connornishijima/Pixie_Chroma/extras/reports/README.md

### Library status report: 
#### Any undocumented objects currently seen after every CI test will be marked here.
---------------------------------------------------------
- :heavy_check_mark: Doxygen
- :heavy_check_mark: Keywords
