connornishijima/Pixie_Chroma/extras/reports/doxygen/README.md

### Doxygen coverage report: 
#### Any undocumented objects currently seen by Doxygen will appear here after every CI test!
---------------------------------------------------------
:heavy_check_mark: **All checks passed, nothing left undocumented!**
