connornishijima/Pixie_Chroma/extras/reports/keywords/README.md

### Keyword coverage report: 
#### Any undocumented keywords currently seen will appear here after every CI test!
---------------------------------------------------------
:heavy_check_mark: **All checks passed, nothing left undocumented!**
