connornishijima/Pixie_Chroma/extras/OSHW/EVAL_BOARD/README.md

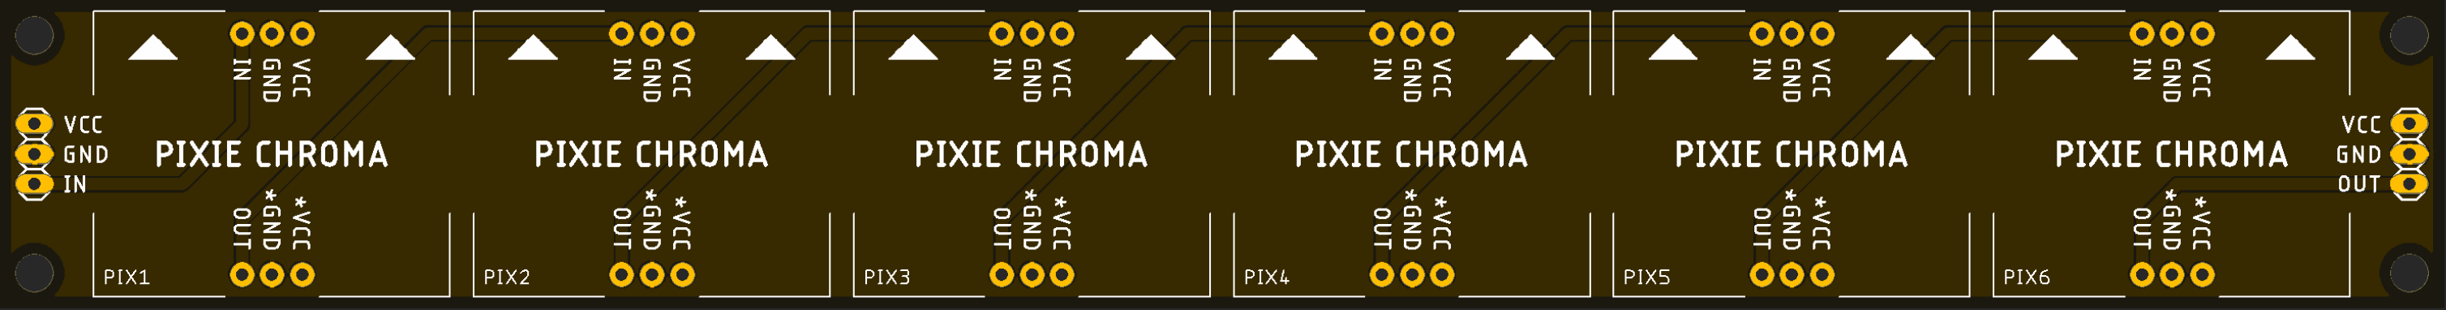
[picture p8: extras/OSHW/EVAL_BOARD/PCB.PNG]
PIXIE CHROMA EVAL PCB
