connornishijima/Pixie_Chroma/extras/OSHW/PCB/README.md

# Pixie Chroma PCB Files

Here you can find our OSHW files for building your own Pixie Chroma!

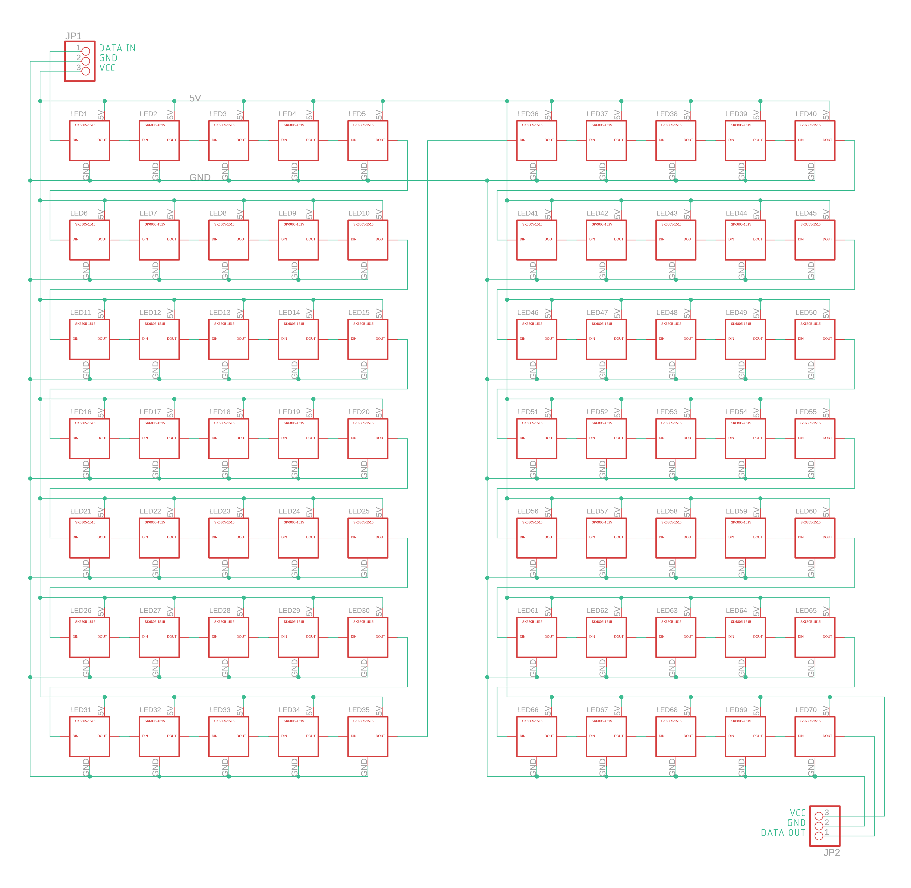
[picture p9: extras/img/schematic.png]
Schematic
