connornishijima/Pixie_Chroma/extras/img/close.png

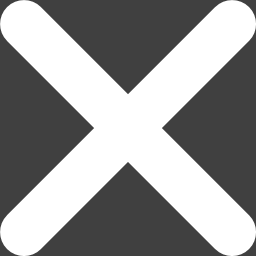
extras/img/close.png
