connornishijima/Pixie_Chroma/extras/img/modules.png

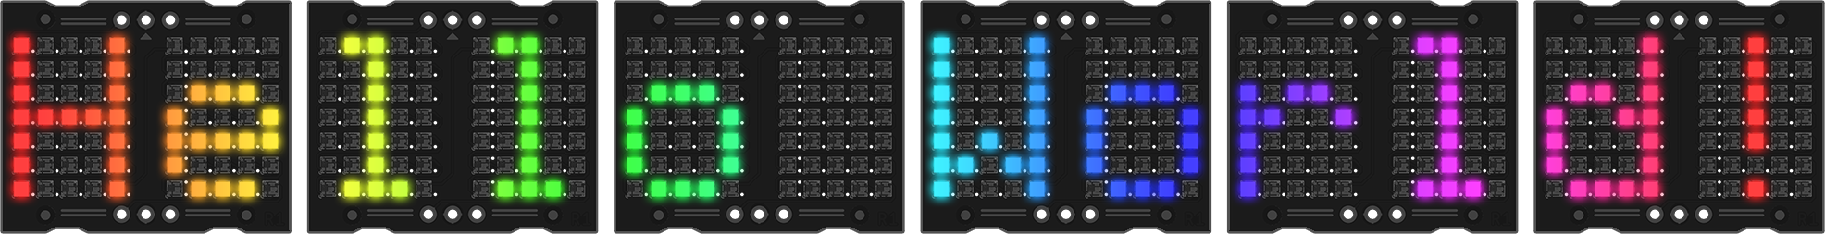
extras/img/modules.png
