connornishijima/Pixie_Chroma/extras/img/PCB_tranparent.png

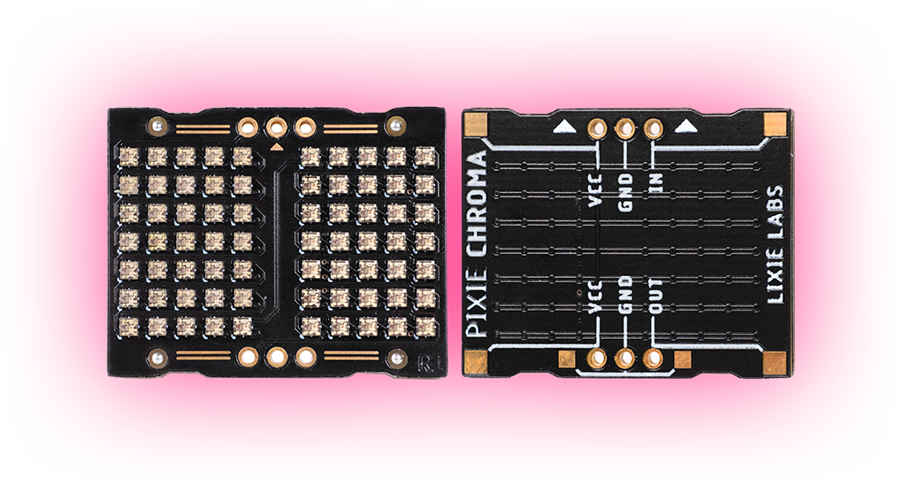
extras/img/PCB_tranparent.png
