connornishijima/Pixie_Chroma/extras/img/pinout.png

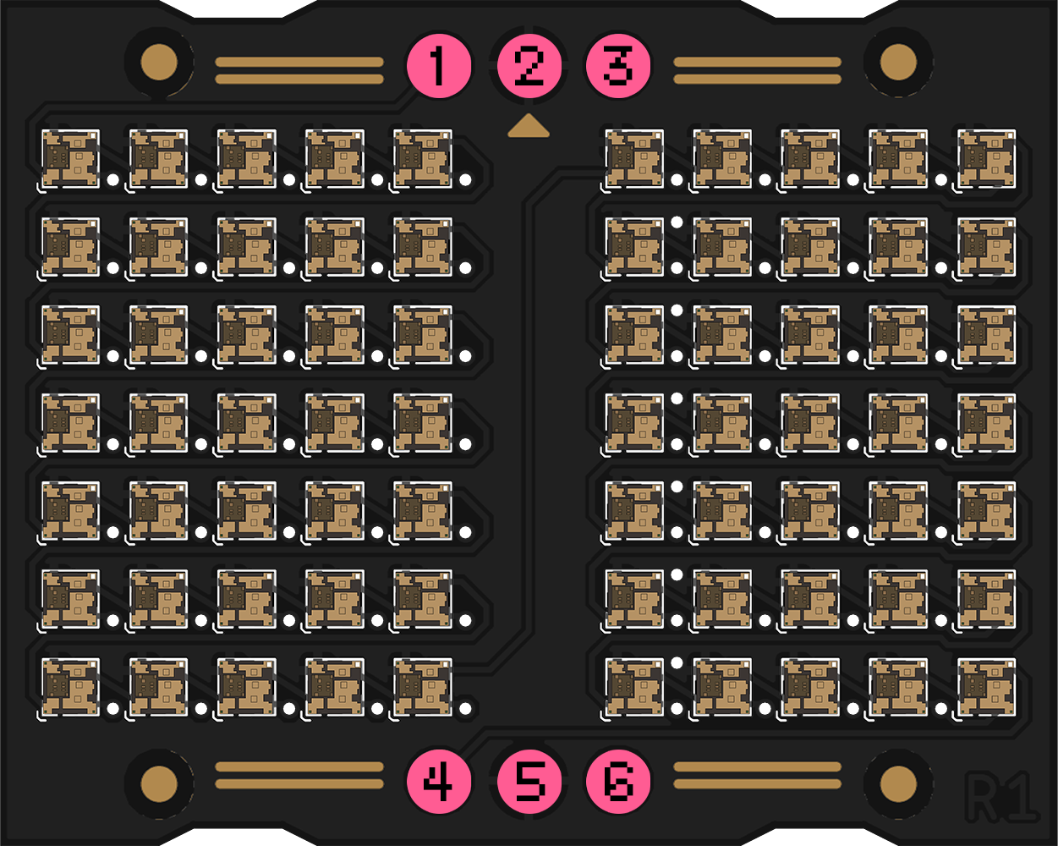
extras/img/pinout.png
