connornishijima/Pixie_Chroma/extras/img/rm1.jpg

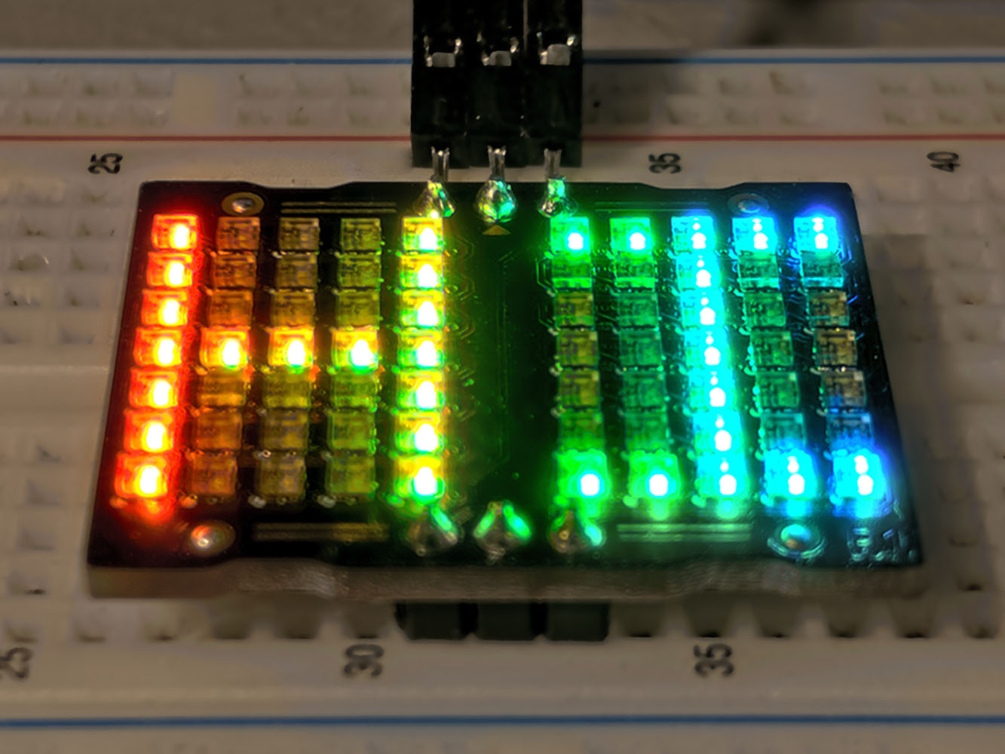
extras/img/rm1.jpg
