connornishijima/Pixie_Chroma/extras/img/rm2.jpg

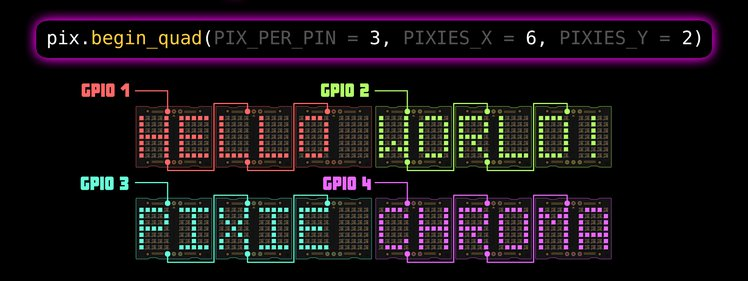
extras/img/rm2.jpg
