connornishijima/Pixie_Chroma/extras/img/rm3.jpg

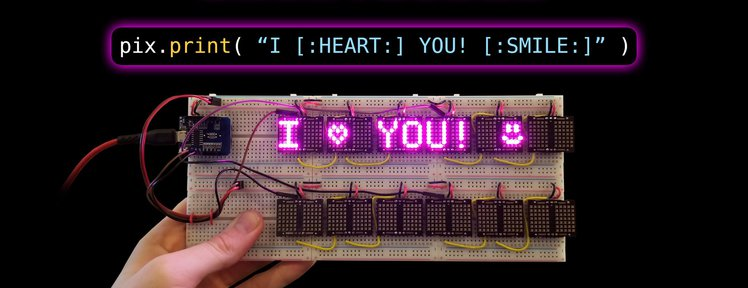
extras/img/rm3.jpg
