connornishijima/Pixie_Chroma/extras/img/vendor.png

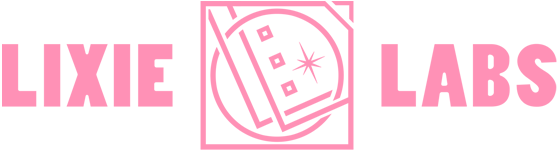
extras/img/vendor.png
