connornishijima/Pixie_Chroma/extras/OSHW/PCB/Pixie_Chroma.stl

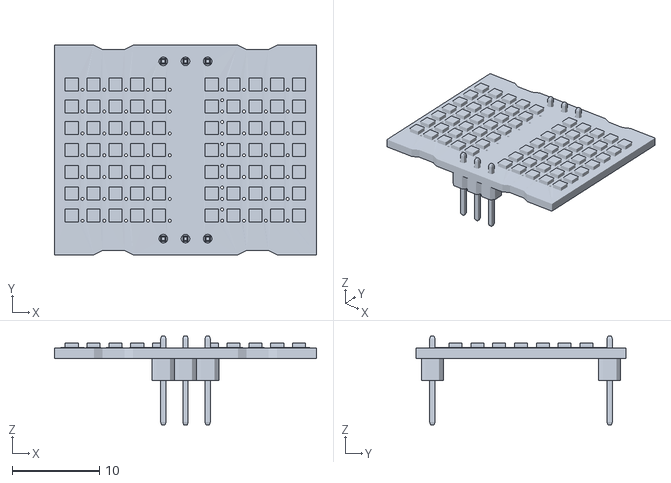
[picture p18: CAD file, 2021-12-28]
extras/OSHW/PCB/Pixie_Chroma.stl
30.0 x 24.0 x 10.2
