connornishijima/Pixie_Chroma/getting_started.html

# Loading...

This page was automatically rendered from the current version of getting_started.md (https://github.com/connornishijima/Pixie_Chroma/blob/main/getting_started.md).
