connornishijima/Pixie_Chroma/(threads)

Thread 44 (2021-11-12):

Example for live UART parsing to displays

connornishijima, 2021-11-12:
From Twitter:

> Worst case scenario I'll include a library example that parses live UART input to the displays with some special commands for setting color. That should allows tons of options that otherwise would need special porting.

https://twitter.com/lixielabs/status/1459255058164453376

connornishijima, 2021-11-15:
Hey @connornishijima I'm working on this

connornishijima, 2021-11-15:
Okay, thank you @connornishijima.

connornishijima, 2021-12-04:
Added as Serial_Monitor.ino!

Closed 2021-12-04.

Thread 56 (2022-04-06):

Be clear about chip support limitations

ladyada, 2022-04-06:
hiya it does not seem to be stated anywhere in the documentation that only ESP32, ESP8266 or Teensy 3 boards are the **only** chips supported by pixie chroma - however, this line in the code will not let it compile otherwise
https://github.com/connornishijima/Pixie_Chroma/blob/main/src/Pixie_Chroma.h#L56

can you clarify if that is correct, **only ESP32, ESP8266 or Teensy 3 boards can be used** and if so, where is that documented?

connornishijima, 2022-04-07:
Whoops, thank you! It had slipped my mind after all of the development process to add that in explicitly! (Also, wow, hi! You and others made this career possible for me.)

*Yes, Chroma only officially supports ESP8266, ESP32, and Teensy at the time of writing, due to RAM and FastLED compatibility limitations.*

There is now a snippet in the README about supported controllers, planned future support, and steps to help users add experimental support themselves.

https://github.com/connornishijima/Pixie_Chroma#supported-platforms

connornishijima, 2022-04-15:
*Quick note before closing this issue* - I've written a much better "Getting Started" guide for Pixie Chroma that Adafruit is more than welcome to link to when the time comes that they go up for sale:

https://connornishijima.github.io/Pixie_Chroma/?section=getting-started

Thank you again for your help!

ladyada, 2022-04-16:
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

clicking this link does not work

connornishijima, 2022-04-16:
Oops! That's a properly written URL, but it's trying to open an external HTTPS site (github.com) in the content iFrame, which violates CORS policy.

The page you saw is rendered with JavaScript directly from getting_started.md on this repo, I'll need to add some quick code in the morning that forces the parser to generate links with a `target="_parent"` attribute to force them to open in the parent window. Good catch!

connornishijima, 2022-04-16:
Fixed in [280b825](https://github.com/connornishijima/Pixie_Chroma/commit/280b825d3577c0d8093d7a7418cafe0be9bfe489).

ladyada, 2022-04-17:
ok great!

Closed 2022-04-15.

Thread 64 (2022-06-22):

cannot compile sample code

JimKruk, 2022-06-22:
I bought these from adafruit and am using the huzzah esp32 feather board and was following the tutorial here:
https://connornishijima.github.io/Pixie_Chroma/?section=getting-started

I installed the library (1.2.0) and then opened the sampled code:
Examples > Pixie_Chroma > 01_Basic > 01_Getting_Started

but when I try and compile it I get an error:
C:\Users\Jim\OneDrive\Documents\Arduino\libraries\Pixie_Chroma\src/Pixie_Chroma.h:74:138: fatal error: FastLED.h: No such file or directory

thanks

connornishijima, 2022-06-22:
Did you install the library manually by downloading the repo, or through the Arduino Library Manager?

"FastLED" is a second library this one depends on that should have been automatically installed - if not, just search "FastLED" in the same Library Manager window and install the latest version to see if that fixes it! :)

JimKruk, 2022-06-22:
I installed pixie chroma using the arduino manager library (was following the tutorial).  I just installed FastLED in the library manager and that worked, thanks !  The getting started tutorial was very well written, perhaps someone could include that step after installing the pixie chroma library.

JimKruk, 2022-06-22:
my arduino IDE is 1.8.5, good to know, thanks.  One of the reasons I decided to purchase these is your doc is very well written, easy to follow and has lots of examples.  For a beginner that is extremely helpful and encouraging to see someone take the time to publish good documentation, thanks !

connornishijima, 2022-06-22:
Thanks Jim! I'll add the Arduino IDE version note to the Getting Started Guide for others later today.

connornishijima, 2022-06-23:
Notes about minimum IDE version support and workaround notes for older versions added to getting_started.md in commit [f237a12](https://github.com/connornishijima/Pixie_Chroma/commit/f237a12af17912b89888e0cc71dc8f26aa637ef7)!

Shy, 2024-03-07:
Hey folks, I'm also having this issue. The libraries are being auto installed to FastLED 3.60. I'm getting a lot of errors related to FastLED.

This is using the current version of the Arduino IDE. Do you know if I need an older version of FastLed to make this work? I can't get the sample code or even the minimal example to run.

```
In file included from /Users/shy/Library/Arduino15/packages/esp32/tools/esp32-arduino-libs/idf-release_v5.1-3662303f31/esp32/include/esp_common/include/esp_macros.h:13,
                 from /Users/shy/Library/Arduino15/packages/esp32/tools/esp32-arduino-libs/idf-release_v5.1-3662303f31/esp32/include/freertos/FreeRTOS-Kernel/portable/xtensa/include/freertos/portmacro.h:76,
                 from /Users/shy/Library/Arduino15/packages/esp32/tools/esp32-arduino-libs/idf-release_v5.1-3662303f31/esp32/include/freertos/FreeRTOS-Kernel/include/freertos/portable.h:59,
                 from /Users/shy/Library/Arduino15/packages/esp32/tools/esp32-arduino-libs/idf-release_v5.1-3662303f31/esp32/include/freertos/FreeRTOS-Kernel/include/freertos/FreeRTOS.h:71,
                 from /Users/shy/Library/Arduino15/packages/esp32/hardware/esp32/3.0.0-alpha3/cores/esp32/Arduino.h:33,
                 from /private/var/folders/1p/hymkpcx11hj3hbnspzt0n84m0000gn/T/arduino/sketches/56EF4E59F7462CE253620D3C60494F15/sketch/01_Standard.ino.cpp:1:
/Users/shy/Documents/Arduino/libraries/FastLED/src/platforms/esp/32/clockless_i2s_esp32.h: In member function 'void ClocklessController<DATA_PIN, T1, T2, T3, RGB_ORDER, XTRA0, FLIP, WAIT_TIME>::init()':
/Users/shy/Documents/Arduino/libraries/FastLED/src/platforms/esp/32/clockless_i2s_esp32.h:234:25: error: 'GPIO_PIN_MUX_REG' was not declared in this scope; did you mean 'GPIO_PIN19_REG'?
  234 |         PIN_FUNC_SELECT(GPIO_PIN_MUX_REG[DATA_PIN], PIN_FUNC_GPIO);
      |                         ^~~~~~~~~~~~~~~~
/Users/shy/Library/Arduino15/packages/esp32/tools/esp32-arduino-libs/idf-release_v5.1-3662303f31/esp32/include/esp_common/include/esp_assert.h:24:38: note: in definition of macro 'TRY_STATIC_ASSERT'
   24 |             if (__builtin_constant_p(CONDITION) && !(CONDITION)) {          \
      |                                      ^~~~~~~~~
/Users/shy/Library/Arduino15/packages/esp32/tools/esp32-arduino-libs/idf-release_v5.1-3662303f31/esp32/include/soc/esp32/include/soc/soc.h:34:57: note: in expansion of macro 'IS_DPORT_REG'
   34 | #define ASSERT_IF_DPORT_REG(_r, OP)  TRY_STATIC_ASSERT(!IS_DPORT_REG(_r), (Cannot use OP for DPORT registers use DPORT_##OP));
      |                                                         ^~~~~~~~~~~~
/Users/shy/Library/Arduino15/packages/esp32/tools/esp32-arduino-libs/idf-release_v5.1-3662303f31/esp32/include/soc/esp32/include/soc/soc.h:83:13: note: in expansion of macro 'ASSERT_IF_DPORT_REG'
   83 |             ASSERT_IF_DPORT_REG((_r), REG_SET_FIELD);                                                                  \
      |             ^~~~~~~~~~~~~~~~~~~
/Users/shy/Library/Arduino15/packages/esp32/tools/esp32-arduino-libs/idf-release_v5.1-3662303f31/esp32/include/soc/esp32/include/soc/io_mux_reg.h:83:46: note: in expansion of macro 'REG_SET_FIELD'
   83 | #define PIN_FUNC_SELECT(PIN_NAME, FUNC)      REG_SET_FIELD(PIN_NAME, MCU_SEL, FUNC)
      |                                              ^~~~~~~~~~~~~
/Users/shy/Documents/Arduino/libraries/FastLED/src/platforms/esp/32/clockless_i2s_esp32.h:234:9: note: in expansion of macro 'PIN_FUNC_SELECT'
  234 |         PIN_FUNC_SELECT(GPIO_PIN_MUX_REG[DATA_PIN], PIN_FUNC_GPIO);
      |         ^~~~~~~~~~~~~~~
In file included from /Users/shy/Library/Arduino15/packages/esp32/tools/xtensa-esp32-elf-gcc/esp-12.2.0_20230208/xtensa-esp32-elf/sys-include/sys/reent.h:503,
                 from /Users/shy/Library/Arduino15/packages/esp32/tools/esp32-arduino-libs/idf-release_v5.1-3662303f31/esp32/include/newlib/platform_include/sys/reent.h:9,
                 from /Users/shy/Library/Arduino15/packages/esp32/tools/xtensa-esp32-elf-gcc/esp-12.2.0_20230208/xtensa-esp32-elf/sys-include/stdio.h:60,
                 from /Users/shy/Library/Arduino15/packages/esp32/hardware/esp32/3.0.0-alpha3/cores/esp32/Arduino.h:27:
/Users/shy/Documents/Arduino/libraries/FastLED/src/platforms/esp/32/clockless_i2s_esp32.h:234:25: error: 'GPIO_PIN_MUX_REG' was not declared in this scope; did you mean 'GPIO_PIN19_REG'?
  234 |         PIN_FUNC_SELECT(GPIO_PIN_MUX_REG[DATA_PIN], PIN_FUNC_GPIO);
      |                         ^~~~~~~~~~~~~~~~
/Users/shy/Library/Arduino15/packages/esp32/tools/esp32-arduino-libs/idf-release_v5.1-3662303f31/esp32/include/soc/esp32/include/soc/soc.h:34:38: note: in expansion of macro 'TRY_STATIC_ASSERT'
   34 | #define ASSERT_IF_DPORT_REG(_r, OP)  TRY_STATIC_ASSERT(!IS_DPORT_REG(_r), (Cannot use OP for DPORT registers use DPORT_##OP));
      |                                      ^~~~~~~~~~~~~~~~~
/Users/shy/Library/Arduino15/packages/esp32/tools/esp32-arduino-libs/idf-release_v5.1-3662303f31/esp32/include/soc/esp32/include/soc/soc.h:34:57: note: in expansion of macro 'IS_DPORT_REG'
   34 | #define ASSERT_IF_DPORT_REG(_r, OP)  TRY_STATIC_ASSERT(!IS_DPORT_REG(_r), (Cannot use OP for DPORT registers use DPORT_##OP));
      |                                                         ^~~~~~~~~~~~
/Users/shy/Library/Arduino15/packages/esp32/tools/esp32-arduino-libs/idf-release_v5.1-3662303f31/esp32/include/soc/esp32/include/soc/soc.h:83:13: note: in expansion of macro 'ASSERT_IF_DPORT_REG'
   83 |             ASSERT_IF_DPORT_REG((_r), REG_SET_FIELD);                                                                  \
      |             ^~~~~~~~~~~~~~~~~~~
/Users/shy/Library/Arduino15/packages/esp32/tools/esp32-arduino-libs/idf-release_v5.1-3662303f31/esp32/include/soc/esp32/include/soc/io_mux_reg.h:83:46: note: in expansion of macro 'REG_SET_FIELD'
   83 | #define PIN_FUNC_SELECT(PIN_NAME, FUNC)      REG_SET_FIELD(PIN_NAME, MCU_SEL, FUNC)
      |                                              ^~~~~~~~~~~~~
/Users/shy/Documents/Arduino/libraries/FastLED/src/platforms/esp/32/clockless_i2s_esp32.h:234:9: note: in expansion of macro 'PIN_FUNC_SELECT'
  234 |         PIN_FUNC_SELECT(GPIO_PIN_MUX_REG[DATA_PIN], PIN_FUNC_GPIO);
      |         ^~~~~~~~~~~~~~~
/Users/shy/Documents/Arduino/libraries/FastLED/src/platforms/esp/32/clockless_i2s_esp32.h:234:25: error: 'GPIO_PIN_MUX_REG' was not declared in this scope; did you mean 'GPIO_PIN19_REG'?
  234 |         PIN_FUNC_SELECT(GPIO_PIN_MUX_REG[DATA_PIN], PIN_FUNC_GPIO);
      |                         ^~~~~~~~~~~~~~~~
/Users/shy/Library/Arduino15/packages/esp32/tools/esp32-arduino-libs/idf-release_v5.1-3662303f31/esp32/include/esp_common/include/esp_assert.h:24:38: note: in definition of macro 'TRY_STATIC_ASSERT'
   24 |             if (__builtin_constant_p(CONDITION) && !(CONDITION)) {          \
      |                                      ^~~~~~~~~
/Users/shy/Library/Arduino15/packages/esp32/tools/esp32-arduino-libs/idf-release_v5.1-3662303f31/esp32/include/soc/esp32/include/soc/soc.h:34:57: note: in expansion of macro 'IS_DPORT_REG'
   34 | #define ASSERT_IF_DPORT_REG(_r, OP)  TRY_STATIC_ASSERT(!IS_DPORT_REG(_r), (Cannot use OP for DPORT registers use DPORT_##OP));
      |                                                         ^~~~~~~~~~~~
/Users/shy/Library/Arduino15/packages/esp32/tools/esp32-arduino-libs/idf-release_v5.1-3662303f31/esp32/include/soc/esp32/include/soc/soc.h:41:13: note: in expansion of macro 'ASSERT_IF_DPORT_REG'
   41 |             ASSERT_IF_DPORT_REG((_r), REG_WRITE);                                                                      \
      |             ^~~~~~~~~~~~~~~~~~~
/Users/shy/Library/Arduino15/packages/esp32/tools/esp32-arduino-libs/idf-release_v5.1-3662303f31/esp32/include/soc/esp32/include/soc/soc.h:84:13: note: in expansion of macro 'REG_WRITE'
   84 |             REG_WRITE((_r),((REG_READ(_r) & ~((_f##_V) << (_f##_S)))|(((_v) & (_f##_V))<<(_f##_S))));                  \
      |             ^~~~~~~~~
/Users/shy/Library/Arduino15/packages/esp32/tools/esp32-arduino-libs/idf-release_v5.1-3662303f31/esp32/include/soc/esp32/include/soc/io_mux_reg.h:83:46: note: in expansion of macro 'REG_SET_FIELD'
   83 | #define PIN_FUNC_SELECT(PIN_NAME, FUNC)      REG_SET_FIELD(PIN_NAME, MCU_SEL, FUNC)
      |                                              ^~~~~~~~~~~~~
/Users/shy/Documents/Arduino/libraries/FastLED/src/platforms/esp/32/clockless_i2s_esp32.h:234:9: note: in expansion of macro 'PIN_FUNC_SELECT'
  234 |         PIN_FUNC_SELECT(GPIO_PIN_MUX_REG[DATA_PIN], PIN_FUNC_GPIO);
      |         ^~~~~~~~~~~~~~~
/Users/shy/Documents/Arduino/libraries/FastLED/src/platforms/esp/32/clockless_i2s_esp32.h:234:25: error: 'GPIO_PIN_MUX_REG' was not declared in this scope; did you mean 'GPIO_PIN19_REG'?
  234 |         PIN_FUNC_SELECT(GPIO_PIN_MUX_REG[DATA_PIN], PIN_FUNC_GPIO);
      |                         ^~~~~~~~~~~~~~~~
/Users/shy/Library/Arduino15/packages/esp32/tools/esp32-arduino-libs/idf-release_v5.1-3662303f31/esp32/include/soc/esp32/include/soc/soc.h:34:38: note: in expansion of macro 'TRY_STATIC_ASSERT'
   34 | #define ASSERT_IF_DPORT_REG(_r, OP)  TRY_STATIC_ASSERT(!IS_DPORT_REG(_r), (Cannot use OP for DPORT registers use DPORT_##OP));
      |                                      ^~~~~~~~~~~~~~~~~
/Users/shy/Library/Arduino15/packages/esp32/tools/esp32-arduino-libs/idf-release_v5.1-3662303f31/esp32/include/soc/esp32/include/soc/soc.h:34:57: note: in expansion of macro 'IS_DPORT_REG'
   34 | #define ASSERT_IF_DPORT_REG(_r, OP)  TRY_STATIC_ASSERT(!IS_DPORT_REG(_r), (Cannot use OP for DPORT registers use DPORT_##OP));
      |                                                         ^~~~~~~~~~~~
/Users/shy/Library/Arduino15/packages/esp32/tools/esp32-arduino-libs/idf-release_v5.1-3662303f31/esp32/include/soc/esp32/include/soc/soc.h:41:13: note: in expansion of macro 'ASSERT_IF_DPORT_REG'
   41 |             ASSERT_IF_DPORT_REG((_r), REG_WRITE);                                                                      \
      |             ^~~~~~~~~~~~~~~~~~~
/Users/shy/Library/Arduino15/packages/esp32/tools/esp32-arduino-libs/idf-release_v5.1-3662303f31/esp32/include/soc/esp32/include/soc/soc.h:84:13: note: in expansion of macro 'REG_WRITE'
   84 |             REG_WRITE((_r),((REG_READ(_r) & ~((_f##_V) << (_f##_S)))|(((_v) & (_f##_V))<<(_f##_S))));                  \
      |             ^~~~~~~~~
/Users/shy/Library/Arduino15/packages/esp32/tools/esp32-arduino-libs/idf-release_v5.1-3662303f31/esp32/include/soc/esp32/include/soc/io_mux_reg.h:83:46: note: in expansion of macro 'REG_SET_FIELD'
   83 | #define PIN_FUNC_SELECT(PIN_NAME, FUNC)      REG_SET_FIELD(PIN_NAME, MCU_SEL, FUNC)
      |                                              ^~~~~~~~~~~~~
/Users/shy/Documents/Arduino/libraries/FastLED/src/platforms/esp/32/clockless_i2s_esp32.h:234:9: note: in expansion of macro 'PIN_FUNC_SELECT'
  234 |         PIN_FUNC_SELECT(GPIO_PIN_MUX_REG[DATA_PIN], PIN_FUNC_GPIO);
      |         ^~~~~~~~~~~~~~~
In file included from /Users/shy/Library/Arduino15/packages/esp32/tools/esp32-arduino-libs/idf-release_v5.1-3662303f31/esp32/include/esp_hw_support/include/esp_memory_utils.h:12,
                 from /Users/shy/Library/Arduino15/packages/esp32/tools/esp32-arduino-libs/idf-release_v5.1-3662303f31/esp32/include/freertos/FreeRTOS-Kernel/portable/xtensa/include/freertos/portmacro.h:79:
/Users/shy/Documents/Arduino/libraries/FastLED/src/platforms/esp/32/clockless_i2s_esp32.h:234:25: error: 'GPIO_PIN_MUX_REG' was not declared in this scope; did you mean 'GPIO_PIN19_REG'?
  234 |         PIN_FUNC_SELECT(GPIO_PIN_MUX_REG[DATA_PIN], PIN_FUNC_GPIO);
      |                         ^~~~~~~~~~~~~~~~
/Users/shy/Library/Arduino15/packages/esp32/tools/esp32-arduino-libs/idf-release_v5.1-3662303f31/esp32/include/soc/esp32/include/soc/soc.h:42:37: note: in definition of macro 'REG_WRITE'
   42 |             (*(volatile uint32_t *)(_r)) = (_v);                                                                       \
      |                                     ^~
/Users/shy/Library/Arduino15/packages/esp32/tools/esp32-arduino-libs/idf-release_v5.1-3662303f31/esp32/include/soc/esp32/include/soc/io_mux_reg.h:83:46: note: in expansion of macro 'REG_SET_FIELD'
   83 | #define PIN_FUNC_SELECT(PIN_NAME, FUNC)      REG_SET_FIELD(PIN_NAME, MCU_SEL, FUNC)
      |                                              ^~~~~~~~~~~~~
/Users/shy/Documents/Arduino/libraries/FastLED/src/platforms/esp/32/clockless_i2s_esp32.h:234:9: note: in expansion of macro 'PIN_FUNC_SELECT'
  234 |         PIN_FUNC_SELECT(GPIO_PIN_MUX_REG[DATA_PIN], PIN_FUNC_GPIO);
      |         ^~~~~~~~~~~~~~~
/Users/shy/Library/Arduino15/packages/esp32/tools/esp32-arduino-libs/idf-release_v5.1-3662303f31/esp32/include/soc/esp32/include/soc/soc.h:84:43: error: invalid operands of types 'void' and 'int' to binary 'operator&'
   84 |             REG_WRITE((_r),((REG_READ(_r) & ~((_f##_V) << (_f##_S)))|(((_v) & (_f##_V))<<(_f##_S))));                  \
      |                                           ^ ~~~~~~~~~~~~~~~~~~~~~~~
      |                                             |
      |                                             int
/Users/shy/Library/Arduino15/packages/esp32/tools/esp32-arduino-libs/idf-release_v5.1-3662303f31/esp32/include/soc/esp32/include/soc/soc.h:42:45: note: in definition of macro 'REG_WRITE'
   42 |             (*(volatile uint32_t *)(_r)) = (_v);                                                                       \
      |                                             ^~
/Users/shy/Library/Arduino15/packages/esp32/tools/esp32-arduino-libs/idf-release_v5.1-3662303f31/esp32/include/soc/esp32/include/soc/io_mux_reg.h:83:46: note: in expansion of macro 'REG_SET_FIELD'
   83 | #define PIN_FUNC_SELECT(PIN_NAME, FUNC)      REG_SET_FIELD(PIN_NAME, MCU_SEL, FUNC)
      |                                              ^~~~~~~~~~~~~
/Users/shy/Documents/Arduino/libraries/FastLED/src/platforms/esp/32/clockless_i2s_esp32.h:234:9: note: in expansion of macro 'PIN_FUNC_SELECT'
  234 |         PIN_FUNC_SELECT(GPIO_PIN_MUX_REG[DATA_PIN], PIN_FUNC_GPIO);
      |         ^~~~~~~~~~~~~~~
In file included from /Users/shy/Documents/Arduino/libraries/FastLED/src/platforms/esp/32/fastled_esp32.h:10,
                 from /Users/shy/Documents/Arduino/libraries/FastLED/src/platforms.h:42,
                 from /Users/shy/Documents/Arduino/libraries/FastLED/src/FastLED.h:68,
                 from /Users/shy/Documents/Arduino/libraries/Pixie_Chroma/src/Pixie_Chroma.h:74,
                 from /private/var/folders/1p/hymkpcx11hj3hbnspzt0n84m0000gn/T/.arduinoIDE-unsaved202427-5641-wmtqxt.ri22e/01_Standard/01_Standard.ino:1:
/Users/shy/Documents/Arduino/libraries/FastLED/src/platforms/esp/32/clockless_i2s_esp32.h:237:9: error: there are no arguments to 'gpio_matrix_out' that depend on a template parameter, so a declaration of 'gpio_matrix_out' must be available [-fpermissive]
  237 |         gpio_matrix_out(mPin, i2s_base_pin_index + my_index, false, false);
      |         ^~~~~~~~~~~~~~~
/Users/shy/Documents/Arduino/libraries/FastLED/src/platforms/esp/32/clockless_i2s_esp32.h:237:9: note: (if you use '-fpermissive', G++ will accept your code, but allowing the use of an undeclared name is deprecated)
In file included from /Users/shy/Documents/Arduino/libraries/Pixie_Chroma/src/utility/../utility/../Pixie_Chroma.h:80,
                 from /Users/shy/Documents/Arduino/libraries/Pixie_Chroma/src/utility/../utility/pixie_animations.h:13,
                 from /Users/shy/Documents/Arduino/libraries/Pixie_Chroma/src/utility/../Pixie_Chroma.h:79,
                 from /Users/shy/Documents/Arduino/libraries/Pixie_Chroma/src/utility/pixie_shortcodes.h:11,
                 from /Users/shy/Documents/Arduino/libraries/Pixie_Chroma/src/Pixie_Chroma.h:78:
/Users/shy/Documents/Arduino/libraries/Pixie_Chroma/src/utility/../utility/../pixie_chroma_internal.h: At global scope:
/Users/shy/Documents/Arduino/libraries/Pixie_Chroma/src/utility/../utility/../pixie_chroma_internal.h:74:32: error: 'void PixieChroma::write(long unsigned int, uint8_t, uint8_t)' cannot be overloaded with 'void PixieChroma::write(uint32_t, uint8_t, uint8_t)'
   74 |                 /*|*/     void write( long unsigned int input, uint8_t x_pos = 0, uint8_t y_pos = 0 ); // pretty much the same as uint32_t, but Arduino is stupid
      |                                ^~~~~
/Users/shy/Documents/Arduino/libraries/Pixie_Chroma/src/utility/../utility/../pixie_chroma_internal.h:72:28: note: previous declaration 'void PixieChroma::write(uint32_t, uint8_t, uint8_t)'
   72 |                 /*|*/ void write( uint32_t input, uint8_t x_pos = 0, uint8_t y_pos = 0 );
      |                            ^~~~~
/Users/shy/Documents/Arduino/libraries/Pixie_Chroma/src/utility/../utility/../pixie_chroma_internal.h:93:32: error: 'void PixieChroma::print(long unsigned int)' cannot be overloaded with 'void PixieChroma::print(uint32_t)'
   93 |                 /*|*/     void print( long unsigned int input ); // pretty much the same as uint32_t, but Arduino is stupid
      |                                ^~~~~
/Users/shy/Documents/Arduino/libraries/Pixie_Chroma/src/utility/../utility/../pixie_chroma_internal.h:91:28: note: previous declaration 'void PixieChroma::print(uint32_t)'
   91 |                 /*|*/ void print( uint32_t input );
      |                            ^~~~~
/Users/shy/Documents/Arduino/libraries/Pixie_Chroma/src/utility/../utility/../pixie_chroma_internal.h:107:32: error: 'void PixieChroma::println(long unsigned int)' cannot be overloaded with 'void PixieChroma::println(uint32_t)'
  107 |                 /*|*/     void println( long unsigned int input ); // pretty much the same as uint32_t, but Arduino is stupid
      |                                ^~~~~~~
/Users/shy/Documents/Arduino/libraries/Pixie_Chroma/src/utility/../utility/../pixie_chroma_internal.h:105:28: note: previous declaration 'void PixieChroma::println(uint32_t)'
  105 |                 /*|*/ void println( uint32_t input );
      |                            ^~~~~~~

```

Closed 2022-06-23.

Thread 67 (2022-08-07):

Reduce XY Table to only using fixed, single template map, instead of fresh calculating one the size of the matrix every begin()

connornishijima, 2022-08-07:
Keep a template map for a single display's worth of XY lookup table in `PROGMEM`, and do extra calculations during `xy()` calls to loop over it and discover the 1D indices of 2D coordinates in displays of any size, versus the current method of keeping an entire `int16_t[matrix_width * matrix_height]` map in RAM.

Thread 68 (2022-09-23):

Throws FastLED errors for ESP32-S2 and ESP32-S3

romkey, 2022-09-23:
**Describe the bug**
When building for an ESP32-S2 or ESP32-S3, Pixie_Chroma configures FastLED to use I2S support. Unfortunately FastLED's I2S code doesn't compile properly for these targets and throws errors.

The code in Pixie_Chroma that calls FastLED.addLeds<>() for different pins uses pins that are not available on the ESP32-S2 and ESP32-S3, causing FastLED to throw compile-time errors. It also doesn't allow for a few pins that are only available on those targets.

Pixie_Chroma also tries to use pin 27 for Quad Mode support. Pin 27 isn't available on the ESP32-S2 or ESP32-S3, and FastLED disallows it, throwing another error.

**To Reproduce**
Steps to reproduce the behavior:
1. Build any example using an ESP32-S2 or ESP32-S3 board as a target.

**Expected behavior**
Pixie Chroma should configure FastLED properly to build for ESP32-S2 and ESP32-S3 targets. FastLED's I2S support doesn't build properly for these targets, and it allows and disallows the use of different pins for these targets.

When building for an ESP32-S2 or ESP32-S3 Pixie Chroma should let FastLED use its default configuration and should allow the use of all available pins on those boards and not try to use unavailable pins (like pin 27).

**Screenshots**
FastLED I2S issues:
```
Compiling .pio/build/lolin_s2_mini/lib46f/Pixie_Chroma/utility/pixie_animations.cpp.o
In file included from .pio/libdeps/lolin_s2_mini/FastLED/src/platforms/esp/32/fastled_esp32.h:10,
                 from .pio/libdeps/lolin_s2_mini/FastLED/src/platforms.h:36,
                 from .pio/libdeps/lolin_s2_mini/FastLED/src/FastLED.h:54,
                 from .pio/libdeps/lolin_s2_mini/Pixie_Chroma/src/Pixie_Chroma.h:74,
                 from .pio/libdeps/lolin_s2_mini/Pixie_Chroma/src/pixie_chroma_internal.cpp:13:
.pio/libdeps/lolin_s2_mini/FastLED/src/platforms/esp/32/clockless_i2s_esp32.h: In static member function 'static void ClocklessController<DATA_PIN, T1, T2, T3, RGB_ORDER, XTRA0, FLIP, WAIT_TIME>::i2sInit()':
.pio/libdeps/lolin_s2_mini/FastLED/src/platforms/esp/32/clockless_i2s_esp32.h:458:20: error: 'I2S1' was not declared in this scope
             i2s = &I2S1;
                    ^~~~
.pio/libdeps/lolin_s2_mini/FastLED/src/platforms/esp/32/clockless_i2s_esp32.h:458:20: note: suggested alternative: 'I2S0'
             i2s = &I2S1;
                    ^~~~
                    I2S0
.pio/libdeps/lolin_s2_mini/FastLED/src/platforms/esp/32/clockless_i2s_esp32.h:459:34: error: 'PERIPH_I2S1_MODULE' was not declared in this scope
             periph_module_enable(PERIPH_I2S1_MODULE);
                                  ^~~~~~~~~~~~~~~~~~
.pio/libdeps/lolin_s2_mini/FastLED/src/platforms/esp/32/clockless_i2s_esp32.h:459:34: note: suggested alternative: 'PERIPH_I2S0_MODULE'
             periph_module_enable(PERIPH_I2S1_MODULE);
                                  ^~~~~~~~~~~~~~~~~~
                                  PERIPH_I2S0_MODULE
.pio/libdeps/lolin_s2_mini/FastLED/src/platforms/esp/32/clockless_i2s_esp32.h:460:31: error: 'ETS_I2S1_INTR_SOURCE' was not declared in this scope
             interruptSource = ETS_I2S1_INTR_SOURCE;
                               ^~~~~~~~~~~~~~~~~~~~
In file included from .pio/libdeps/lolin_s2_mini/FastLED/src/platforms/esp/32/fastled_esp32.h:10,
                 from .pio/libdeps/lolin_s2_mini/FastLED/src/platforms.h:36,
                 from .pio/libdeps/lolin_s2_mini/FastLED/src/FastLED.h:54,
                 from .pio/libdeps/lolin_s2_mini/Pixie_Chroma/src/utility/../Pixie_Chroma.h:74,
                 from .pio/libdeps/lolin_s2_mini/Pixie_Chroma/src/utility/pixie_animations.h:13,
                 from .pio/libdeps/lolin_s2_mini/Pixie_Chroma/src/utility/pixie_animations.cpp:10:
.pio/libdeps/lolin_s2_mini/FastLED/src/platforms/esp/32/clockless_i2s_esp32.h: In static member function 'static void ClocklessController<DATA_PIN, T1, T2, T3, RGB_ORDER, XTRA0, FLIP, WAIT_TIME>::i2sInit()':
.pio/libdeps/lolin_s2_mini/FastLED/src/platforms/esp/32/clockless_i2s_esp32.h:458:20: error: 'I2S1' was not declared in this scope
```
FastLED pin issues:
```
In file included from .pio/libdeps/lolin_s2_mini/FastLED/src/platforms/esp/32/fastled_esp32.h:10,
                 from .pio/libdeps/lolin_s2_mini/FastLED/src/platforms.h:36,
                 from .pio/libdeps/lolin_s2_mini/FastLED/src/FastLED.h:54,
                 from .pio/libdeps/lolin_s2_mini/Pixie_Chroma/src/Pixie_Chroma.h:74,
                 from .pio/libdeps/lolin_s2_mini/Pixie_Chroma/src/pixie_chroma_internal.cpp:13:
.pio/libdeps/lolin_s2_mini/FastLED/src/platforms/esp/32/clockless_i2s_esp32.h: In instantiation of 'class ClocklessController<27, 60, 150, 90, (EOrder)66, 0, false, 5>':
.pio/libdeps/lolin_s2_mini/FastLED/src/chipsets.h:578:7:   required from 'class WS2812Controller800Khz<27, (EOrder)66>'
.pio/libdeps/lolin_s2_mini/FastLED/src/FastLED.h:94:34:   required from 'class NEOPIXEL<27>'
.pio/libdeps/lolin_s2_mini/FastLED/src/FastLED.h:316:28:   required from 'static CLEDController& CFastLED::addLeds(CRGB*, int, int) [with CHIPSET = NEOPIXEL; unsigned char DATA_PIN = 27]'
.pio/libdeps/lolin_s2_mini/Pixie_Chroma/src/pixie_chroma_internal.cpp:265:3:   required from here
.pio/libdeps/lolin_s2_mini/FastLED/src/platforms/esp/32/clockless_i2s_esp32.h:205:46: error: static assertion failed: Invalid pin specified
     static_assert(FastPin<DATA_PIN>::validpin(), "Invalid pin specified");
                   ~~~~~~~~~~~~~~~~~~~~~~~~~~~^~

.pio/libdeps/lolin_s2_mini/FastLED/src/platforms/esp/32/clockless_i2s_esp32.h: In instantiation of 'class ClocklessController<22, 60, 150, 90, (EOrder)66, 0, false, 5>':
.pio/libdeps/lolin_s2_mini/FastLED/src/chipsets.h:578:7:   required from 'class WS2812Controller800Khz<22, (EOrder)66>'
.pio/libdeps/lolin_s2_mini/FastLED/src/FastLED.h:107:52:   required from 'class WS2812B<22, (EOrder)66>'
.pio/libdeps/lolin_s2_mini/FastLED/src/FastLED.h:304:39:   required from 'static CLEDController& CFastLED::addLeds(CRGB*, int, int) [with CHIPSET = WS2812B; unsigned char DATA_PIN = 22; EOrder RGB_ORDER = (EOrder)66]'
.pio/libdeps/lolin_s2_mini/Pixie_Chroma/src/pixie_chroma_internal.cpp:2619:86:   required from here
.pio/libdeps/lolin_s2_mini/FastLED/src/platforms/esp/32/clockless_i2s_esp32.h:205:46: error: static assertion failed: Invalid pin specified
```

I'm building with PlatformIO but I confirmed the same problems happen building with Arduino.

**Desktop (please complete the following information):**
 - FastLED 3.5.0
 - Pixie Chroma Version 1.2.0

**Additional context**
I'll submit a PR that should fix these problems. I've confirmed it works using a couple of different ESP32-S2 boards. For quad mode I substituted pin 26 for pin 27; I just picked that randomly and have no idea if you'd want to stick with that.

I added support in the CI file to test builds for both the S2 and S3 but I'm having lots of issues with CI failing in code I didn't touch, so that's not working.

I'd be happy to send you some ESP32-S2 and ESP32-S3 boards if you'd like.

The Pixie Chromas are really cool, nice job!

andyshinn, 2025-01-08:
I am not sure why the library was forcing I2S. I removed this bit to use RMT and it seems to be working fine on my ESP32S3. https://github.com/andyshinn/Pixie_Chroma/commit/8ca9552d74c5d13bb39cf70cf1a52aff2d4964c8

Thread 70 (2023-01-21):

FastLED interrupt is panicking on esp32

iamJoeTaylor, 2023-01-21:
**Describe the bug**
I had the same issue on a TinyPico and a Feather esp32. Calling `pix.begin` causes a failure in the `FastLED.show` method because Pixie Chroma is calling `noInterrupts`. FastLED is waiting for interrupts to fire but the interrupts have been disabled causing it to hang and fail with watchdog.

I had this code working in April of last year, but trying to flash it recently caused this issue. If I comment out the `noInterrupts` and `interrupts` calls in Pixie Chroma lib it is able to print to the LED screens.

**To Reproduce**
Steps to reproduce the behavior (using the Getting Started)
1. `pix.begin( DATA_PIN, PIXIES_X, PIXIES_Y );` with an esp32.
2. Build and upload with platform io
3. See error:
```
WARNING Found stack trace! Trying to decode it
WARNING Decoded 0x40091487: vListInsert at /Users/ficeto/Desktop/ESP32/ESP32S2/esp-idf-public/components/freertos/list.c:183
WARNING Decoded 0x400901a7: vTaskPlaceOnEventList at /Users/ficeto/Desktop/ESP32/ESP32S2/esp-idf-public/components/freertos/tasks.c:3566
WARNING Decoded 0x4008f52a: xQueueSemaphoreTake at /Users/ficeto/Desktop/ESP32/ESP32S2/esp-idf-public/components/freertos/queue.c:1688
WARNING Decoded 0x400f0181: ClocklessController<5, 60, 150, 90, (EOrder)66, 0, false, 5>::showPixels(PixelController<(EOrder)66, 1, 4294967295u>&) at /Users/joetaylor/Development/esphome-pixie-chroma/.esphome/build/pixie-chroma/.piolibdeps/pixie-chroma/FastLED/platforms/esp/32/clockless_i2s_esp32.h:582
 (inlined by) ClocklessController<5, 60, 150, 90, (EOrder)66, 0, false, 5>::showPixels(PixelController<(EOrder)66, 1, 4294967295u>&) at /Users/joetaylor/Development/esphome-pixie-chroma/.esphome/build/pixie-chroma/.piolibdeps/pixie-chroma/FastLED/platforms/esp/32/clockless_i2s_esp32.h:546
WARNING Decoded 0x400e5529: CPixelLEDController<(EOrder)66, 1, 4294967295u>::show(CRGB const*, int, CRGB) at /Users/joetaylor/Development/esphome-pixie-chroma/.esphome/build/pixie-chroma/.piolibdeps/pixie-chroma/FastLED/controller.h:408
WARNING Decoded 0x400d2771: CLEDController::showLeds(unsigned char) at /Users/joetaylor/Development/esphome-pixie-chroma/.esphome/build/pixie-chroma/.piolibdeps/pixie-chroma/FastLED/controller.h:90
 (inlined by) CFastLED::show(unsigned char) at /Users/joetaylor/Development/esphome-pixie-chroma/.esphome/build/pixie-chroma/.piolibdeps/pixie-chroma/FastLED/FastLED.cpp:59
WARNING Decoded 0x400e2ef1: CFastLED::show() at /Users/joetaylor/Development/esphome-pixie-chroma/.esphome/build/pixie-chroma/.piolibdeps/pixie-chroma/FastLED/FastLED.h:500
 (inlined by) PixieChroma::show() at /Users/joetaylor/Development/esphome-pixie-chroma/.esphome/build/pixie-chroma/.piolibdeps/pixie-chroma/Pixie_Chroma/src/pixie_chroma_internal.cpp:2419
WARNING Decoded 0x400e2f25: PixieChroma::set_animation(void (*)(PixieChroma*, float)) at /Users/joetaylor/Development/esphome-pixie-chroma/.esphome/build/pixie-chroma/.piolibdeps/pixie-chroma/Pixie_Chroma/src/pixie_chroma_internal.cpp:346
WARNING Decoded 0x400e391c: PixieChroma::begin(unsigned char, unsigned char, unsigned char) at /Users/joetaylor/Development/esphome-pixie-chroma/.esphome/build/pixie-chroma/.piolibdeps/pixie-chroma/Pixie_Chroma/src/pixie_chroma_internal.cpp:105
```

(Note: this error is from my espHome module but the same error and trace happens from a fresh arduino platform io build as well)

**Expected behavior**
Begin should no panic at Watchdog causing any programs to fail.

**Desktop (please complete the following information):**
 - framework-arduinoespressif32 @ 3.20006.221224 (2.0.6)
Dependency Graph
|-- Pixie_Chroma @ 1.2.0
|   |-- Ticker @ 2.0.0
|   |-- FastLED @ 3.5.0
|   |   |-- SPI @ 2.0.0

romkey, 2023-06-14:
I can confirm; I see the same problem with both a regular ESP32 and an ESP32-S2. Removing the interrupt lockout solves the issue for me as well.

romkey, 2023-06-14:
This problem happens with both PlatformIO and Arduino IDE.

Arduino framework 2.0.4 is the last version that doesn't crash this way. More recent versions do. Not sure what the change was that brings out the problem.

 @connornishijima do you remember why you were disabling interrupts for this section of code?

Thread 71 (2023-01-29):

PixieChroma::set_update_mode(t_update_mode, uint16_t)

strain1, 2023-01-29:
In member function 'void PixieChroma::set_update_mode(t_update_mode, uint16_t)':
C:\Users\Cicero\Documents\Arduino\libraries\Pixie_Chroma\src\pixie_chroma_internal.cpp:521:4:
error: no matching function for call to 'Ticker::attach_ms<PixieChroma*>
(float, PixieChroma::set_update_mode(t_update_mode, uint16_t)::<lambda(PixieChroma*)>, PixieChroma*)'
  521 |    );
      |    ^

In file included from C:\Users\Cicero\Documents\Arduino\libraries\Pixie_Chroma\src\Pixie_Chroma.h:58,
                 from C:\Users\Cicero\Documents\Arduino\libraries\Pixie_Chroma\src\pixie_chroma_internal.cpp:10:
C:\Users\Cicero\AppData\Local\Arduino15\packages\esp8266\hardware\esp8266\3.1.1\libraries\Ticker\src/Ticker.h:116:10:
note: candidate: 'template<class Func, class Arg> void Ticker::attach_ms(uint32_t, Func, Arg)'
  116 |     void attach_ms(uint32_t milliseconds, Func func, Arg arg)
      |          ^~~~~~~~~

Thread 72 (2023-01-29):

ISO C++ forbids converting a string constant to 'char*'

strain1, 2023-01-29:
C:\Users\Cicero\Documents\Arduino\libraries\Pixie_Chroma\src\pixie_chroma_internal.cpp: In member function 'bool PixieChroma::unit_tests()':
C:\Users\Cicero\Documents\Arduino\libraries\Pixie_Chroma\src\pixie_chroma_internal.cpp:
3036:18: warning: ISO C++ forbids converting a string constant to 'char*' [-Wwrite-strings]
 3036 |  char* border  = "+---------------------------------------------+";
      |                  ^~~~~~~~~~~~~~~~~~~~~~~~~~~~~~~~~~~~~~~~~~~~~~~~~
C:\Users\Cicero\Documents\Arduino\libraries\Pixie_Chroma\src\pixie_chroma_internal.cpp:
3038:18: warning: ISO C++ forbids converting a string constant to 'char*' [-Wwrite-strings]
 3038 |  char* testing = "Testing: ";
      |                  ^~~~~~~~~~~
C:\Users\Cicero\Documents\Arduino\libraries\Pixie_Chroma\src\pixie_chroma_internal.cpp:
3039:18: warning: ISO C++ forbids converting a string constant to 'char*' [-Wwrite-strings]
 3039 |  char* PASS    = "PASS";
      |                  ^~~~~~
C:\Users\Cicero\Documents\Arduino\libraries\Pixie_Chroma\src\pixie_chroma_internal.cpp:
3040:18: warning: ISO C++ forbids converting a string constant to 'char*' [-Wwrite-strings]
 3040 |  char* FAIL    = "FAIL\n--------------------------------------------------------- #####";
      |                  ^~~~~~~~~~~~~~~~~~~~~~~~~~~~~~~~~~~~~~~~~~~~~~~~~~~~~~~~~~~~~~~~~~~~~~~
C:\Users\Cicero\Documents\Arduino\libraries\Pixie_Chroma\src\pixie_chroma_internal.cpp:
3073:9: warning: ISO C++ forbids converting a string constant to 'char*' [-Wwrite-strings]
 3073 |   print("------------------------");
      |         ^~~~~~~~~~~~~~~~~~~~~~~~~~
C:\Users\Cicero\Documents\Arduino\libraries\Pixie_Chroma\src\pixie_chroma_internal.cpp:3157:8:
warning: ISO C++ forbids converting a string constant to 'char*' [-Wwrite-strings]
 3157 |  print("------------------------");

strain1, 2023-01-30:
In file FastLed.h put this:
#if __cplusplus >= 201703L
#define register // keyword 'register' is banned with c++17
#endif

Closed 2023-01-30.

Thread 73 (2023-11-13):

Cannot convert CRGB to uint8_t

tomasro, 2023-11-13:
**Describe the bug**
Error while compiling code:
...\Arduino\libraries\Pixie_Chroma\src\pixie_chroma_internal.cpp: In member function 'void PixieChroma::color_blur_x(fract8)':
...\Arduino\libraries\Pixie_Chroma\src\pixie_chroma_internal.cpp:1874:25: error: cannot convert 'CRGB' to 'uint8_t' {aka 'unsigned char'} in assignment
carryover = part;
                   ^~~~

tomasro, 2023-11-15:
Also happens with IDE 1.8, and the only thing I had in my test code was #include "Pixie_chroma.h"

tomasro, 2023-11-15:
Turns out this error is caused because of FastLED 3.6. Reverting to 3.5 clears the error, but now there is a CPU panic when running pix.begin()

AlainVagner, 2024-03-23:
I had a similar issue, here is what I did to solve it. I am using an esp32.
I rolled back to the following versions:

- Arduino SDK 1.8.19
- esp32 SDK version 3.0.2 in the board manager (this version appears in a screenshot on the "getting started" page).
- FastLED v3.5

strain10280, 2024-06-09:
esp32 SDK versão 2.0.3

strain10280, 2024-06-09:
ESP32 SDK 2.0.9 works fine

andyshinn, 2025-01-08:
Sorry for the whitespace changes but see https://github.com/andyshinn/Pixie_Chroma/commit/a51597a74aed737822ae0c20c333d1cb8d6bd625 for a fix.
