connornishijima/Pixie_Chroma/extras/OSHW/EVAL_BOARD/PIXIE_CHROMA_EVAL_PCB.brd

## EAGLE design extras/OSHW/EVAL_BOARD/PIXIE_CHROMA_EVAL_PCB.brd (2021-12-28)

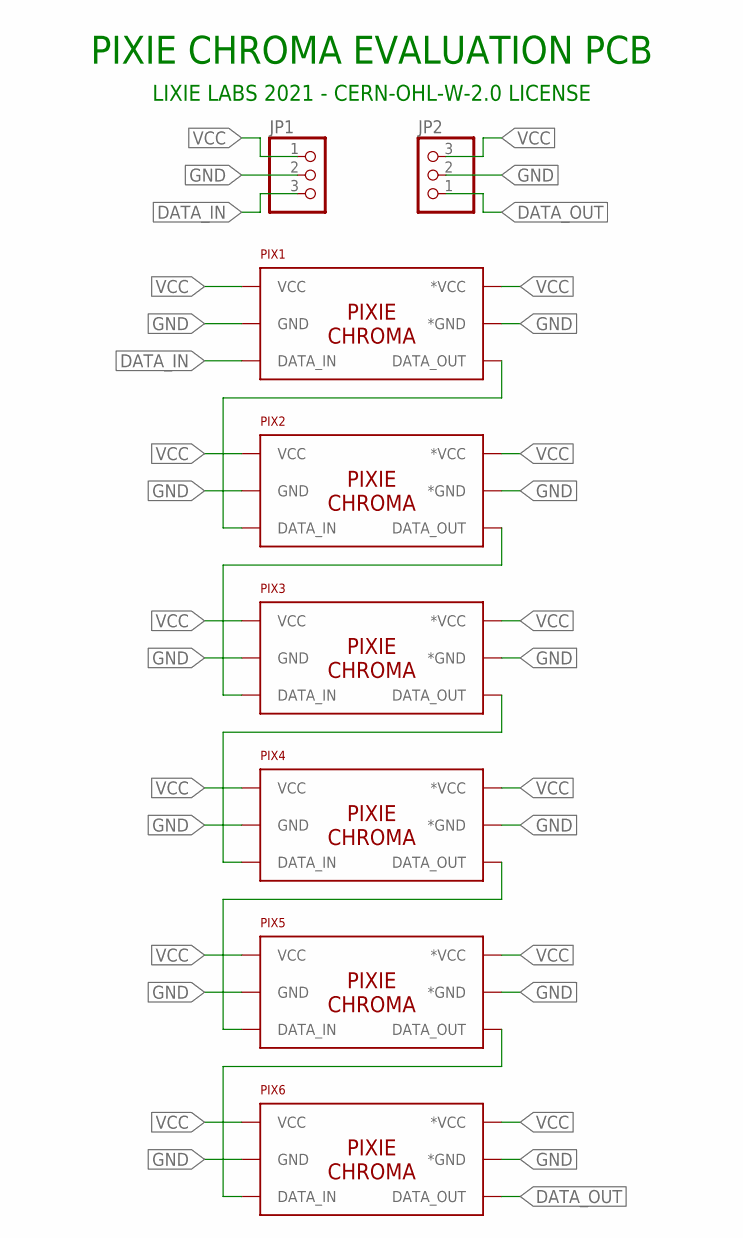
[picture p36: schematic PIXIE_CHROMA_EVAL_PCB.sch]

Parts:
JP1, JP2: PINHD-1X3; 1X03
PIX1, PIX2, PIX3, PIX4, PIX5, PIX6: CHROMA

Connections:
DATA_IN: JP1.3, PIX1.DATA_IN
DATA_OUT: JP2.1, PIX6.DATA_OUT
GND: JP1.2, JP2.2, PIX1.*GND, PIX1.GND, PIX2.*GND, PIX2.GND, PIX3.*GND, PIX3.GND, PIX4.*GND, PIX4.GND, PIX5.*GND, PIX5.GND, PIX6.*GND, PIX6.GND
unnamed: PIX1.DATA_OUT, PIX2.DATA_IN
unnamed: PIX2.DATA_OUT, PIX3.DATA_IN
unnamed: PIX3.DATA_OUT, PIX4.DATA_IN
unnamed: PIX4.DATA_OUT, PIX5.DATA_IN
unnamed: PIX5.DATA_OUT, PIX6.DATA_IN
VCC: JP1.1, JP2.3, PIX1.*VCC, PIX1.VCC, PIX2.*VCC, PIX2.VCC, PIX3.*VCC, PIX3.VCC, PIX4.*VCC, PIX4.VCC, PIX5.*VCC, PIX5.VCC, PIX6.*VCC, PIX6.VCC

Notes on the sheet:
PIXIE CHROMA EVALUATION PCB
LIXIE LABS 2021 - CERN-OHL-W-2.0 LICENSE

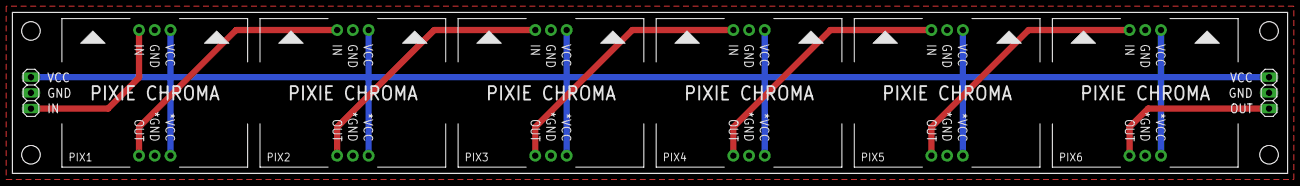
[picture p37: board PIXIE_CHROMA_EVAL_PCB.brd from above]

Board: 2 copper layers, 206.0 x 26.0 mm, 8 parts (0 on the bottom side), 9 nets.
