connornishijima/Pixie_Chroma/extras/OSHW/PCB/PixieChroma.brd

## EAGLE design extras/OSHW/PCB/PixieChroma.brd (2021-10-30)

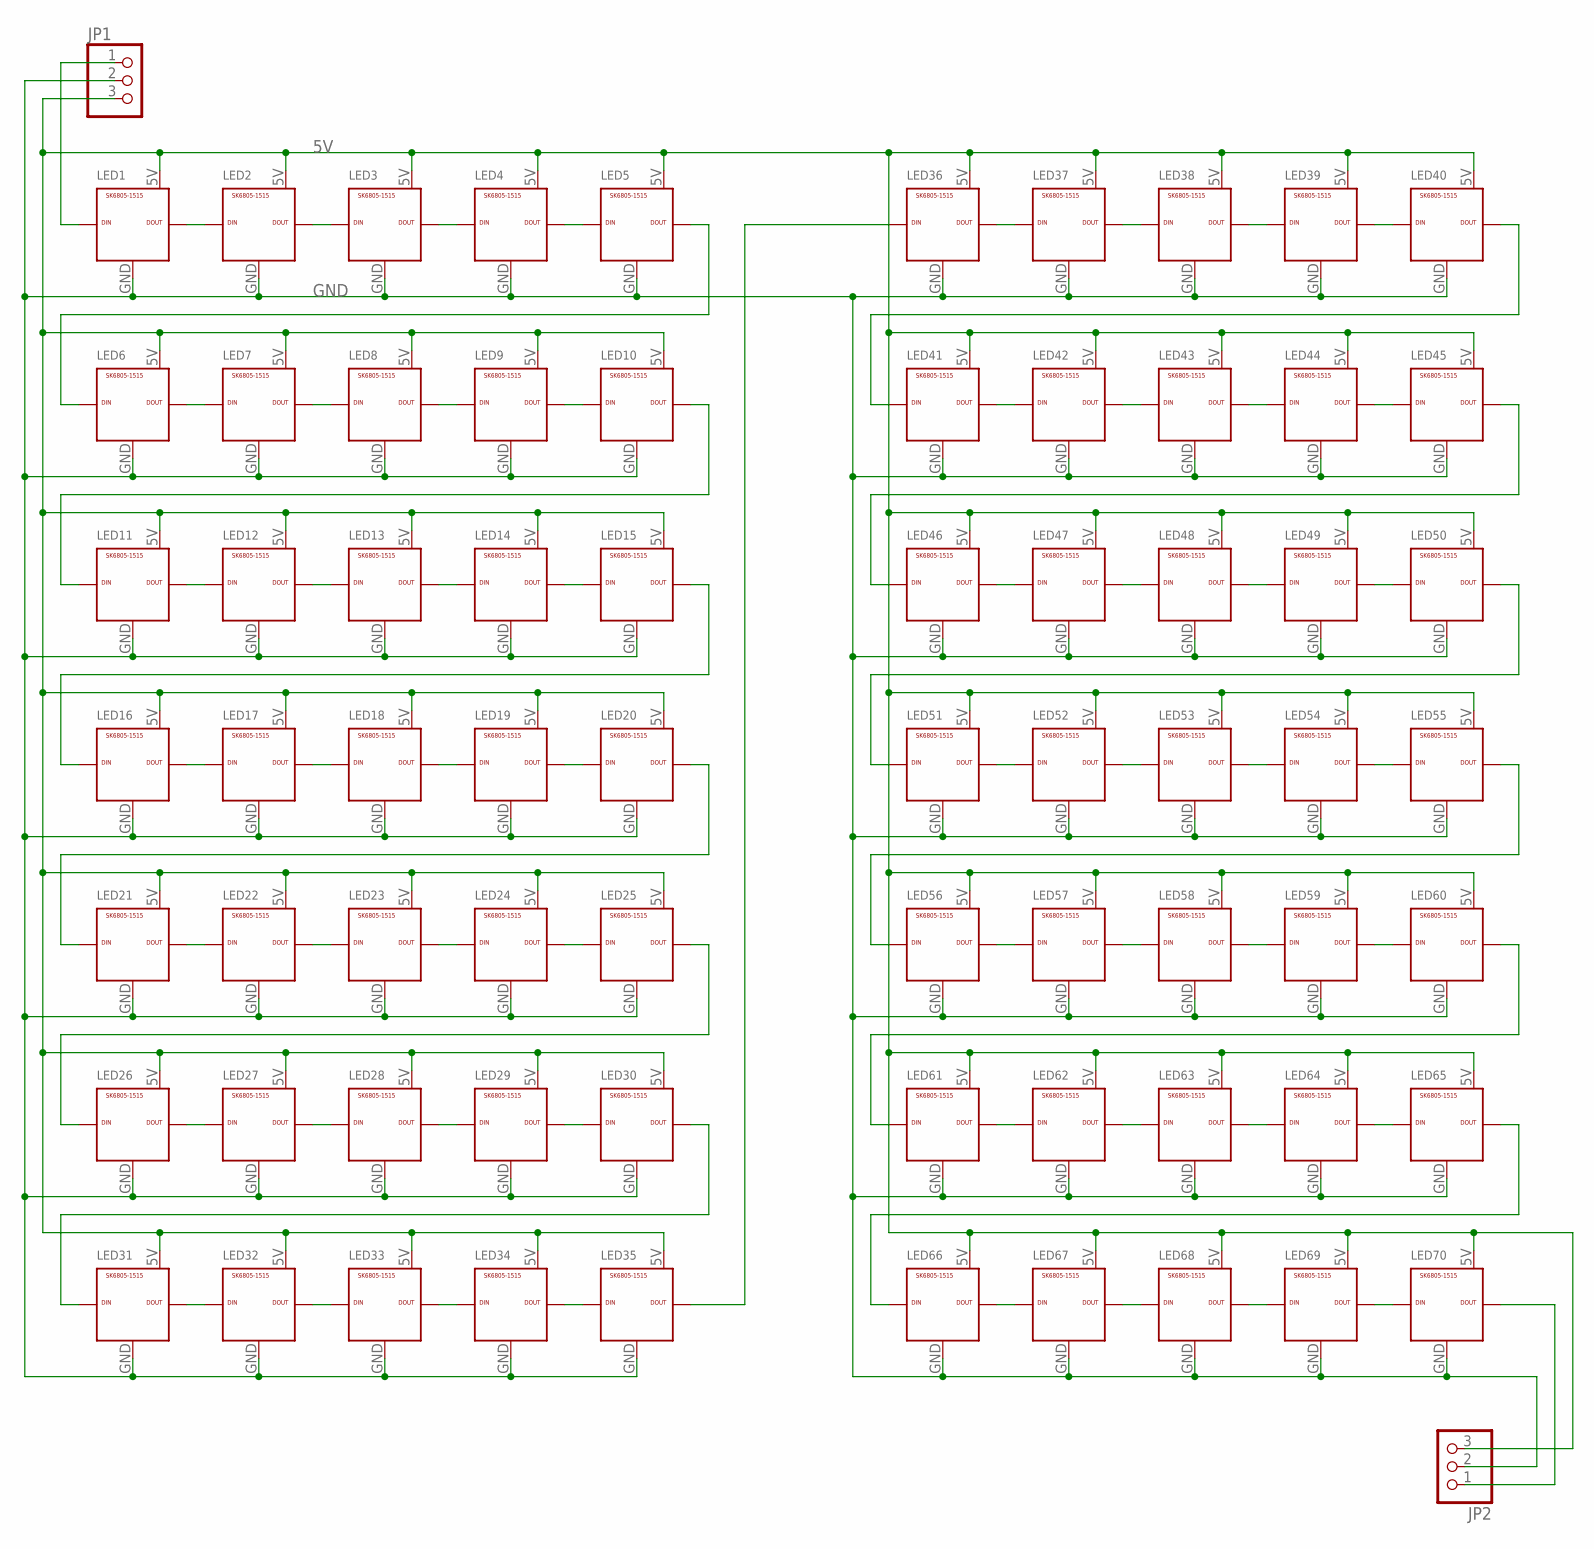
[picture p38: schematic PixieChroma.sch]

Parts:
JP1, JP2: PINHD-1X3; 1X03
LED1, LED2, LED3, LED4, LED5, LED6, LED7, LED8, LED9, LED10, LED11, LED12, LED13, LED14, LED15, LED16, LED17, LED18, LED19, LED20, LED21, LED22, LED23, LED24, LED25, LED26, LED27, LED28, LED29, LED30, LED31, LED32, LED33, LED34, LED35, LED36, LED37, LED38, LED39, LED40, LED41, LED42, LED43, LED44, LED45, LED46, LED47, LED48, LED49, LED50, LED51, LED52, LED53, LED54, LED55, LED56, LED57, LED58, LED59, LED60, LED61, LED62, LED63, LED64, LED65, LED66, LED67, LED68, LED69, LED70: SK6805-1515; 1515

Connections:
5V: JP1.3, JP2.3, LED1.5V, LED2.5V, LED3.5V, LED4.5V, LED5.5V, LED6.5V, LED7.5V, LED8.5V, LED9.5V, LED10.5V, LED11.5V, LED12.5V, LED13.5V, LED14.5V, LED15.5V, LED16.5V, LED17.5V, LED18.5V, LED19.5V, LED20.5V, LED21.5V, LED22.5V, LED23.5V, LED24.5V, LED25.5V, LED26.5V, LED27.5V, LED28.5V, LED29.5V, LED30.5V, LED31.5V, LED32.5V, LED33.5V, LED34.5V, LED35.5V, LED36.5V, LED37.5V, LED38.5V, LED39.5V, LED40.5V, LED41.5V, LED42.5V, LED43.5V, LED44.5V, LED45.5V, LED46.5V, LED47.5V, LED48.5V, LED49.5V, LED50.5V, LED51.5V, LED52.5V, LED53.5V, LED54.5V, LED55.5V, LED56.5V, LED57.5V, LED58.5V, LED59.5V, LED60.5V, LED61.5V, LED62.5V, LED63.5V, LED64.5V, LED65.5V, LED66.5V, LED67.5V, LED68.5V, LED69.5V, LED70.5V
DIN: JP1.1, LED1.DIN
DOUT: JP2.1, LED70.DOUT
GND: JP1.2, JP2.2, LED1.GND, LED2.GND, LED3.GND, LED4.GND, LED5.GND, LED6.GND, LED7.GND, LED8.GND, LED9.GND, LED10.GND, LED11.GND, LED12.GND, LED13.GND, LED14.GND, LED15.GND, LED16.GND, LED17.GND, LED18.GND, LED19.GND, LED20.GND, LED21.GND, LED22.GND, LED23.GND, LED24.GND, LED25.GND, LED26.GND, LED27.GND, LED28.GND, LED29.GND, LED30.GND, LED31.GND, LED32.GND, LED33.GND, LED34.GND, LED35.GND, LED36.GND, LED37.GND, LED38.GND, LED39.GND, LED40.GND, LED41.GND, LED42.GND, LED43.GND, LED44.GND, LED45.GND, LED46.GND, LED47.GND, LED48.GND, LED49.GND, LED50.GND, LED51.GND, LED52.GND, LED53.GND, LED54.GND, LED55.GND, LED56.GND, LED57.GND, LED58.GND, LED59.GND, LED60.GND, LED61.GND, LED62.GND, LED63.GND, LED64.GND, LED65.GND, LED66.GND, LED67.GND, LED68.GND, LED69.GND, LED70.GND
unnamed: LED3.DOUT, LED4.DIN
unnamed: LED2.DOUT, LED3.DIN
unnamed: LED1.DOUT, LED2.DIN
unnamed: LED4.DOUT, LED5.DIN
unnamed: LED18.DOUT, LED19.DIN
unnamed: LED8.DOUT, LED9.DIN
unnamed: LED7.DOUT, LED8.DIN
unnamed: LED6.DOUT, LED7.DIN
unnamed: LED9.DOUT, LED10.DIN
unnamed: LED13.DOUT, LED14.DIN
unnamed: LED5.DOUT, LED6.DIN
unnamed: LED17.DOUT, LED18.DIN
unnamed: LED12.DOUT, LED13.DIN
unnamed: LED11.DOUT, LED12.DIN
unnamed: LED14.DOUT, LED15.DIN
unnamed: LED10.DOUT, LED11.DIN
unnamed: LED16.DOUT, LED17.DIN
unnamed: LED19.DOUT, LED20.DIN
unnamed: LED15.DOUT, LED16.DIN
unnamed: LED23.DOUT, LED24.DIN
unnamed: LED22.DOUT, LED23.DIN
unnamed: LED21.DOUT, LED22.DIN
unnamed: LED24.DOUT, LED25.DIN
unnamed: LED20.DOUT, LED21.DIN
unnamed: LED28.DOUT, LED29.DIN
unnamed: LED27.DOUT, LED28.DIN
unnamed: LED26.DOUT, LED27.DIN
unnamed: LED29.DOUT, LED30.DIN
unnamed: LED25.DOUT, LED26.DIN
unnamed: LED33.DOUT, LED34.DIN
unnamed: LED32.DOUT, LED33.DIN
unnamed: LED31.DOUT, LED32.DIN
unnamed: LED34.DOUT, LED35.DIN
unnamed: LED30.DOUT, LED31.DIN
unnamed: LED38.DOUT, LED39.DIN
unnamed: LED37.DOUT, LED38.DIN
unnamed: LED36.DOUT, LED37.DIN
unnamed: LED39.DOUT, LED40.DIN
unnamed: LED35.DOUT, LED36.DIN
unnamed: LED43.DOUT, LED44.DIN
unnamed: LED42.DOUT, LED43.DIN
unnamed: LED41.DOUT, LED42.DIN
unnamed: LED44.DOUT, LED45.DIN
unnamed: LED40.DOUT, LED41.DIN
unnamed: LED48.DOUT, LED49.DIN
unnamed: LED47.DOUT, LED48.DIN
unnamed: LED46.DOUT, LED47.DIN
unnamed: LED49.DOUT, LED50.DIN
unnamed: LED45.DOUT, LED46.DIN
unnamed: LED53.DOUT, LED54.DIN
unnamed: LED52.DOUT, LED53.DIN
unnamed: LED51.DOUT, LED52.DIN
unnamed: LED54.DOUT, LED55.DIN
unnamed: LED50.DOUT, LED51.DIN
unnamed: LED58.DOUT, LED59.DIN
unnamed: LED57.DOUT, LED58.DIN
unnamed: LED56.DOUT, LED57.DIN
unnamed: LED59.DOUT, LED60.DIN
unnamed: LED55.DOUT, LED56.DIN
unnamed: LED63.DOUT, LED64.DIN
unnamed: LED62.DOUT, LED63.DIN
unnamed: LED61.DOUT, LED62.DIN
unnamed: LED64.DOUT, LED65.DIN
unnamed: LED60.DOUT, LED61.DIN
unnamed: LED68.DOUT, LED69.DIN
unnamed: LED67.DOUT, LED68.DIN
unnamed: LED66.DOUT, LED67.DIN
unnamed: LED69.DOUT, LED70.DIN
unnamed: LED65.DOUT, LED66.DIN

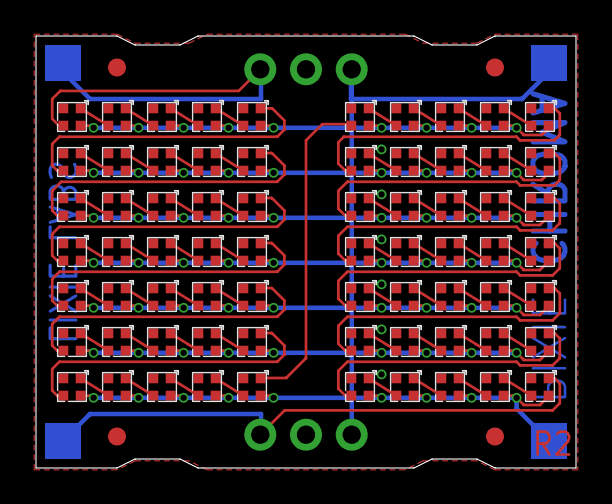
[picture p39: board PixieChroma.brd from above]

Board: 2 copper layers, 30.0 x 24.0 mm, 76 parts (0 on the bottom side), 73 nets.

Other parts of the board:
U$1, U$2, U$3, U$4: CIRCLE-1MM-2R
