connornishijima/Pixie_Chroma/src/pixie_chroma_internal.cpp

/*!
 * @file pixie_chroma_internal.cpp
 *
 * Designed specifically to work with Pixie Chroma:
 * ----> https://lixielabs.com/chroma
 *
 * Last Updated by Connor Nishijima on 12/3/21
 */

// TODO: Make print() and write() calls allocate proper char array size
// ...for each variable type, instead of just 32 chars no matter the type.

#include "Pixie_Chroma.h" 
#include "utility/pixie_utility.h"

// ---------------------------------------------------------------------------------------------------------|
// -- PUBLIC CLASS FUNCTIONS -------------------------------------------------------------------------------|
// ---------------------------------------------------------------------------------------------------------|


/*! ############################################################################
    @brief
    Used to initialize the PixieChroma library.
    
    @details
    Example usage before `setup()` would be:
    
        #include "Pixie_Chroma.h"
        PixieChroma pix;
    
    Because each of these functions are contained in the PixieChroma class
	object, you'll use them like this:
    
        pix.print( "Hello!" );
*///............................................................................
PixieChroma::PixieChroma(){}

// %%%%%%%%%%%%%%%%%%%%%%%%%%%%%%%%%%%%%%%%%%%%%%%%%%%%%%%%%%%%%%%%%%%%%%%%%%%%%%%%%%%%%%%%%%%%%%%%%%%%%%%%%%
// %% FUNCTIONS - SETUP %%%%%%%%%%%%%%%%%%%%%%%%%%%%%%%%%%%%%%%%%%%%%%%%%%%%%%%%%%%%%%%%%%%%%%%%%%%%%%%%%%%%%
// %%%%%%%%%%%%%%%%%%%%%%%%%%%%%%%%%%%%%%%%%%%%%%%%%%%%%%%%%%%%%%%%%%%%%%%%%%%%%%%%%%%%%%%%%%%%%%%%%%%%%%%%%%

/*! ############################################################################
    @brief
    Initializes the display buffer, populates the XY coordinate table, defaults
    the display colors to green, loads the default CRGBPalette, initializes
    FastLED, and sets the default power budget.
             
    @details
    Pixie Chroma allows for multi-row displays, which are wired in western
    reading order (left to right, top to bottom) and their shape is defined
    here. For example, a 16-Pixie display with two rows of eight:
              
        data_pin
           |
        +--+-+   +----+   +----+   +----+   +----+   +----+   +----+   +----+
        |  1 |-->|  2 |-->|  3 |-->|  4 |-->|  5 |-->|  6 |-->|  7 |-->|  8 | 
        +----+   +----+   +----+   +----+   +----+   +----+   +----+   +--+-+
                                                                          |
           +--------------------------------------------------------------+
           |
        +--+-+   +----+   +----+   +----+   +----+   +----+   +----+   +----+
        |  9 |-->| 10 |-->| 11 |-->| 12 |-->| 13 |-->| 14 |-->| 15 |-->| 16 | 
        +----+   +----+   +----+   +----+   +----+   +----+   +----+   +----+

    The corresponding setup for this display layout would be:
    
        #include "Pixie_Chroma.h"
        PixieChroma pix;
        
        #define DATA_PIN 5
        #define PIXIES_X 8
        #define PIXIES_Y 2
        
        void setup() {
            pix.begin( DATA_PIN, PIXIES_X, PIXIES_Y );
        }
    
    For faster performance on large displays, see begin_quad().
    
    @param  data_pin GPIO pin to use for FastLED output
    @param  pixies_x Number of Pixie PCBs in the X axis of your display
    @param  pixies_y Number of Pixie PCBs in the Y axis of your display
*///............................................................................
void PixieChroma::begin( const uint8_t data_pin, uint8_t pixies_x, uint8_t pixies_y ){
    pixie_pin = data_pin;

    chars_x = (pixies_x+1) * 2; // Pixies have two chars each, plus deadzone for scrolling
    chars_y = pixies_y;

    matrix_width  = display_width  * chars_x;
    matrix_height = display_height * chars_y;

    pixel_count = matrix_width * matrix_height;

    color_map = new CRGB[ pixel_count + 1 ]; // Hidden extra LED to write to if we call an out-of-bounds XY coordinate for color or mask
    mask      = new uint8_t[ pixel_count + 1 ];
    xy_table  = new int16_t[ pixel_count ];

    calc_xy(); // led_count is calculated here

    color_map_out = new CRGB[ led_count ];
    mask_out = new uint8_t[ led_count ];

    for( uint16_t i = 0; i < pixel_count; i++ ){
        color_map[i] = CRGB( 0, 255, 0 );
    }

    current_palette.loadDynamicGradientPalette( GREEN_SOLID );

    build_controller( pixie_pin ); // ----- Initialize FastLED
    set_color_animation( ANIMATION_NULL ); // --- Set animation function to an empty one
    clear(); // --------------------------- Clear anything in mask (should be empty anyways), reset cursor
    set_max_power( 5.0, 500 ); // --------- Set default power budget in volts and milliamps (5.0V, 500mA)
}

/*! ############################################################################
    @brief
    Initializes the display buffer, populates the XY coordinate table, defaults
    the display colors to green, loads the default CRGBPalette, initializes
    FastLED **for Quad Mode**, and sets the default power budget.
    
    @details
    This version of begin() is special, in that it will send your image data to
    the LEDs in 4 parallel streams to increase speed.
    
    Unfortunately, this currently requires hard-coded pins to function *due to
    FastLED limitations*:
    
    **ESP32 / ESP8266:**
	
    - DATA_OUT_1:  **GPIO 12 / D6**
    - DATA_OUT_2:  **GPIO 13 / D7**
    - DATA_OUT_3:  **GPIO 14 / D5**
    - DATA_OUT_4:  **GPIO 15 / D8**
    
    **TEENSY 3.X:**
    
    - DATA_OUT_1:  **GPIO 2**
    - DATA_OUT_2:  **GPIO 14**
    - DATA_OUT_3:  **GPIO 7**
    - DATA_OUT_4:  **GPIO 8**
    
    **(If your microcontroller is not listed here, it does not (yet) support Quad Mode.)**
    
    On each data line, you'll wire `pixies_per_pin` number of Pixie
    Chromas, with the final image being seamlessly spread across these
    four lines.
    
    For example, if you have 16 Pixie Chromas (in two rows of eight) and
    have Quad Mode enabled, then each of the 4 data lines will have 4
    Pixie Chromas like so:
    
    - **DATA_OUT_1** GPIO
      - Pixie 1
      - Pixie 2
      - Pixie 3
      - Pixie 4
    - **DATA_OUT_2** GPIO
      - Pixie 5
      - Pixie 6
      - Pixie 7
      - Pixie 8
    - **DATA_OUT_3** GPIO
      - Pixie 9
      - Pixie 10
      - Pixie 11
      - Pixie 12
    - **DATA_OUT_4** GPIO
      - Pixie 13
      - Pixie 14
      - Pixie 15
      - Pixie 16
    
    The corresponding setup for this display layout would be:
    
        #include "Pixie_Chroma.h"
        PixieChroma pix;
        
        #define PIXIES_PER_PIN 4
        #define PIXIES_X       8
        #define PIXIES_Y       2
        
        void setup() {
            pix.begin_quad( PIXIES_PER_PIN, PIXIES_X, PIXIES_Y );
        }
    
    Then, with the displays physically arranged in western reading order
    (left to right, top to bottom) you're ready to begin!
    
        DATA_OUT_1 --+                       DATA_OUT_2 ----+
                     |                                      |
                  +--+-+   +----+   +----+   +----+  ||  +--+-+   +----+   +----+   +----+
                  |  1 |-->|  2 |-->|  3 |-->|  4 |  ||  |  5 |-->|  6 |-->|  7 |-->|  8 | 
                  +----+   +----+   +----+   +----+  ||  +----+   +----+   +----+   +----+ 
    
        DATA_OUT_3 --+                       DATA_OUT_4 ----+
                     |                                      |
                  +--+-+   +----+   +----+   +----+  ||  +--+-+   +----+   +----+   +----+
                  |  9 |-->| 10 |-->| 11 |-->| 12 |  ||  | 13 |-->| 14 |-->| 15 |-->| 16 | 
                  +----+   +----+   +----+   +----+  ||  +----+   +----+   +----+   +----+ 
    
    Using begin_quad() to enable the Quad Mode driver will
    always send the 4 lines of data in parallel, saving on time per frame.
    
    begin_quad() ideally **should not be used with less than 4 Pixie Chromas**,
    and with at least one on each line. Even if only two pins are physically
    used, all 4 pins are still occupied by Quad Mode.
    
    @param  pixies_per_pin  Pixies per data pin
    @param  pixies_x        Number of Pixie PCBs in the X axis of your display
    @param  pixies_y        Number of Pixie PCBs in the Y axis of your display
*///............................................................................
void PixieChroma::begin_quad( uint8_t pixies_per_pin, uint8_t pixies_x, uint8_t pixies_y ){
    chars_x = (pixies_x+1) * 2; // Pixies have two chars each, plus deadzone for scrolling
    chars_y = pixies_y;

    matrix_width  = display_width  * chars_x;
    matrix_height = display_height * chars_y;

    pixel_count = matrix_width * matrix_height;

    color_map = new CRGB[ pixel_count + 1 ]; // Hidden extra LED to write to if we call an out-of-bounds XY coordinate for color or mask
    mask      = new uint8_t[ pixel_count + 1 ];
    xy_table  = new int16_t[ pixel_count ];

    calc_xy();

    color_map_out = new CRGB[ led_count ];
    mask_out = new uint8_t[ led_count ];
    
    for( uint16_t i = 0; i < led_count; i++ ){
        color_map[i] = CRGB( 0,255,0 );
    }

    current_palette.loadDynamicGradientPalette( GREEN_SOLID );

    #if defined( ARDUINO_ARCH_ESP8266 )
		// WS2811_PORTA on ESP8266 takes up GPIO 12, GPIO 13, GPIO 14 and GPIO 15 for Quad Mode
		FastLED.addLeds<WS2811_PORTA,4>( color_map_out, pixies_per_pin * leds_per_pixie ).setCorrection( TypicalLEDStrip ); // Initialize FastLED
    
	#elif defined( ARDUINO_ARCH_ESP32 )
		// Quad Mode on ESP32 takes up GPIO 12, GPIO 13, GPIO 14 and GPIO 27
		FastLED.addLeds<NEOPIXEL, 13>( // Initialize FastLED Data Out 1
			color_map_out,
			( pixies_per_pin*leds_per_pixie ) * 0,
			( pixies_per_pin*leds_per_pixie )
		).setCorrection( TypicalLEDStrip ); 
		
		FastLED.addLeds<NEOPIXEL, 12>( // Initialize FastLED Data Out 2
			color_map_out,
			( pixies_per_pin*leds_per_pixie ) * 1,
			( pixies_per_pin*leds_per_pixie )
		).setCorrection( TypicalLEDStrip );
		
		FastLED.addLeds<NEOPIXEL, 14>( // Initialize FastLED Data Out 3
			color_map_out,
			( pixies_per_pin*leds_per_pixie ) * 2,
			( pixies_per_pin*leds_per_pixie )
		).setCorrection( TypicalLEDStrip );
		
		FastLED.addLeds<NEOPIXEL, 27>( // Initialize FastLED Data Out 4
			color_map_out,
			( pixies_per_pin*leds_per_pixie ) * 3,
			( pixies_per_pin*leds_per_pixie )
		).setCorrection( TypicalLEDStrip );
		
    #elif defined( ARDUINO_ARCH_TEENSY_3_X )
		// WS2811_PORTD on TEENSY 3.X takes up GPIO 2, GPIO 14, GPIO 7 and GPIO 8 for Quad Mode
		FastLED.addLeds<WS2811_PORTD,4>( color_map_out, pixies_per_pin * leds_per_pixie ).setCorrection( TypicalLEDStrip ); // Initialize FastLED
    #endif
    
    set_color_animation( ANIMATION_NULL ); // --- Set animation function to an empty one
    clear(); // --------------------------- Clear anything in mask ( should be empty anyways ), reset cursor
    set_max_power( 5, 500 ); // ----------- Set default power budget in volts and milliamps
}


/*! ############################################################################
    @brief
    Accepts a preset Color Animation or custom function to use for the animation ISR.
    
    @details
    For a list of predefined Color Animations, see pixie_animations.h.
    
    @param  action  Function to set as an animation ISR
*///............................................................................
void PixieChroma::set_color_animation( void ( *action )(PixieChroma*, float) ) {
    anim_func = action;
	if(anim_func == ANIMATION_NULL){
		custom_animation = false;
	}
	else{
		custom_animation = true;
	}
	clear();
	show();
}


/*! ############################################################################
    @brief
    Used to scale the animation speed of animation ISRs that can use
    pix.animation_speed() to scale their speeds or for other effects
                
    @param  speed  Floating point value: 1.0 = 100%, 3.2 = 320%, 0.5 = 50%
*///............................................................................
void PixieChroma::set_color_animation_speed( float speed ){
    animation_speed = speed;
}


/*! ############################################################################
    @brief
    Takes an 8-bit brightness value and passes it to FastLED internally, to
    provide global brightness control with temporal dithering.
    
    @param  level  8-bit global brightness value ( 0-255 )
*///............................................................................
void PixieChroma::set_brightness( uint8_t level ){
    brightness_level = level;
}


/*! ############################################################################
    @brief
    Sets the target frame rate for animation. This target frame rate is only
    used to calculate `delta` in custom/preset animation functions.
            
    @details
    This does not change your real frame rate, or even govern it: it is left up
    to the user to use frequent show() calls or set_update_mode(AUTOMATIC). The
    "target frame rate" here is used to calculate `delta` for the animation
    functions, and should be set as close as possible to the rate at which you
    are expecting to call show().

    This function is automatically called with a matching FPS when you use
    `set_update_mode( AUTOMATIC, FPS )`.

    @param  target  Target frame rate for animation.
*///............................................................................
void PixieChroma::set_frame_rate_target( uint16_t target ){
    fps_target = target;
}


/*! ############################################################################
    @brief
    Allows you to enable built-in automatic gamma correction, using a fast LUT
    in pixie_utility.h. (Not enabled by default)

    @param  enabled  Whether or not to apply gamma correction
*///............................................................................
void PixieChroma::set_gamma_correction( bool enabled ){
    correct_gamma = enabled;
}


/*! ############################################################################
    @brief
    Sets the text justification globally, or by row

    @param  justification  Can be LEFT, CENTER, or RIGHT
	@param  row            Specifies the row to justify, or global justification
	                       if not specified.
*///............................................................................
void PixieChroma::set_justification( t_justification justification, int16_t row ){
	if(row == -1){
		for(uint8_t i = 0; i < chars_y; i++){
			justifications[i] = justification;
		}
	}
	else{
		justifications[row] = justification;
	}
}


/*! ############################################################################
    @brief
    Sets the line wrapping behavior

    @details
    `set_line_wrap( true );` will automatically enter next line when the edge of
    the display is reached, and `set_line_wrap( false );` will not.

    @param  enabled  Enable or disable auto line-wrapping
*///............................................................................
void PixieChroma::set_line_wrap( bool enabled ){
    line_wrap = enabled;
}


/*! ############################################################################
    @brief
    Sets the maximum power budget in volts and milliamps.
    
    @details
    Knowing the average power consumption of these LEDs at any given color,
    FastLED will automatically globally scale down the output values with
    temporal dithering to lower power usage until it is within the budget
    defined here. Defaults to 5.0V / 500mA to protect PC USB ports if the
    Pixies are not independently powered. ( 2000mA = 2A, 500mA = 0.5A, etc. )

    @param  volts      Total LED power budget in volts. ( default: 5.0 )
    @param  milliamps  Total LED power budget in milliamps ( default 500 )
*///............................................................................
void PixieChroma::set_max_power( float volts, uint16_t milliamps ){
    max_V = volts;
    max_mA = milliamps;
}


/*! ############################################################################
    @brief
    Accepts a const uint8_t (8-bit) array to generate a FastLED Gradient
    Palette at runtime:
    
        const uint8_t* my_gradient_palette[] = {
        //  [INDEX],  [R_VAL],  [G_VAL],  [B_VAL],
        
            0,        255,      0,        0, 
            127,      0,        255,      0, 
            255,      0,        0,        255, 
        };
    
    On each line is the index of the color ( 0-255 ) to express the position in
    the gradient this color occurs. So in the given example, it is a gradient
    from red at 0, to green at 127, to blue at 255.
    
    @param  pal  FastLED "Gradient Palette" array
*///............................................................................
void PixieChroma::set_palette( const uint8_t* pal ){ 
	if(custom_animation == false){
		set_color_animation(ANIMATION_STATIC);
	}
    current_palette.loadDynamicGradientPalette( pal ); // GRADIENT PALETTE
	clear();
	show();
}


/*! ############################################################################
    @brief
    Accepts a FastLED CRGBPalette16 object to set the current color palette for
    animation.
    
    @param  pal  FastLED CRGBPalette16 object to use
*///............................................................................
void PixieChroma::set_palette( CRGBPalette16 pal ){ // STANDARD PALETTE
	if(custom_animation == false){
		set_color_animation(ANIMATION_STATIC);
	}
    current_palette = pal;
	clear();
	show();
}


/*! ############################################################################
    @brief
	Sets the scroll behavior:
	
	- INSTANT (No smooth animation, shift whole characters at a time)
	- SMOOTH (Smooth pixel scrolling)
	- SHIFT (Smooth pixel scrolling with stops at each whole display)

    @param  scroll_type  Can be INSTANT, SMOOTH, or SHIFT
*///............................................................................
void PixieChroma::set_scroll_type(t_scroll_type type){
	scroll_type = type;
	
	if(scroll_type == INSTANT){
		scroll_frame_delay_ms = 0;
		scroll_hold_ms        = 150;
	}
	else if(scroll_type == SHIFT){
		scroll_frame_delay_ms = 10;
		scroll_hold_ms        = 80;
	}
	else if(scroll_type == SMOOTH){
		scroll_frame_delay_ms = 10;
		scroll_hold_ms        = 0;
	}
}


/*! ############################################################################
    @brief
    Allows for automatic show() calls at a specified frames per second if
    AUTOMATIC is used. (uses Ticker.attach_ms() internally)
            
    @details
    This lets you use things like print() as infrequently as you'd like, since
    show() will automatically run in the background to keep the current
    animation function running smoothly.
            
    Use in conjunction with hold() and free() to prevent show() calls during
    text/image construction, leading to unintended partial frames being shown.
    Be aware, hold() does not prevent animation / palette updates (only mask
    updates) so animations will still run smoothly during hold() times until
    free() is called and the mask is finally updated.
    
    @param  mode  AUTOMATIC or MANUAL. AUTOMATIC will call show() at `FPS`
                  using an ISR, MANUAL allows you call show() when you like.

    @param  FPS   Update *this* many times per second (Default: 60) Only
                  applicable when mode is AUTOMATIC
*///............................................................................
void PixieChroma::set_update_mode( t_update_mode mode, uint16_t FPS ){
    if( mode == AUTOMATIC && ticker_running == false ){
        set_frame_rate_target( FPS );
		
		#if defined( ARDUINO_ARCH_ESP8266 ) || defined( ARDUINO_ARCH_ESP32 )
			animate.attach_ms<typeof this>(
				round(1000 / float(FPS)),
				[](typeof this _p){ _p->show(); },
			   // This. ^ This is the magic sauce
			   // right here. This is apparently how
			   // you add a non-static class member to
			   // Ticker from within a class and I
			   // hate it. Readability sucks, oh well.
			   // At least I got a Lambdaghini.
				this
			);
		#elif defined( ARDUINO_ARCH_TEENSY_3_X )
			animate.begin(
				[](typeof this _p){ _p->show(); },
				round(1000000 / float(FPS))
			);
			animate.priority(1);
		#endif
		
        ticker_running = true;
    }
    else if( mode == MANUAL && ticker_running == true ){
		#if defined( ARDUINO_ARCH_ESP8266 ) || defined( ARDUINO_ARCH_ESP32 )
			animate.detach();
		#elif defined( ARDUINO_ARCH_TEENSY_3_X )
			animate.end();
		#endif
        ticker_running = false;
    }
}


// %%%%%%%%%%%%%%%%%%%%%%%%%%%%%%%%%%%%%%%%%%%%%%%%%%%%%%%%%%%%%%%%%%%%%%%%%%%%%%%%%%%%%%%%%%%%%%%%%%%%%%%%%%
// %% FUNCTIONS - WRITE %%%%%%%%%%%%%%%%%%%%%%%%%%%%%%%%%%%%%%%%%%%%%%%%%%%%%%%%%%%%%%%%%%%%%%%%%%%%%%%%%%%%%
// %%%%%%%%%%%%%%%%%%%%%%%%%%%%%%%%%%%%%%%%%%%%%%%%%%%%%%%%%%%%%%%%%%%%%%%%%%%%%%%%%%%%%%%%%%%%%%%%%%%%%%%%%%

/*! ############################################################################
    @brief
    Internal function for rendering a single char to the mask buffer.
    
    @details
    All other write() function overloads eventually end up casted to char*
    strings and passed to this function one character at a time for rendering.
    
    @param  chr     char to render
    @param  x_dest  X pixel position of write
    @param  y_dest  Y pixel position of write
*///............................................................................
void PixieChroma::add_char( char chr, int16_t x_dest, int16_t y_dest ){
	color(print_col, x_dest/display_width, y_dest/display_height);
	
    if ( chr >= printable_ascii_offset ) {
        chr -= printable_ascii_offset;
    }

    for( uint8_t x = 0; x < font_col_width; x++ ){
        uint8_t column = pgm_read_byte( font + ( chr * font_col_width + x ) );

        uint16_t row1_index = xy( x_dest+x, y_dest+0 );
        uint16_t row2_index = xy( x_dest+x, y_dest+1 );
        uint16_t row3_index = xy( x_dest+x, y_dest+2 );
        uint16_t row4_index = xy( x_dest+x, y_dest+3 );
        uint16_t row5_index = xy( x_dest+x, y_dest+4 );
        uint16_t row6_index = xy( x_dest+x, y_dest+5 );
        uint16_t row7_index = xy( x_dest+x, y_dest+6 );

        // "Subtract" from mask transparency with saturating function
        mask[row1_index] = qadd8( mask[row1_index], bit_table[bitRead( column, 0 )] );
        mask[row2_index] = qadd8( mask[row2_index], bit_table[bitRead( column, 1 )] );
        mask[row3_index] = qadd8( mask[row3_index], bit_table[bitRead( column, 2 )] );
        mask[row4_index] = qadd8( mask[row4_index], bit_table[bitRead( column, 3 )] );
        mask[row5_index] = qadd8( mask[row5_index], bit_table[bitRead( column, 4 )] );
        mask[row6_index] = qadd8( mask[row6_index], bit_table[bitRead( column, 5 )] );
        mask[row7_index] = qadd8( mask[row7_index], bit_table[bitRead( column, 6 )] );
    }
}


/*! ############################################################################
    @brief
    Internal function for rendering a single bitmap to the mask buffer.
    
    @param  bitmap_col_1  Column 1 data of this bitmap
    @param  bitmap_col_2  Column 2 data of this bitmap
    @param  bitmap_col_3  Column 3 data of this bitmap
    @param  bitmap_col_4  Column 4 data of this bitmap
    @param  bitmap_col_5  Column 5 data of this bitmap
    @param  x_dest        X pixel position of write
    @param  y_dest        Y pixel position of write
*///............................................................................
void PixieChroma::add_char( uint8_t bitmap_col_1, uint8_t bitmap_col_2, uint8_t bitmap_col_3, uint8_t bitmap_col_4, uint8_t bitmap_col_5, int16_t x_dest, int16_t y_dest ){	
    uint16_t row1_index;
	uint16_t row2_index;
	uint16_t row3_index;
	uint16_t row4_index;
	uint16_t row5_index;
	uint16_t row6_index;
	uint16_t row7_index;
	
	// COLUMN 1 --------------------------------------------------------------------------------------------------------------
	row1_index = xy( x_dest+0, y_dest+0 ); mask[row1_index] = qadd8( mask[row1_index], bit_table[bitRead( bitmap_col_1,0 )] );
	row2_index = xy( x_dest+0, y_dest+1 ); mask[row2_index] = qadd8( mask[row2_index], bit_table[bitRead( bitmap_col_1,1 )] );
	row3_index = xy( x_dest+0, y_dest+2 ); mask[row3_index] = qadd8( mask[row3_index], bit_table[bitRead( bitmap_col_1,2 )] );
	row4_index = xy( x_dest+0, y_dest+3 ); mask[row4_index] = qadd8( mask[row4_index], bit_table[bitRead( bitmap_col_1,3 )] );
	row5_index = xy( x_dest+0, y_dest+4 ); mask[row5_index] = qadd8( mask[row5_index], bit_table[bitRead( bitmap_col_1,4 )] );
	row6_index = xy( x_dest+0, y_dest+5 ); mask[row6_index] = qadd8( mask[row6_index], bit_table[bitRead( bitmap_col_1,5 )] );
	row7_index = xy( x_dest+0, y_dest+6 ); mask[row7_index] = qadd8( mask[row7_index], bit_table[bitRead( bitmap_col_1,6 )] );
	
	// COLUMN 2 --------------------------------------------------------------------------------------------------------------
	row1_index = xy( x_dest+1, y_dest+0 ); mask[row1_index] = qadd8( mask[row1_index], bit_table[bitRead( bitmap_col_2,0 )] );
	row2_index = xy( x_dest+1, y_dest+1 ); mask[row2_index] = qadd8( mask[row2_index], bit_table[bitRead( bitmap_col_2,1 )] );
	row3_index = xy( x_dest+1, y_dest+2 ); mask[row3_index] = qadd8( mask[row3_index], bit_table[bitRead( bitmap_col_2,2 )] );
	row4_index = xy( x_dest+1, y_dest+3 ); mask[row4_index] = qadd8( mask[row4_index], bit_table[bitRead( bitmap_col_2,3 )] );
	row5_index = xy( x_dest+1, y_dest+4 ); mask[row5_index] = qadd8( mask[row5_index], bit_table[bitRead( bitmap_col_2,4 )] );
	row6_index = xy( x_dest+1, y_dest+5 ); mask[row6_index] = qadd8( mask[row6_index], bit_table[bitRead( bitmap_col_2,5 )] );
	row7_index = xy( x_dest+1, y_dest+6 ); mask[row7_index] = qadd8( mask[row7_index], bit_table[bitRead( bitmap_col_2,6 )] );
	
	// COLUMN 3 --------------------------------------------------------------------------------------------------------------
	row1_index = xy( x_dest+2, y_dest+0 ); mask[row1_index] = qadd8( mask[row1_index], bit_table[bitRead( bitmap_col_3,0 )] );
	row2_index = xy( x_dest+2, y_dest+1 ); mask[row2_index] = qadd8( mask[row2_index], bit_table[bitRead( bitmap_col_3,1 )] );
	row3_index = xy( x_dest+2, y_dest+2 ); mask[row3_index] = qadd8( mask[row3_index], bit_table[bitRead( bitmap_col_3,2 )] );
	row4_index = xy( x_dest+2, y_dest+3 ); mask[row4_index] = qadd8( mask[row4_index], bit_table[bitRead( bitmap_col_3,3 )] );
	row5_index = xy( x_dest+2, y_dest+4 ); mask[row5_index] = qadd8( mask[row5_index], bit_table[bitRead( bitmap_col_3,4 )] );
	row6_index = xy( x_dest+2, y_dest+5 ); mask[row6_index] = qadd8( mask[row6_index], bit_table[bitRead( bitmap_col_3,5 )] );
	row7_index = xy( x_dest+2, y_dest+6 ); mask[row7_index] = qadd8( mask[row7_index], bit_table[bitRead( bitmap_col_3,6 )] );
	
	// COLUMN 4 --------------------------------------------------------------------------------------------------------------
	row1_index = xy( x_dest+3, y_dest+0 ); mask[row1_index] = qadd8( mask[row1_index], bit_table[bitRead( bitmap_col_4,0 )] );
	row2_index = xy( x_dest+3, y_dest+1 ); mask[row2_index] = qadd8( mask[row2_index], bit_table[bitRead( bitmap_col_4,1 )] );
	row3_index = xy( x_dest+3, y_dest+2 ); mask[row3_index] = qadd8( mask[row3_index], bit_table[bitRead( bitmap_col_4,2 )] );
	row4_index = xy( x_dest+3, y_dest+3 ); mask[row4_index] = qadd8( mask[row4_index], bit_table[bitRead( bitmap_col_4,3 )] );
	row5_index = xy( x_dest+3, y_dest+4 ); mask[row5_index] = qadd8( mask[row5_index], bit_table[bitRead( bitmap_col_4,4 )] );
	row6_index = xy( x_dest+3, y_dest+5 ); mask[row6_index] = qadd8( mask[row6_index], bit_table[bitRead( bitmap_col_4,5 )] );
	row7_index = xy( x_dest+3, y_dest+6 ); mask[row7_index] = qadd8( mask[row7_index], bit_table[bitRead( bitmap_col_4,6 )] );
	
	// COLUMN 5 --------------------------------------------------------------------------------------------------------------
	row1_index = xy( x_dest+4, y_dest+0 ); mask[row1_index] = qadd8( mask[row1_index], bit_table[bitRead( bitmap_col_5,0 )] );
	row2_index = xy( x_dest+4, y_dest+1 ); mask[row2_index] = qadd8( mask[row2_index], bit_table[bitRead( bitmap_col_5,1 )] );
	row3_index = xy( x_dest+4, y_dest+2 ); mask[row3_index] = qadd8( mask[row3_index], bit_table[bitRead( bitmap_col_5,2 )] );
	row4_index = xy( x_dest+4, y_dest+3 ); mask[row4_index] = qadd8( mask[row4_index], bit_table[bitRead( bitmap_col_5,3 )] );
	row5_index = xy( x_dest+4, y_dest+4 ); mask[row5_index] = qadd8( mask[row5_index], bit_table[bitRead( bitmap_col_5,4 )] );
	row6_index = xy( x_dest+4, y_dest+5 ); mask[row6_index] = qadd8( mask[row6_index], bit_table[bitRead( bitmap_col_5,5 )] );
	row7_index = xy( x_dest+4, y_dest+6 ); mask[row7_index] = qadd8( mask[row7_index], bit_table[bitRead( bitmap_col_5,6 )] );
}


/*! ############################################################################
    @brief
    Writes a bitmap to a specified X and Y cursor position, taking five uint8_t
    as input for the column data.
    
    @details
    Example:

        pix.write( B00101111, B01001001, B01001001, B01001001, B00110001 );
        
            OR, WRITTEN VERTICALLY:
        
        pix.write(   ,   ,   ,   ,   );
                   1   1   1   1   1  LSB
                   1   0   0   0   0
                   1   0   0   0   0
                   1   1   1   1   0
                   0   0   0   0   1
                   1   0   0   0   1
                   0   1   1   1   0  
                   0   0   0   0   0  MSB (unused)
                   B   B   B   B   B
    
    This writes a "5" to the display, seen above in the "1" bits of each column.
    The MSB (highest bit) is not used in bitmaps.
    
    @param  bitmap_col_1  Column 1 data of this bitmap
    @param  bitmap_col_2  Column 2 data of this bitmap
    @param  bitmap_col_3  Column 3 data of this bitmap
    @param  bitmap_col_4  Column 4 data of this bitmap
    @param  bitmap_col_5  Column 5 data of this bitmap
    @param  x_pos       X cursor position of write **[optional]**
    @param  y_pos       Y cursor position of write **[optional]**
*///............................................................................
void PixieChroma::write( uint8_t bitmap_col_1, uint8_t bitmap_col_2, uint8_t bitmap_col_3, uint8_t bitmap_col_4, uint8_t bitmap_col_5, uint8_t x_pos, uint8_t y_pos ){
    write_pix( bitmap_col_1, bitmap_col_2, bitmap_col_3, bitmap_col_4, bitmap_col_5, x_pos, y_pos );
}


/*! ############################################################################
    @brief
    Writes a char* string to a specified X and Y cursor position.
    
    @param  message  char* string to write
    @param  x_pos    X cursor position of write **[optional]**
    @param  y_pos    Y cursor position of write **[optional]**
*///............................................................................
void PixieChroma::write( char* message, uint8_t x_pos, uint8_t y_pos ){
    write_pix(
        message,
        display_padding_x + ( display_width  * x_pos ),
        display_padding_y + ( display_height * y_pos )
    );
}


/*! ############################################################################
    @brief
    Writes a signed 16-bit integer to a specified X and Y cursor position.
    
    @param  input  Signed integer to write
    @param  x_pos  X cursor position of write **[optional]**
    @param  y_pos  Y cursor position of write **[optional]**
*///............................................................................
void PixieChroma::write( int16_t input, uint8_t x_pos, uint8_t y_pos ){
    char char_buf[32];
    itoa( input, char_buf, 10 );

    write_pix(
        char_buf,
        display_padding_x + ( display_width  * x_pos ),
        display_padding_y + ( display_height * y_pos )
    );
}


/*! ############################################################################
    @brief
    Writes an unsigned 16-bit integer to a specified X and Y cursor position.
    
    @param  input  Unsigned integer to write
    @param  x_pos  X cursor position of write **[optional]**
    @param  y_pos  Y cursor position of write **[optional]**
*///............................................................................
void PixieChroma::write( uint16_t input, uint8_t x_pos, uint8_t y_pos ){
    char char_buf[32];
    utoa( input, char_buf, 10 );

    write_pix(
        char_buf,
        display_padding_x + ( display_width  * x_pos ),
        display_padding_y + ( display_height * y_pos )
    );
}


/*! ############################################################################
    @brief
    Writes a signed 32-bit integer to a specified X and Y cursor position.
    
    @param  input  Signed integer to write
    @param  x_pos  X cursor position of write **[optional]**
    @param  y_pos  Y cursor position of write **[optional]**
*///............................................................................
void PixieChroma::write( int32_t input, uint8_t x_pos, uint8_t y_pos ){
    char char_buf[32];
    ltoa( input, char_buf, 10 );

    write_pix(
        char_buf,
        display_padding_x + ( display_width  * x_pos ),
        display_padding_y + ( display_height * y_pos )
    );
}


/*! ############################################################################
    @brief
    Writes an unsigned 32-bit integer to a specified X and Y cursor position.
    
    @param  input  Unsigned integer to write
    @param  x_pos  X cursor position of write **[optional]**
    @param  y_pos  Y cursor position of write **[optional]**
*///............................................................................
void PixieChroma::write( uint32_t input, uint8_t x_pos, uint8_t y_pos ){
    char char_buf[32];
    ultoa( input, char_buf, 10 );

    write_pix(
        char_buf,
        display_padding_x + ( display_width  * x_pos ),
        display_padding_y + ( display_height * y_pos )
    );
}


/*! ############################################################################
    @brief
    Writes an unsigned 32-bit integer to a specified X and Y cursor position.
    ( Stupid ESP-specific type )
    
    @param  input  Unsigned integer to write
    @param  x_pos  X cursor position of write **[optional]**
    @param  y_pos  Y cursor position of write **[optional]**
*///............................................................................
#ifndef ARDUINO_ARCH_TEENSY_3_X
void PixieChroma::write( long unsigned int input, uint8_t x_pos, uint8_t y_pos ){
    char char_buf[32];
    ultoa( input, char_buf, 10 );

    write_pix(
        char_buf,
        display_padding_x + ( display_width  * x_pos ),
        display_padding_y + ( display_height * y_pos )
    );
}
#endif


/*! ############################################################################
    @brief
    Writes a single-precision floating point value to a specified X and Y cursor
    position, to a specified number of decimal places.
    
    @param  input   Single-precision float to write
    @param  places  Number of decimal places to show **[optional]**
    @param  x_pos   X cursor position of write **[optional]**
    @param  y_pos   Y cursor position of write **[optional]**
*///............................................................................
void PixieChroma::write( float input, uint8_t places, uint8_t x_pos, uint8_t y_pos ){
    write(
        double( input ),
        places,
        x_pos,
        y_pos
    );
}


/*! ############################################################################
    @brief
    Writes a double-precision floating point value to a specified X and Y cursor
    position, to a specified number of decimal places.
    
    @param  input   Double-precision float to write
    @param  places  Number of decimal places to show **[optional]**
    @param  x_pos   X cursor position of write **[optional]**
    @param  y_pos   Y cursor position of write **[optional]**
*///............................................................................
void PixieChroma::write( double input, uint8_t places, uint8_t x_pos, uint8_t y_pos ){
    char char_buf[32];
    dtoa( input, char_buf, places );

    write_pix(
        char_buf,
        display_padding_x + ( display_width  * x_pos ),
        display_padding_y + ( display_height * y_pos )
    );
}


/*! ############################################################################
    @brief
    Internal function for rendering char* strings to the mask buffer.
    
    @details
    All other write() function overloads eventually end up casted to char*
    strings and passed to this function for rendering. This can also be used to
    write char* strings that are not aligned to whole display positions, such
    as during smooth scrolling.
    
    @param  message  char* of text to render
    @param  x_dest   X pixel position of write **[optional]**
    @param  y_dest   Y pixel position of write **[optional]**
*///............................................................................
void PixieChroma::write_pix( char* message, int16_t x_dest, int16_t y_dest ){
	int16_t offset_x = 0;
	int16_t offset_y = 0;
	
	just_wrapped = false;
	
    uint8_t len = strlen( message );
    for( uint8_t i = 0; i < len; i++ ){
        if( message[i] == '\n' ){ // Newline, force line break
			if(just_wrapped == true){
				just_wrapped = false;
				// Skip newline, auto wrapping just newline'd for us.
			}
			else{
				x_dest = extra_space_left+display_padding_x;
				offset_x = 0;
				offset_y = display_height;
			}
        }
        else if( line_wrap == true && x_dest+offset_x+display_width >= (matrix_width) ){ // End of line reached, wrap to new line if line_wrap enabled		
			add_char(
                message[i],
                x_dest + offset_x,
                y_dest + offset_y
            );
            offset_x += display_width;
			
            x_dest = extra_space_left+display_padding_x;
			offset_x = 0;
			offset_y = display_height;
			
			just_wrapped = true;
        }
        else if( message[i] == 0 || message[i] == '\0' ){ // end of string
            return;
        }
        else{ // Normal char
            add_char(
                message[i],
                x_dest + offset_x,
                y_dest + offset_y
            );
            offset_x += display_width;
        }
    }
	
	cursor_x_temp = x_dest+offset_x;
	cursor_y_temp = y_dest+offset_y;
}


/*! ############################################################################
    @brief
    Internal function for rendering bitmaps to the mask buffer.
    
    @details
    This can also be used to write bitmaps that are not aligned to whole display
    positions, such as during smooth scrolling.
    
    @param  bitmap_col_1  Column 1 data of this bitmap
    @param  bitmap_col_2  Column 2 data of this bitmap
    @param  bitmap_col_3  Column 3 data of this bitmap
    @param  bitmap_col_4  Column 4 data of this bitmap
    @param  bitmap_col_5  Column 5 data of this bitmap
    @param  x_dest        X pixel position of write **[optional]**
    @param  y_dest        Y pixel position of write **[optional]**
*///............................................................................
void PixieChroma::write_pix( uint8_t bitmap_col_1, uint8_t bitmap_col_2, uint8_t bitmap_col_3, uint8_t bitmap_col_4, uint8_t bitmap_col_5, int16_t x_dest, int16_t y_dest ){	
    int16_t offset_x = 0;
	int16_t offset_y = 0;
		
	if( line_wrap == true && x_dest+offset_x >= ( display_width * chars_x ) ){ // End of line reached, wrap to new line if line_wrap enabled
		x_dest = display_padding_x;
		offset_x = 0;
		offset_y = display_height;	
	}
	
	add_char(
		bitmap_col_1,
		bitmap_col_2,
		bitmap_col_3,
		bitmap_col_4,
		bitmap_col_5,
		x_dest + offset_x,
		y_dest + offset_y
	);
	offset_x += display_width;

	
	cursor_x_temp = x_dest+offset_x;
	cursor_y_temp = y_dest+offset_y;
}


// %%%%%%%%%%%%%%%%%%%%%%%%%%%%%%%%%%%%%%%%%%%%%%%%%%%%%%%%%%%%%%%%%%%%%%%%%%%%%%%%%%%%%%%%%%%%%%%%%%%%%%%%%%
// %% FUNCTIONS - PRINT %%%%%%%%%%%%%%%%%%%%%%%%%%%%%%%%%%%%%%%%%%%%%%%%%%%%%%%%%%%%%%%%%%%%%%%%%%%%%%%%%%%%%
// %%%%%%%%%%%%%%%%%%%%%%%%%%%%%%%%%%%%%%%%%%%%%%%%%%%%%%%%%%%%%%%%%%%%%%%%%%%%%%%%%%%%%%%%%%%%%%%%%%%%%%%%%%

/*! ############################################################################
    @brief
    Prints a bitmap to the displays at the current cursor position, taking five
    uint8_t as input for the column data.
    
    @details
    Example:

        pix.print( B00101111, B01001001, B01001001, B01001001, B00110001 );
        
            OR, WRITTEN VERTICALLY:
        
        pix.print(    ,   ,   ,   ,    );
                    1   1   1   1   1  LSB
                    1   0   0   0   0
                    1   0   0   0   0
                    1   1   1   1   0
                    0   0   0   0   1
                    1   0   0   0   1
                    0   1   1   1   0  
                    0   0   0   0   0  MSB ( unused )
                    B   B   B   B   B
        
    This writes a "5" to the display, seen above in the "1" bits of
    each column. The MSB ( highest bit ) is not used in bitmaps.
              
    @param  bitmap_col_1  Column 1 data of this bitmap
    @param  bitmap_col_2  Column 2 data of this bitmap
    @param  bitmap_col_3  Column 3 data of this bitmap
    @param  bitmap_col_4  Column 4 data of this bitmap
    @param  bitmap_col_5  Column 5 data of this bitmap
*///............................................................................
void PixieChroma::print( uint8_t bitmap_col_1, uint8_t bitmap_col_2, uint8_t bitmap_col_3, uint8_t bitmap_col_4, uint8_t bitmap_col_5 ){
	cursor_x_temp = cursor_x;
	cursor_y_temp = cursor_y;
	
    write_pix( bitmap_col_1, bitmap_col_2, bitmap_col_3, bitmap_col_4, bitmap_col_5, cursor_x, cursor_y );
	
	// Store cursor changes
	cursor_x = cursor_x_temp;
	cursor_y = cursor_y_temp;
}


/*! ############################################################################
    @brief
    Prints a single char to the displays at the current cursor position.
    
    @param  chr  char to print
*///............................................................................
void PixieChroma::print( char chr ){
	if(chr != '\n'){
		add_char(
			chr,
			cursor_x,
			cursor_y
		);
		
		cursor_x += display_width;

		if(line_wrap && cursor_x >= ( display_width * chars_x )	){
			cursor_x = extra_space_left+display_padding_x;
			cursor_y += display_height;
			just_wrapped = true;
		}
	}
	else{
		if(just_wrapped == false){
			cursor_x = extra_space_left+display_padding_x;
			cursor_y += display_height;
		}
		else{
			just_wrapped = false;
		}
	}
}


/*! ############################################################################
    @brief
    Prints a char* string to the displays at the current cursor position.
    
    The given string will be searched for "Shortcodes", which are special
    strings which will automatically be replaced with bitmap icons such as:
    
    `print("SMILEY FACE! [:SMILE:]");`
    
    A full list of Shortcodes can be found in pixie_shortcodes.h.
    
    @param  message  char* string to print
*///............................................................................
void PixieChroma::print( char* message ){
	uint16_t len = strlen(message);
	uint16_t i = 0;
	while (i < len - 1) {
		if (message[i] == '[' && message[i + 1] == ':') { // Found start of shortcode
			for (uint16_t j = i; j < len - 1; j++) {
				if (message[j] == ':' && message[j + 1] == ']') { // Found end of shortcode
					fetch_shortcode( message, i + 2, j );
					i = j + 2;
					break;
				}
			}
		}
		else {
			print(message[i]);
			i += 1;
		}
	}

	if(message[len-1] != ']'){ // If message doesn't end with shortcode
		print( message[len-1] );
	}
}


/*! ############################################################################
    @brief
    Prints a signed 16-bit integer to the displays at the current cursor 
    position.
    
    @param  input  Signed integer to print
*///............................................................................
void PixieChroma::print( int16_t input ){
    char char_buf[32];
    itoa( input, char_buf, 10 );
    write_pix( char_buf, cursor_x, cursor_y );
	
	// Store cursor changes
	cursor_x = cursor_x_temp;
	cursor_y = cursor_y_temp;
}


/*! ############################################################################
    @brief
    Prints an unsigned 16-bit integer to the displays at the current cursor
    position.
    
    @param  input  Unsigned integer to print
*///............................................................................
void PixieChroma::print( uint16_t input ){
    char char_buf[32];
    utoa( input, char_buf, 10 );
    write_pix( char_buf, cursor_x, cursor_y );
	
	// Store cursor changes
	cursor_x = cursor_x_temp;
	cursor_y = cursor_y_temp;
}


/*! ############################################################################
    @brief
    Prints a signed 32-bit integer to the displays at the current cursor
    position.
    
    @param  input  Signed integer to print
*///............................................................................
void PixieChroma::print( int32_t input ){
    char char_buf[32];
    ltoa( input, char_buf, 10 );
    write_pix( char_buf, cursor_x, cursor_y );
	
	// Store cursor changes
	cursor_x = cursor_x_temp;
	cursor_y = cursor_y_temp;
}


/*! ############################################################################
    @brief
    Prints an unsigned 32-bit integer to the displays at the current cursor\
    position.
    
    @param  input  Unsigned integer to print
*///............................................................................
void PixieChroma::print( uint32_t input ){
    char char_buf[32];
    ultoa( input, char_buf, 10 );
    write_pix( char_buf, cursor_x, cursor_y );
	
	// Store cursor changes
	cursor_x = cursor_x_temp;
	cursor_y = cursor_y_temp;
}


/*! ############################################################################
    @brief
    Prints an unsigned 32-bit integer to the displays at the current cursor
    position. ( Dumb ESP-specific type )
    
    @param  input  Unsigned integer to print
*///............................................................................
#ifndef ARDUINO_ARCH_TEENSY_3_X
void PixieChroma::print( long unsigned int input ){
    char char_buf[32];
    ultoa( input, char_buf, 10 );
    write_pix( char_buf, cursor_x, cursor_y );
	
	// Store cursor changes
	cursor_x = cursor_x_temp;
	cursor_y = cursor_y_temp;
}
#endif


/*! ############################################################################
    @brief
    Prints a single-precision floating point value to the displays at the
    current cursor position, to a specified number of decimal places.
    
    @param  input   float to print
    @param  places  Number of decimal places to print **[optional]**
*///............................................................................
void PixieChroma::print( float input, uint8_t places ){
    print( double( input ), places );
	
	// Store cursor changes
	cursor_x = cursor_x_temp;
	cursor_y = cursor_y_temp;
}


/*! ############################################################################
    @brief
    Prints a double-precision floating point value to the displays at the
    current cursor position, to a specified number of decimal places.
    
    @param  input   double to print
    @param  places  Number of decimal places to print **[optional]**
*///............................................................................
void PixieChroma::print( double input, uint8_t places ){
    char char_buf[32];
    dtoa( input, char_buf, places );
    write_pix( char_buf, cursor_x, cursor_y );
	
	// Store cursor changes
	cursor_x = cursor_x_temp;
	cursor_y = cursor_y_temp;
}


// %%%%%%%%%%%%%%%%%%%%%%%%%%%%%%%%%%%%%%%%%%%%%%%%%%%%%%%%%%%%%%%%%%%%%%%%%%%%%%%%%%%%%%%%%%%%%%%%%%%%%%%%%%
// %% FUNCTIONS - PRINTLN %%%%%%%%%%%%%%%%%%%%%%%%%%%%%%%%%%%%%%%%%%%%%%%%%%%%%%%%%%%%%%%%%%%%%%%%%%%%%%%%%%%
// %%%%%%%%%%%%%%%%%%%%%%%%%%%%%%%%%%%%%%%%%%%%%%%%%%%%%%%%%%%%%%%%%%%%%%%%%%%%%%%%%%%%%%%%%%%%%%%%%%%%%%%%%%

/*! ############################################################################
    @brief
    Prints a bitmap to the displays at the current cursor position, (taking five
    uint8_t as input for the column data) then jumps to the next row in the
    Pixie display, similar to a newline '\\n' character.
    
    @param  bitmap_col_1  Column 1 data of this bitmap
    @param  bitmap_col_2  Column 2 data of this bitmap
    @param  bitmap_col_3  Column 3 data of this bitmap
    @param  bitmap_col_4  Column 4 data of this bitmap
    @param  bitmap_col_5  Column 5 data of this bitmap
*///............................................................................
void PixieChroma::println( uint8_t bitmap_col_1, uint8_t bitmap_col_2, uint8_t bitmap_col_3, uint8_t bitmap_col_4, uint8_t bitmap_col_5 ){	
	print( bitmap_col_1, bitmap_col_2, bitmap_col_3, bitmap_col_4, bitmap_col_5 );
	print('\n');
}


/*! ############################################################################
    @brief
    Prints a char* string to the displays at the current cursor position, then
    jumps to the next row in the Pixie display, similar to a newline '\\n'
    character.
    
    The given string will be searched for "Shortcodes", which are special
    strings which will automatically be replaced with bitmap icons such as:
    
    `print("SMILEY FACE! [:SMILE:]");`
    
    A full list of Shortcodes can be found in pixie_shortcodes.h.
    
    @param  message  char* string to print
*///............................................................................
void PixieChroma::println( char* message ){
	print(message);	
	print('\n');
}


/*! ############################################################################
    @brief
    Prints a signed 16-bit integer to the displays at the current cursor
    position, then jumps to the next row in the Pixie display, similar to a
    newline '\\n' character.
    
    @param  input  Signed 16-bit integer to print
*///............................................................................
void PixieChroma::println( int16_t input ){
    print( input );
	print('\n');
}


/*! ############################################################################
    @brief
    Prints an unsigned 16-bit integer to the displays at the current cursor
    position, then jumps to the next row in the Pixie display, similar to a
    newline '\\n' character.
    
    @param  input  Unsigned 16-bit integer to print
*///............................................................................
void PixieChroma::println( uint16_t input ){
    print( input );
	print('\n');
}


/*! ############################################################################
    @brief
    Prints a signed 32-bit integer to the displays at the current cursor
    position, then jumps to the next row in the Pixie display, similar to a
    newline '\\n' character.
    
    @param  input  Signed 32-bit integer to print
*///............................................................................
void PixieChroma::println( int32_t input ){
    print( input );
	print('\n');
}


/*! ############################################################################
    @brief
    Prints an unsigned 32-bit integer to the displays at the current cursor
    position, then jumps to the next row in the Pixie display, similar to a
    newline '\\n' character.
    
    @param  input  Unsigned 32-bit integer to print
*///............................................................................
void PixieChroma::println( uint32_t input ){
    print( input );
	print('\n');
}


/*! ############################################################################
    @brief
    Prints an unsigned 32-bit integer to the displays at the current cursor
    position, then jumps to the next row in the Pixie display, similar to a
    newline '\\n' character. ( Stupid ESP-specific type )
    
    @param  input  Unsigned 32-bit integer to print
*///............................................................................
#ifndef ARDUINO_ARCH_TEENSY_3_X
void PixieChroma::println( long unsigned int input ){
    print( input );
	print('\n');
}
#endif


/*! ############################################################################
    @brief
    Prints a single-precision floating point value to the displays at the
    current cursor position (to a specified number of decimal places), then
    jumps to the next row in the Pixie display, similar to a newline '\\n'
    character.

    @param  input   float to print
    @param  places  Number of decimal places to print **[optional]**
*///............................................................................
void PixieChroma::println( float input, uint8_t places ){
    println( double(input), places );
}


/*! ############################################################################
    @brief
    Prints a double-precision floating point value to the displays at the
    current cursor position (to a specified number of decimal places), then
    jumps to the next row in the Pixie display, similar to a newline '\\n'
    character.
            
    @param  input   double to print
    @param  places  Number of decimal places to print **[optional]**
*///............................................................................
void PixieChroma::println( double input, uint8_t places ){
    print( input, places );
	print('\n');
}


// %%%%%%%%%%%%%%%%%%%%%%%%%%%%%%%%%%%%%%%%%%%%%%%%%%%%%%%%%%%%%%%%%%%%%%%%%%%%%%%%%%%%%%%%%%%%%%%%%%%%%%%%%%
// %% FUNCTIONS - CURSOR %%%%%%%%%%%%%%%%%%%%%%%%%%%%%%%%%%%%%%%%%%%%%%%%%%%%%%%%%%%%%%%%%%%%%%%%%%%%%%%%%%%%
// %%%%%%%%%%%%%%%%%%%%%%%%%%%%%%%%%%%%%%%%%%%%%%%%%%%%%%%%%%%%%%%%%%%%%%%%%%%%%%%%%%%%%%%%%%%%%%%%%%%%%%%%%%

/*! ############################################################################
    @brief
    Returns the cursor's X position
    
    @return  The cursor's X position
*///............................................................................
uint8_t PixieChroma::get_cursor_x(){	
    return cursor_x / display_width;
}


/*! ############################################################################
    @brief
    Returns the cursor's X position in exact pixel coordinates
    
    @return  The cursor's X position in exact pixel coordinates
*///............................................................................
int16_t PixieChroma::get_cursor_x_exact(){
    return cursor_x;
}


/*! ############################################################################
    @brief
    Returns the cursor's Y position
    
    @return  The cursor's Y position
*///............................................................................
uint8_t PixieChroma::get_cursor_y(){
    return cursor_y / display_height;
}


/*! ############################################################################
    @brief
    Returns the cursor's Y position in exact pixel coordinates
    
    @return  The cursor's Y position in exact pixel coordinates
*///............................................................................
int16_t PixieChroma::get_cursor_y_exact(){
    return cursor_y;
}


/*! ############################################################################
    @brief
    Sets the cursor position in a 2D context, in whole displays.
    
    @details  
    Wherever the cursor is, is where the next call to print() or write() will
    originate. Position is counted from zero. Remember: each Pixie Chroma has
    two "displays" on it.

        +-----------------+   +-----------------+   +-----------------+
        |      + + +      |   |      + + +      |   |      + + +      |
        |+-----+   +-----+|   |+-----+   +-----+|   |+-----+   +-----+|
        ||     |   |     ||   ||     |   |     ||   ||     |   |     ||
        ||     |   |     ||   ||     |   |     ||   ||     |   |     ||
        || 0,0 |   | 1,0 ||-->|| 2,0 |   | 3,0 ||-->|| 4,0 |   | 5,0 ||
        ||     |   |     ||   ||     |   |     ||   ||     |   |     ||
        ||     |   |     ||   ||     |   |     ||   ||     |   |     ||
        |+-----+   +-----+|   |+-----+   +-----+|   |+-----+   +-----+|
        |      + + +      |   |      + + +      |   |      + + +      |
        +-----------------+   +-----------------+   +-----------------+
                                                           |
               +-------------------------------------------+
               |
               V
        +-----------------+   +-----------------+   +-----------------+
        |      + + +      |   |      + + +      |   |      + + +      |
        |+-----+   +-----+|   |+-----+   +-----+|   |+-----+   +-----+|
        ||     |   |     ||   ||     |   |     ||   ||     |   |     ||
        ||     |   |     ||   ||     |   |     ||   ||     |   |     ||
        || 0,1 |   | 1,1 ||-->|| 2,1 |   | 3,1 ||-->|| 4,0 |   | 5,1 ||
        ||     |   |     ||   ||     |   |     ||   ||     |   |     ||
        ||     |   |     ||   ||     |   |     ||   ||     |   |     ||
        |+-----+   +-----+|   |+-----+   +-----+|   |+-----+   +-----+|
        |      + + +      |   |      + + +      |   |      + + +      |
        +-----------------+   +-----------------+   +-----------------+

    For example:

    `set_cursor( 1,0 )` sets the cursor to the second display in the first row.

    `set_cursor( 3,1 )` sets the cursor to the fourth display in the second row.

    @param  x_position  New cursor position on the X-axis, in whole displays
    @param  y_position  New cursor position on the Y-axis, in whole displays
*///............................................................................
void PixieChroma::set_cursor( uint8_t x_position, uint8_t y_position ){
    cursor_x = extra_space_left + display_padding_x + ( display_width  * x_position );
    cursor_y = display_padding_y + ( display_height * y_position );
}


// %%%%%%%%%%%%%%%%%%%%%%%%%%%%%%%%%%%%%%%%%%%%%%%%%%%%%%%%%%%%%%%%%%%%%%%%%%%%%%%%%%%%%%%%%%%%%%%%%%%%%%%%%%
// %% FUNCTIONS - UPDATING THE MASK / LEDS %%%%%%%%%%%%%%%%%%%%%%%%%%%%%%%%%%%%%%%%%%%%%%%%%%%%%%%%%%%%%%%%%%
// %%%%%%%%%%%%%%%%%%%%%%%%%%%%%%%%%%%%%%%%%%%%%%%%%%%%%%%%%%%%%%%%%%%%%%%%%%%%%%%%%%%%%%%%%%%%%%%%%%%%%%%%%%


/*! ############################################################################
    @brief
    Clears (blackens) the current mask buffer and resets the cursor to 0,0
*///............................................................................
void PixieChroma::clear(){
    memset( mask, 0, pixel_count );
    set_cursor( 0, 0 );
}


/*! ############################################################################
    @brief
    Unfreezes the current mask buffer in memory to allow showing updated text the
    next time show() is called.
*///............................................................................
void PixieChroma::free(){
    freeze = false;
}


/*! ############################################################################
    @brief
    Freezes the current mask buffer in memory to prevent showing unfinished text
    if show() automaticall fires during construction of the current display data.
    
    Use free() to unfreeze.
*///............................................................................
void PixieChroma::hold(){
    freeze = true;
}


/*! ############################################################################
    @brief
    Processes 1D image data into truncated versions, sending them to the Pixie
    Chroma displays.
            
    @details
    FastLED.show() is called here!
*///............................................................................
void PixieChroma::show(){
    uint32_t t_now = micros();
    float frame_delta_us = t_now-t_last;
    frame_rate = 1000000.0 / frame_delta_us;
    delta = fps_target / frame_rate;
    t_last = t_now;
    
    anim_func( this, delta ); // Call custom animation function
    
    noInterrupts(); 
	
	for(uint8_t i = 0; i < chars_y; i++){
		if(scrolling[i] == false){
			int16_t x_offset = calc_justification(justifications[i], i);
			shift_mask_x( x_offset, i);
			if( custom_animation == false ){
				shift_color_map_x( x_offset, i);
			}
		}
	}
    
    if( !freeze ){ // If we're not holding out for a pix.free() call, show with the current mask
        memcpy( mask_out, mask, led_count );
    }
	
    memcpy( color_map_out, color_map, sizeof( CRGB )*led_count );

    for( uint16_t i = 0; i < led_count; i++ ){
        // MASKING
        color_map_out[i].fadeLightBy( 255-mask_out[i] ); // Apply mask "over" LED color layer
        
        // GAMMA CORRECTION
        if( correct_gamma ){
            color_map_out[i].r = gamma8[ color_map_out[i].r ]; // Apply gamma correction LUT
            color_map_out[i].g = gamma8[ color_map_out[i].g ];
            color_map_out[i].b = gamma8[ color_map_out[i].b ];
        }
    }
        
    // Regulate brightness to keep power within budget set with pix.set_max_power( V, mA );
    FastLED.setBrightness( calculate_max_brightness_for_power_vmA( color_map_out, led_count, brightness_level, max_V, max_mA ) );
    FastLED.show();

    interrupts();
}

/*! ############################################################################
    @brief
    Custom delay() function from FastLED that allows automatic refreshing of the
	displays during a delay() call, allowing things like temporal dithering to
	continue to function properly while the microcontroller waits.
	
	@param  milliseconds  Number of milliseconds to wait
*///............................................................................
void PixieChroma::delay(uint32_t milliseconds){
	FastLED.delay( milliseconds );
}

// %%%%%%%%%%%%%%%%%%%%%%%%%%%%%%%%%%%%%%%%%%%%%%%%%%%%%%%%%%%%%%%%%%%%%%%%%%%%%%%%%%%%%%%%%%%%%%%%%%%%%%%%%%
// %% FUNCTIONS - COLOR %%%%%%%%%%%%%%%%%%%%%%%%%%%%%%%%%%%%%%%%%%%%%%%%%%%%%%%%%%%%%%%%%%%%%%%%%%%%%%%%%%%%%
// %%%%%%%%%%%%%%%%%%%%%%%%%%%%%%%%%%%%%%%%%%%%%%%%%%%%%%%%%%%%%%%%%%%%%%%%%%%%%%%%%%%%%%%%%%%%%%%%%%%%%%%%%%

/*! ############################################################################
    @brief
    Sets the entire color buffer to a CRGB value.
    
    @details
    Example:
    
        pix.color( CRGB( 0,255,255 ) );
    
    This would set all displays to cyan, a mix of green and blue.
              
    @param  col  FastLED CRGB color
*///............................................................................
void PixieChroma::color( CRGB col ){
	print_col = col;
    fill_solid( color_map, pixel_count, col );
}


/*! ############################################################################
    @brief
    Sets a specific display in the color buffer to a CRGB value.
              
    @details
    Example:
    
        pix.color( CRGB( 0,255,255 ), 1, 0 );
    
    This would set the **second display of the first row** to cyan, a mix of
    green and blue.
              
    @param  col  FastLED CRGB color
    @param  x    X coordinate of display
    @param  y    y coordinate of display
*///............................................................................
void PixieChroma::color( CRGB col, uint8_t x, uint8_t y ){
    int16_t x_pos = x * display_width  + display_padding_x;
    int16_t y_pos = y * display_height + display_padding_y;
    
    for( uint8_t xi = 0; xi < font_col_width; xi++ ){
        color_map[xy( x_pos+xi, y_pos+0 )] = col;
        color_map[xy( x_pos+xi, y_pos+1 )] = col;
        color_map[xy( x_pos+xi, y_pos+2 )] = col;
        color_map[xy( x_pos+xi, y_pos+3 )] = col;
        color_map[xy( x_pos+xi, y_pos+4 )] = col;
        color_map[xy( x_pos+xi, y_pos+5 )] = col;
        color_map[xy( x_pos+xi, y_pos+6 )] = col;
    }
}


/*! ############################################################################
    @brief
    Sets a rectangular area in the color buffer to a CRGB value.
              
    @details
    Example:
    
        pix.color( CRGB( 0,255,255 ), 0, 0, 5, 5 );
    
    This would set **the first five columns and rows** of the color buffer to
    cyan, a mix of green and blue.
              
    @param    col  FastLED CRGB color
    @param    x1   Starting X coordinate of the rectangle
    @param    y1   Starting Y coordinate of the rectangle
    @param    x2   Ending X coordinate of the rectangle (inclusive)
    @param    y2   Ending Y coordinate of the rectangle (inclusive)
*///............................................................................
void PixieChroma::color( CRGB col, int16_t x1, int16_t y1, int16_t x2, int16_t y2 ){
    // Make rectangle selection inclusive
    x2 += 1;
    y2 += 1;

    if( x2 < x1 ){
		uint8_t x_temp = x2;
		x2 = x1;
		x1 = x_temp;
	}
	if( y2 < y1 ){
		uint8_t y_temp = y2;
		y2 = y1;
		y1 = y_temp;
	}
    
    uint16_t x_delta = x2 - x1;
    uint16_t y_delta = y2 - y1;
    
    for( uint16_t y = 0; y < y_delta; y++ ){
        for( uint16_t x = 0; x < x_delta; x++ ){
            int16_t x2_pos = x1 + x;
            int16_t y2_pos = y1 + y;
            color_map[xy( x2_pos, y2_pos )] = col;
        }
    }
}


/*! ############################################################################
    @brief
    All print() calls after a print_color() will be colored with this value.
	
	    print_color( CRGB::Red );
		print("Hello "); // ..........Printed in red
		print_color( CRGB::Green );
		print("World!"); // ..........Printed in green
              
    @param  col  FastLED CRGB color
*///............................................................................
void PixieChroma::print_color( CRGB col ){
    print_col = col;
}


/*! ############################################################################
    @brief
    Approximates the conversion of a blackbody radiation temperature (i.e.
    3500K) to a CRGB color object.
    
    @details
    This can be used within other Pixie color functions like so:
    
        pix.color(  kelvin_to_rgb(  3000  )  );
              
    This would render a warm-white color. This measurement system is often used
    in household LED bulbs, with colors like:

    - 2700K - **Very Warm White**
    - 3500K - **Warm White**
    - 5000K - **White**
    - 7000K - **Cool White**

    @param   temperature  Blackbody radiation temperature in Kelvin
    @return  Approximate CRGB representation of the given temperature
*///............................................................................
CRGB PixieChroma::kelvin_to_rgb( uint16_t temperature ){
    // Tanner Helland formula
    float _temperature;
    float _red;
    float _green;
    float _blue;

    _temperature = constrain( temperature, 0, 65500 );

    _red = _green = _blue = 0;  
    float t = _temperature * 0.01;

    if ( t <= 66 ){
        _red = 255;
        _green = ( 99.4708025861 * log( t ) ) - 161.1195681661;
        if ( t > 19 ){
            _blue = ( 138.5177312231 * log( t - 10 ) ) - 305.0447927307;
        }
        else{
            _blue = 0;
        }
    }
    else{
        _red   = 329.698727466  * pow( t - 60, -0.1332047592 );
        _green = 288.1221695283 * pow( t - 60, -0.0755148492 );
        _blue  = 255;
    }

    float f = 0.01 * 100;

    _red   = constrain( f * _red,   0, 255 );
    _green = constrain( f * _green, 0, 255 );
    _blue  = constrain( f * _blue,  0, 255 );

    return CRGB( _red, _green, _blue );
}


// %%%%%%%%%%%%%%%%%%%%%%%%%%%%%%%%%%%%%%%%%%%%%%%%%%%%%%%%%%%%%%%%%%%%%%%%%%%%%%%%%%%%%%%%%%%%%%%%%%%%%%%%%%
// %% FUNCTIONS - MASK EFFECTS %%%%%%%%%%%%%%%%%%%%%%%%%%%%%%%%%%%%%%%%%%%%%%%%%%%%%%%%%%%%%%%%%%%%%%%%%%%%%%
// %%%%%%%%%%%%%%%%%%%%%%%%%%%%%%%%%%%%%%%%%%%%%%%%%%%%%%%%%%%%%%%%%%%%%%%%%%%%%%%%%%%%%%%%%%%%%%%%%%%%%%%%%%

/*! ############################################################################
    @brief
    Blurs the mask buffer in both axes by blur_amount.

    @param  blur_amount  Amount to blur
*///............................................................................
void PixieChroma::blur( fract8 blur_amount ){
    blur_x( blur_amount );
    blur_y( blur_amount );
}


/*! ############################################################################
    @brief
    Blurs the mask buffer in the X axis by blur_amount.
            
    @param  blur_amount   Amount to blur
*///............................................................................
void PixieChroma::blur_x( fract8 blur_amount ){
    uint8_t keep = 255 - blur_amount;
    uint8_t seep = blur_amount >> 1;
    for(  uint8_t row = 0; row < matrix_height; row++ ) {
        uint8_t carryover = 0;
        for(  uint8_t i = 0; i < matrix_width; i++ ) {
            uint8_t cur = mask[xy( i,row )];
            uint8_t part = cur;
            part = scale8( part, seep );
            cur  = scale8( cur, keep );
            cur  = qadd8( cur,carryover );
            if( i ){
                mask[xy( i-1,row )] = qadd8( mask[xy( i-1,row )],part );
            }
            mask[xy( i,row )] = cur;
            carryover = part;
        }
    }
}


/*! ############################################################################
    @brief
    Blurs the mask buffer in the Y axis by blur_amount.
            
    @param  blur_amount  Amount to blur
*///............................................................................
void PixieChroma::blur_y( fract8 blur_amount ){
    // blur columns
    uint8_t keep = 255 - blur_amount;
    uint8_t seep = blur_amount >> 1;
    for(  uint8_t col = 0; col < matrix_width; ++col ) {
        uint8_t carryover = 0;
        for(  uint8_t i = 0; i < matrix_height; ++i ) {            
            uint8_t cur = mask[xy( col,i )];
            uint8_t part = cur;
            part = scale8( part, seep );
            cur  = scale8( cur, keep );
            cur  = qadd8( cur,carryover );
            if( i ){
                mask[xy( col,i-1 )] = qadd8( mask[xy( col,i-1 )],part );
            }
            mask[xy( col,i )] = cur;
            carryover = part;
        }
    }
}


/*! ############################################################################
    @brief
    Darkens the mask buffer by an 8-bit amount. Optionally resets the cursor
    position.
            
    @param  amount        8-bit amount to darken the mask
    @param  reset_cursor  Reset the cursor to 0,0 **(Default: false)**
*///............................................................................
void PixieChroma::dim( uint8_t amount, bool reset_cursor ){
    if( reset_cursor == true ){
        set_cursor( 0,0 );
    }
    
    for( uint16_t i = 0; i < pixel_count; i+=11 ){
        mask[i+0]  = scale8( mask[i+0],  255-amount );
        mask[i+1]  = scale8( mask[i+1],  255-amount );
        mask[i+2]  = scale8( mask[i+2],  255-amount );
        mask[i+3]  = scale8( mask[i+3],  255-amount );
        mask[i+4]  = scale8( mask[i+4],  255-amount );
        mask[i+5]  = scale8( mask[i+5],  255-amount );
        mask[i+6]  = scale8( mask[i+6],  255-amount );
        mask[i+7]  = scale8( mask[i+7],  255-amount );
        mask[i+8]  = scale8( mask[i+8],  255-amount );
        mask[i+9]  = scale8( mask[i+9],  255-amount );
        mask[i+10] = scale8( mask[i+10], 255-amount );
    }
}


// %%%%%%%%%%%%%%%%%%%%%%%%%%%%%%%%%%%%%%%%%%%%%%%%%%%%%%%%%%%%%%%%%%%%%%%%%%%%%%%%%%%%%%%%%%%%%%%%%%%%%%%%%%
// %% FUNCTIONS - COLOR EFFECTS %%%%%%%%%%%%%%%%%%%%%%%%%%%%%%%%%%%%%%%%%%%%%%%%%%%%%%%%%%%%%%%%%%%%%%%%%%%%%
// %%%%%%%%%%%%%%%%%%%%%%%%%%%%%%%%%%%%%%%%%%%%%%%%%%%%%%%%%%%%%%%%%%%%%%%%%%%%%%%%%%%%%%%%%%%%%%%%%%%%%%%%%%

/*! ############################################################################
    @brief
    Blurs the color buffer in both axes by blur_amount.
            
    @param  blur_amount  Amount to blur
*///............................................................................
void PixieChroma::color_blur( fract8 blur_amount ){
    color_blur_x( blur_amount );
    color_blur_y( blur_amount );
}


/*! ############################################################################
    @brief
    Blurs the color buffer in the X axis by blur_amount.
            
    @param  blur_amount  Amount to blur
*///............................................................................
void PixieChroma::color_blur_x( fract8 blur_amount ){
    uint8_t keep = 255 - blur_amount;
    uint8_t seep = blur_amount >> 1;
    for(  uint8_t row = 0; row < matrix_height; row++ ) {
        uint8_t carryover = 0;
        for(  uint8_t i = 0; i < matrix_width; i++ ) {
            CRGB cur = color_map[xy( i,row )];
            CRGB part = cur;
            part.nscale8(  seep );
            cur.nscale8(  keep );
            cur += carryover;
            if(  i ) color_map[xy( i-1,row )] += part;
            color_map[xy( i,row )] = cur;
            carryover = part;
        }
    }
}


/*! ############################################################################
    @brief
    Blurs the color buffer in the Y axis by blur_amount.
            
    @param  blur_amount  Amount to blur
*///............................................................................
void PixieChroma::color_blur_y( fract8 blur_amount ){
    // blur rows same as columns, for irregular matrix
    uint8_t keep = 255 - blur_amount;
    uint8_t seep = blur_amount >> 1;
    for(  uint8_t row = 0; row < matrix_width; row++ ) {
        CRGB carryover = CRGB::Black;
        for(  uint8_t i = 0; i < matrix_height; i++ ) {
            CRGB cur = color_map[xy( i,row )];
            CRGB part = cur;
            part.nscale8(  seep );
            cur.nscale8(  keep );
            cur += carryover;
            if(  i ) color_map[xy( i-1,row )] += part;
            color_map[xy( i,row )] = cur;
            carryover = part;
        }
    }
}


/*! ############################################################################
    @brief
    Darkens the color buffer by an 8-bit amount.
            
    @param  amount  8-bit amount to darken the mask
*///............................................................................
void PixieChroma::color_dim( uint8_t amount ){
    CRGBSet leds_temp( color_map, pixel_count );
    leds_temp.fadeToBlackBy( amount );
}


// %%%%%%%%%%%%%%%%%%%%%%%%%%%%%%%%%%%%%%%%%%%%%%%%%%%%%%%%%%%%%%%%%%%%%%%%%%%%%%%%%%%%%%%%%%%%%%%%%%%%%%%%%%
// %% FUNCTIONS - 2D TOOLS %%%%%%%%%%%%%%%%%%%%%%%%%%%%%%%%%%%%%%%%%%%%%%%%%%%%%%%%%%%%%%%%%%%%%%%%%%%%%%%%%%
// %%%%%%%%%%%%%%%%%%%%%%%%%%%%%%%%%%%%%%%%%%%%%%%%%%%%%%%%%%%%%%%%%%%%%%%%%%%%%%%%%%%%%%%%%%%%%%%%%%%%%%%%%%

/*! ############################################################################
    @brief
    Draws a line in the color map using Bresenham's line algorithm.
        
    @param  x1     Starting X coordinate of the line
    @param  y1     Starting Y coordinate of the line
    @param  x2     Ending X coordinate of the line (inclusive)
    @param  y2     Ending Y coordinate of the line (inclusive)
	@param  color  CRGB color to draw
*///............................................................................
void PixieChroma::draw_line_color( int16_t x1, int16_t y1, int16_t x2, int16_t y2, CRGB color ){
    //Bresenham's line algorithm
    uint16_t index;
    
    int16_t x,y,dx,dy,dx1,dy1,px,py,xe,ye,i;
    dx=x2-x1;
    dy=y2-y1;
    dx1=fabs( dx );
    dy1=fabs( dy );
    px=2*dy1-dx1;
    py=2*dx1-dy1;
    if( dy1<=dx1 ){
        if( dx>=0 ){
            x=x1;
            y=y1;
            xe=x2;
        }
        else{
            x=x2;
            y=y2;
            xe=x1;
        }
        set_pixel_color( x, y, color );
        for( i=0;x<xe;i++ ){
            x=x+1;
            if( px<0 ){
                px=px+2*dy1;
            }
            else{
                if( ( dx<0 && dy<0 ) || ( dx>0 && dy>0 ) ){
                    y=y+1;
                }
                else{
                    y=y-1;
                }
                px=px+2*( dy1-dx1 );
            }
            set_pixel_color( x, y, color );
        }
    }
    else{
        if( dy>=0 ){
            x=x1;
            y=y1;
            ye=y2;
        }
        else{
            x=x2;
            y=y2;
            ye=y1;
        }
        set_pixel_color( x, y, color );
        for( i=0;y<ye;i++ ){
            y=y+1;
            if( py<=0 ){
                py=py+2*dx1;
            }
            else{
                if( ( dx<0 && dy<0 ) || ( dx>0 && dy>0 ) ){
                    x=x+1;
                }
                else{
                    x=x-1;
                }
                py=py+2*( dx1-dy1 );
            }
            set_pixel_color( x, y, color );
        }
    }
}


/*! ############################################################################
    @brief
    Draws a line in the mask buffer using Bresenham's line algorithm.
        
    @param  x1     Starting X coordinate of the line
    @param  y1     Starting Y coordinate of the line
    @param  x2     Ending X coordinate of the line (inclusive)
    @param  y2     Ending Y coordinate of the line (inclusive)
	@param  value  8-bit mask value to draw (Default 255)
*///............................................................................
void PixieChroma::draw_line_mask( int16_t x1, int16_t y1, int16_t x2, int16_t y2, uint8_t value ){
    //Bresenham's line algorithm
    uint16_t index;
    
    int16_t x,y,dx,dy,dx1,dy1,px,py,xe,ye,i;
    dx=x2-x1;
    dy=y2-y1;
    dx1=fabs( dx );
    dy1=fabs( dy );
    px=2*dy1-dx1;
    py=2*dx1-dy1;
    if( dy1<=dx1 ){
        if( dx>=0 ){
            x=x1;
            y=y1;
            xe=x2;
        }
        else{
            x=x2;
            y=y2;
            xe=x1;
        }
        set_pixel_mask( x, y, value );
        for( i=0;x<xe;i++ ){
            x=x+1;
            if( px<0 ){
                px=px+2*dy1;
            }
            else{
                if( ( dx<0 && dy<0 ) || ( dx>0 && dy>0 ) ){
                    y=y+1;
                }
                else{
                    y=y-1;
                }
                px=px+2*( dy1-dx1 );
            }
			set_pixel_mask( x, y, value );
        }
    }
    else{
        if( dy>=0 ){
            x=x1;
            y=y1;
            ye=y2;
        }
        else{
            x=x2;
            y=y2;
            ye=y1;
        }
        set_pixel_mask( x, y, value );
        for( i=0;y<ye;i++ ){
            y=y+1;
            if( py<=0 ){
                py=py+2*dx1;
            }
            else{
                if( ( dx<0 && dy<0 ) || ( dx>0 && dy>0 ) ){
                    x=x+1;
                }
                else{
                    x=x-1;
                }
                py=py+2*( dx1-dy1 );
            }
            set_pixel_mask( x, y, value );
        }
    }
}


/*! ############################################################################
    @brief
	Returns the X-axis UV coordinate for a given X-axis pixel position
    
    @param   x_pixel  X-axis pixel position
    @return  X-axis UV coordinate
*///............................................................................
float PixieChroma::get_uv_x( int32_t x_pixel ){
    return x_pixel / float( matrix_width );
}


/*! ############################################################################
    @brief
	Returns the Y-axis UV coordinate for a given Y-axis pixel position
    
    @param   y_pixel  Y-axis pixel position
    @return  Y-axis UV coordinate
*///............................................................................
float PixieChroma::get_uv_y( int32_t y_pixel ){
	y_pixel = matrix_height - y_pixel;
    return y_pixel / float( matrix_height );
}


/*! ############################################################################
    @brief
    Gets the mask value at a given pixel coordinate.
        
    @param   x  X pixel coordinate
    @param   y  Y pixel coordinate
	@return  Mask value
*///............................................................................
uint8_t PixieChroma::get_pixel_mask( int32_t x, int32_t y ){
	return mask[ xy(x,y) ];
}


/*! ############################################################################
    @brief
    Gets the RGB color value at a given pixel coordinate.
        
    @param   x  X pixel coordinate
    @param   y  Y pixel coordinate
	@return  CRGB color
*///............................................................................
CRGB PixieChroma::get_pixel_color( int32_t x, int32_t y ){
	return color_map[ xy(x,y) ];
}


/*! ############################################################################
    @brief
    Prints the index table for the calculated XY map. **Requires Serial.begin()
    first to function.**
    
    @details
    Useful for debugging, the index table (XY Map) can be printed over Serial.
    Each cell of the table denotes at what index that physical pixel location is
    inside of the 1D color_map / mask arrays. (The xy() function uses this table
    to translate real-world 2D coordinates to 1D indices.)
    
    For example, here is the XY Table for a single Pixie:
    
    |       |        |        |        |        |        |       |       |        |        |        |        |        |       |
    |-------|--------|--------|--------|--------|--------|-------|-------|--------|--------|--------|--------|--------|-------|
    | *70*  | *71*   | *72*   | *73*   | *74*   | *75*   | *76*  | *77*  | *78*   | *79*   | *80*   | *81*   | *82*   | *83*  |
    | *84*  | *85*   | *86*   | *87*   | *88*   | *89*   | *90*  | *91*  | *92*   | *93*   | *94*   | *95*   | *96*   | *97*  | 
    | *98*  | **0**  | **1**  | **2**  | **3**  | **4**  | *99*  | *100* | **35** | **36** | **37** | **38** | **39** | *101* | 
    | *102* | **5**  | **6**  | **7**  | **8**  | **9**  | *103* | *104* | **40** | **41** | **42** | **43** | **44** | *105* | 
    | *106* | **10** | **11** | **12** | **13** | **14** | *107* | *108* | **45** | **46** | **47** | **48** | **49** | *109* | 
    | *110* | **15** | **16** | **17** | **18** | **19** | *111* | *112* | **50** | **51** | **52** | **53** | **54** | *113* | 
    | *114* | **20** | **21** | **22** | **23** | **24** | *115* | *116* | **55** | **56** | **57** | **58** | **59** | *117* | 
    | *118* | **25** | **26** | **27** | **28** | **29** | *119* | *120* | **60** | **61** | **62** | **63** | **64** | *121* | 
    | *122* | **30** | **31** | **32** | **33** | **34** | *123* | *124* | **65** | **66** | **67** | **68** | **69** | *125* | 
    | *126* | *127*  | *128*  | *129*  | *130*  | *131*  | *132* | *133* | *134*  | *135*  | *136*  | *137*  | *138*  | *139* | 
    | *140* | *141*  | *142*  | *143*  | *144*  | *145*  | *146* | *147* | *148*  | *149*  | *150*  | *151*  | *152*  | *153* |
    
    - **BOLD** = Visible Pixel
    - *ITALIC* = Invisible Pixel
    
    Starting from `0` at the top-left with the first visible pixel, (of the first
    display in the XY Table) the index increases to `69`, (the last visible
    pixel in the matrix) before starting to count invisible pixels at index `70`
    and up through `153`.
    
    With this example table setup, the first 70 indices of color_map / mask are
    visible pixels, and the remaining 84 are invisible. (Simulated margin between
    displays)
    
*///............................................................................
void PixieChroma::print_xy_table(){
    for( uint8_t y = 0; y < matrix_height; y++ ){
        for( uint8_t x = 0; x < matrix_width; x++ ){
            uint16_t index = ( matrix_width*y )+x;
            Serial.print( xy_table[index] );
            Serial.print( '\t' );
        }
        Serial.println();
    }
}


/*! ############################################################################
    @brief
    Scrolls a message across the matrix by constructing it one character at a
	time in the dead-space outside the visible area and scrolling it in from the
	right.
    
	@param   message  Message to scroll across the matrix
	@param   row      Row to scroll the message on (default 0)
*///............................................................................
void PixieChroma::scroll_message( char* message, uint8_t row ){	
	scrolling[row] = true;

	uint16_t len = strlen(message);
	uint16_t i = 0;
	while (i < len - 1) {	
		if (message[i] == '[' && message[i + 1] == ':') { // Found start of shortcode
			for (uint16_t j = i; j < len - 1; j++) {
				if (message[j] == ':' && message[j + 1] == ']') { // Found end of shortcode
					fetch_shortcode( message, i + 2, j, true );
					scroll_char(temp_code, row);
					i = j + 2;
					break;
				}
			}
		}
		else {
			scroll_char(message[i], row);
			i += 1;
		}
	}

	if(message[len-1] != ']'){ // If message doesn't end with shortcode
		scroll_char(message[len-1], row);
	}
	
	for(uint8_t i = 0; i < chars_x; i++){
		scroll_char(' ', row);
	}
	
	scrolling[row] = false;
}


/*! ############################################################################
    @brief
    Sets the mask value at a given pixel coordinate.
        
    @param   x      X pixel coordinate
    @param   y      Y pixel coordinate
	@param   value  Mask value
*///............................................................................
void PixieChroma::set_pixel_mask( int32_t x, int32_t y, uint8_t value ){
	mask[ xy(x,y) ] = value;
}


/*! ############################################################################
    @brief
    Sets the RGB color value at a given pixel coordinate.
        
    @param   x      X pixel coordinate
    @param   y      Y pixel coordinate
	@param   color  CRGB color
*///............................................................................
void PixieChroma::set_pixel_color( int32_t x, int32_t y, CRGB color ){
	color_map[ xy(x,y) ] = color;
}


/*! ############################################################################
    @brief
	Shifts the mask data by `amount` on the X axis. Useful for scrolling or
	justification!
    
    @param   amount  Amount in whole-pixels to shift the mask data
    @param   row     If not the default (-1), shift only the specified row
*///............................................................................
void PixieChroma::shift_mask_x( int16_t amount, int16_t row ){
	int16_t y_start = 0;
	int16_t y_end   = matrix_height;
	
	if(row != -1){
		y_start = display_height*row;
		y_end   = display_height*(row+1);
	}
	
	if(amount < 0){
		for( uint16_t x = 0; x < matrix_width; x++ ){
			for( uint16_t y = y_start; y < y_end; y++ ){
				int16_t x_dest = x - amount;
				int16_t y_dest = y - 0;
				
				if(x_dest >= 0 && y_dest >= 0 && x_dest < matrix_width && y_dest < matrix_height){
					mask[ xy( x,y )  ] = mask[ xy( x_dest, y_dest ) ];
				}
				else{
					mask[ xy( x,y )  ] = 0;
				}
			}
		}
	}
	else if(amount > 0){
		for( int16_t x = matrix_width; x >= 0; x-- ){
			for( uint16_t y = y_start; y < y_end; y++ ){
				int16_t x_dest = x - amount;
				int16_t y_dest = y - 0;
				
				if(x_dest >= 0 && y_dest >= 0 && x_dest < matrix_width && y_dest < matrix_height){
					mask[ xy( x,y )  ] = mask[ xy( x_dest, y_dest ) ];
				}
				else{
					mask[ xy( x,y )  ] = 0;
				}
			}
		}
	}
}


/*! ############################################################################
    @brief
	Shifts the mask data by `amount` on the Y axis. Useful for scrolling!
    
    @param   amount  Amount in whole-pixels to shift the mask data
*///............................................................................
void PixieChroma::shift_mask_y( int16_t amount ){
	if(amount < 0){
		for( uint16_t y = 0; y < matrix_height; y++ ){
			for( uint16_t x = 0; x < matrix_width; x++ ){
				int16_t x_dest = x - 0;
				int16_t y_dest = y - amount;
				
				if(x_dest >= 0 && y_dest >= 0 && x_dest < matrix_width && y_dest < matrix_height){
					mask[ xy( x,y )  ] = mask[ xy( x_dest, y_dest ) ];
				}
				else{
					mask[ xy( x,y )  ] = 0;
				}
			}
		}
	}
	else if(amount > 0){
		for( int16_t y = matrix_height; y >= 0; y-- ){
			for( uint16_t x = 0; x < matrix_width; x++ ){
				int16_t x_dest = x - 0;
				int16_t y_dest = y - amount;
				
				if(x_dest >= 0 && y_dest >= 0 && x_dest < matrix_width && y_dest < matrix_height){
					mask[ xy( x,y )  ] = mask[ xy( x_dest, y_dest ) ];
				}
				else{
					mask[ xy( x,y )  ] = 0;
				}
			}
		}
	}
}


/*! ############################################################################
    @brief
	Shifts the color_map data by `amount` on the X axis. Useful for scrolling or
	justification!
    
    @param   amount  Amount in whole-pixels to shift the color map data
    @param   row     If not the default (-1), shift only the specified row
*///............................................................................
void PixieChroma::shift_color_map_x( int16_t amount, int16_t row ){
	int16_t y_start = 0;
	int16_t y_end   = matrix_height;
	
	if(row != -1){
		y_start = display_height*row;
		y_end   = display_height*(row+1);
	}
	
	if(amount < 0){
		for( uint16_t x = 0; x < matrix_width; x++ ){
			for( uint16_t y = y_start; y < y_end; y++ ){
				int16_t x_dest = x - amount;
				int16_t y_dest = y - 0;
				
				if(x_dest >= 0 && y_dest >= 0 && x_dest < matrix_width && y_dest < matrix_height){
					color_map[ xy( x,y )  ] = color_map[ xy( x_dest, y_dest ) ];
				}
				else{
					color_map[ xy( x,y )  ] = 0;
				}
				
			}
		}
	}
	else if(amount > 0){
		for( int16_t x = matrix_width; x >= 0; x-- ){
			for( uint16_t y = y_start; y < y_end; y++ ){
				int16_t x_dest = x - amount;
				int16_t y_dest = y - 0;
				
				if(x_dest >= 0 && y_dest >= 0 && x_dest < matrix_width && y_dest < matrix_height){
					color_map[ xy( x,y )  ] = color_map[ xy( x_dest, y_dest ) ];
				}
				else{
					color_map[ xy( x,y )  ] = 0;
				}
			}
		}
	}
}


/*! ############################################################################
    @brief
	Shifts the color map data by `amount` on the Y axis. Useful for scrolling!
    
    @param   amount  Amount in whole-pixels to shift the color map data
*///............................................................................
void PixieChroma::shift_color_map_y( int16_t amount ){	
	if(amount < 0){
		for( uint16_t x = 0; x < matrix_width; x++ ){
			for( uint16_t y = 0; y < matrix_height; y++ ){
				int16_t x_dest = x - 0;
				int16_t y_dest = y - amount;
				
				if(x_dest >= 0 && y_dest >= 0 && x_dest < matrix_width && y_dest < matrix_height){
					color_map[ xy( x,y )  ] = color_map[ xy( x_dest, y_dest ) ];
				}
				else{
					color_map[ xy( x,y )  ] = 0;
				}
			}
		}
	}
	else if(amount > 0){
		for( int16_t x = matrix_width; x >= 0; x-- ){
			for( uint16_t y = 0; y < matrix_height; y++ ){
				int16_t x_dest = x - amount;
				int16_t y_dest = y - 0;
				
				if(x_dest >= 0 && y_dest >= 0 && x_dest < matrix_width && y_dest < matrix_height){
					color_map[ xy( x,y )  ] = color_map[ xy( x_dest, y_dest ) ];
				}
				else{
					color_map[ xy( x,y )  ] = 0;
				}				
			}
		}
	}
}


/*! ############################################################################
    @brief
    This wrapper function returns the 1D color_map / mask index of a given
	OpenGL-style UV coordinate in the display matrix.
    
    @details
    See xy(). UV Map:
	
		+-------------------+
		|0, 1           1, 1|
		|                   |
		|^                  |
		|                   |
		|0, 0     >     1, 0|
		+-------------------+
    
    @param   x     Floating-point UV X coordinate
    @param   y     Floating-point UV Y coordinate
    @param   wrap  Enable wrapping function **[optional]**
    @return  The 1D LED index of your UV coordinate
*///............................................................................
uint16_t PixieChroma::uv( float x, float y, bool wrap ) {
	if( wrap ){
		while( x < 0.0 ){
			x += 1.0;
		}
		while( x > 1.0 ){
			x -= 1.0;
		}
		while( y < 0.0 ){
			y += 1.0;
		}
		while( y > 1.0 ){
			y -= 1.0;
		}
	}
	
	y = 1.0-y; // Invert Y axis for OpenGL coordinate style
	
	return xy(
		uint16_t( matrix_width  * x ),
		uint16_t( matrix_height * y )
	);
}


/*! ############################################################################
    @brief
    This function returns the 1D color_map / mask index of a given 2D coordinate
    in the display matrix.
              
    @details
    The XY Table is generated during `begin()` by an internal function,
    `calc_xy()`. Each cell of the table denotes at what index that physical
    pixel location is inside of the 1D color_map / mask arrays.
    
    For example, here is the XY Table for a single Pixie:
    
    |       |        |        |        |        |        |       |       |        |        |        |        |        |       |
    |-------|--------|--------|--------|--------|--------|-------|-------|--------|--------|--------|--------|--------|-------|
    | *70*  | *71*   | *72*   | *73*   | *74*   | *75*   | *76*  | *77*  | *78*   | *79*   | *80*   | *81*   | *82*   | *83*  |
    | *84*  | *85*   | *86*   | *87*   | *88*   | *89*   | *90*  | *91*  | *92*   | *93*   | *94*   | *95*   | *96*   | *97*  | 
    | *98*  | **0**  | **1**  | **2**  | **3**  | **4**  | *99*  | *100* | **35** | **36** | **37** | **38** | **39** | *101* | 
    | *102* | **5**  | **6**  | **7**  | **8**  | **9**  | *103* | *104* | **40** | **41** | **42** | **43** | **44** | *105* | 
    | *106* | **10** | **11** | **12** | **13** | **14** | *107* | *108* | **45** | **46** | **47** | **48** | **49** | *109* | 
    | *110* | **15** | **16** | **17** | **18** | **19** | *111* | *112* | **50** | **51** | **52** | **53** | **54** | *113* | 
    | *114* | **20** | **21** | **22** | **23** | **24** | *115* | *116* | **55** | **56** | **57** | **58** | **59** | *117* | 
    | *118* | **25** | **26** | **27** | **28** | **29** | *119* | *120* | **60** | **61** | **62** | **63** | **64** | *121* | 
    | *122* | **30** | **31** | **32** | **33** | **34** | *123* | *124* | **65** | **66** | **67** | **68** | **69** | *125* | 
    | *126* | *127*  | *128*  | *129*  | *130*  | *131*  | *132* | *133* | *134*  | *135*  | *136*  | *137*  | *138*  | *139* | 
    | *140* | *141*  | *142*  | *143*  | *144*  | *145*  | *146* | *147* | *148*  | *149*  | *150*  | *151*  | *152*  | *153* |
    
    - **BOLD** = Visible Pixel
    - *ITALIC* = Invisible Pixel
    
    With this example table, a given XY coordinate of `(3, 4)` would return
    `12`. Thus, modifying the color_map or mask at index `12` would influence
    the pixel at the physical location of `(3, 4)`.
    
    Starting from `0` at the top-left with the first visible pixel, (of the first
    display in the XY Table) the index increases to `69`, (the last visible
    pixel in the matrix) before starting to count invisible pixels at index `70`
    and up through `153`.
    
    With this example table setup, the first 70 indices of color_map / mask are
    visible pixels, and the remaining 84 are invisible. (Simulated margin between
    displays)

    Optionally, the result of this function can be run through a wrapping
    function that allows coordinates out of range to wrap around to the
    opposite side of the 2D matrix.
    
    If wrap is not enabled, any coordinates outside of the display matrix will
    be parsed to a 1D index that is completely unused and unseen.
        
    @param   x     Signed 2D X coordinate
    @param   y     Signed 2D Y coordinate
    @param   wrap  Enable wrapping function **[optional]**
    @return  The 1D LED index of your 2D XY coordinate
*///............................................................................
uint16_t PixieChroma::xy( int32_t x, int32_t y, bool wrap ) {
    if( wrap ){
        while( x < 0 ){
            x += matrix_width;
        }
        while( x >= matrix_width ){
            x -= matrix_width;
        }
        while( y < 0 ){
            y += matrix_height;
        }
        while( y >= matrix_height ){
            y -= matrix_height;
        }
    }
    else{
        if( x < 0 ){
            return pixel_count; // If offscreen without wrap return last led in matrix
        }
        else if( x >= matrix_width ){
            return pixel_count; // If offscreen without wrap return last led in matrix
        }
        if( y < 0 ){
            return pixel_count; // If offscreen without wrap return last led in matrix
        }
        else if( y >= matrix_height ){
            return pixel_count; // If offscreen without wrap return last led in matrix
        }
    }

    // done wrapping / culling, time for transformation
    return xy_table[ ( y * matrix_width ) + x ];
}



// ---------------------------------------------------------------------------------------------------------|
// -- PRIVATE CLASS FUNCTIONS ------------------------------------------------------------------------------|
// ---------------------------------------------------------------------------------------------------------|

void PixieChroma::build_controller( const uint8_t pin ){
    // FastLED control pin has to be defined as a constant, ( not just declared const, it's weirdly different ) so
    // this is a hacky workaround. Since we have to hardwire the damn pin number variable, we also have
    // to be careful of the current architecture we're compiling to, since FastLED doesn't let you 
    // define non-existent pins either.
    
    #ifdef ARDUINO_ARCH_ESP8266
        if ( pin == 0 ){FastLED.addLeds<WS2812B, 0, GRB>( color_map_out, led_count ).setCorrection( TypicalLEDStrip );}
        if ( pin == 1 ){FastLED.addLeds<WS2812B, 1, GRB>( color_map_out, led_count ).setCorrection( TypicalLEDStrip );}
        if ( pin == 2 ){FastLED.addLeds<WS2812B, 2, GRB>( color_map_out, led_count ).setCorrection( TypicalLEDStrip );}
        if ( pin == 3 ){FastLED.addLeds<WS2812B, 3, GRB>( color_map_out, led_count ).setCorrection( TypicalLEDStrip );}
        if ( pin == 4 ){FastLED.addLeds<WS2812B, 4, GRB>( color_map_out, led_count ).setCorrection( TypicalLEDStrip );}
        if ( pin == 5 ){FastLED.addLeds<WS2812B, 5, GRB>( color_map_out, led_count ).setCorrection( TypicalLEDStrip );}
            // annnnd a bunch of missing pins that are tied to external flash...
        if ( pin == 12 ){FastLED.addLeds<WS2812B, 12, GRB>( color_map_out, led_count ).setCorrection( TypicalLEDStrip );}
        if ( pin == 13 ){FastLED.addLeds<WS2812B, 13, GRB>( color_map_out, led_count ).setCorrection( TypicalLEDStrip );}
        if ( pin == 14 ){FastLED.addLeds<WS2812B, 14, GRB>( color_map_out, led_count ).setCorrection( TypicalLEDStrip );}
        if ( pin == 15 ){FastLED.addLeds<WS2812B, 15, GRB>( color_map_out, led_count ).setCorrection( TypicalLEDStrip );}
        if ( pin == 16 ){FastLED.addLeds<WS2812B, 16, GRB>( color_map_out, led_count ).setCorrection( TypicalLEDStrip );}
    #endif
    
    #ifdef ARDUINO_ARCH_ESP32
        if ( pin == 0 ){FastLED.addLeds<WS2812B, 0, GRB>( color_map_out, led_count ).setCorrection( TypicalLEDStrip );}
        if ( pin == 1 ){FastLED.addLeds<WS2812B, 1, GRB>( color_map_out, led_count ).setCorrection( TypicalLEDStrip );}
        if ( pin == 2 ){FastLED.addLeds<WS2812B, 2, GRB>( color_map_out, led_count ).setCorrection( TypicalLEDStrip );}
        if ( pin == 3 ){FastLED.addLeds<WS2812B, 3, GRB>( color_map_out, led_count ).setCorrection( TypicalLEDStrip );}
        if ( pin == 4 ){FastLED.addLeds<WS2812B, 4, GRB>( color_map_out, led_count ).setCorrection( TypicalLEDStrip );}
        if ( pin == 5 ){FastLED.addLeds<WS2812B, 5, GRB>( color_map_out, led_count ).setCorrection( TypicalLEDStrip );}
        if ( pin == 12 ){FastLED.addLeds<WS2812B, 12, GRB>( color_map_out, led_count ).setCorrection( TypicalLEDStrip );}
        if ( pin == 13 ){FastLED.addLeds<WS2812B, 13, GRB>( color_map_out, led_count ).setCorrection( TypicalLEDStrip );}
        if ( pin == 14 ){FastLED.addLeds<WS2812B, 14, GRB>( color_map_out, led_count ).setCorrection( TypicalLEDStrip );}
        if ( pin == 15 ){FastLED.addLeds<WS2812B, 15, GRB>( color_map_out, led_count ).setCorrection( TypicalLEDStrip );}
        if ( pin == 16 ){FastLED.addLeds<WS2812B, 16, GRB>( color_map_out, led_count ).setCorrection( TypicalLEDStrip );}
        if ( pin == 17 ){FastLED.addLeds<WS2812B, 17, GRB>( color_map_out, led_count ).setCorrection( TypicalLEDStrip );}
        if ( pin == 18 ){FastLED.addLeds<WS2812B, 18, GRB>( color_map_out, led_count ).setCorrection( TypicalLEDStrip );}
        if ( pin == 19 ){FastLED.addLeds<WS2812B, 19, GRB>( color_map_out, led_count ).setCorrection( TypicalLEDStrip );}
        if ( pin == 21 ){FastLED.addLeds<WS2812B, 21, GRB>( color_map_out, led_count ).setCorrection( TypicalLEDStrip );}
        if ( pin == 22 ){FastLED.addLeds<WS2812B, 22, GRB>( color_map_out, led_count ).setCorrection( TypicalLEDStrip );}
        if ( pin == 23 ){FastLED.addLeds<WS2812B, 23, GRB>( color_map_out, led_count ).setCorrection( TypicalLEDStrip );}
        if ( pin == 25 ){FastLED.addLeds<WS2812B, 25, GRB>( color_map_out, led_count ).setCorrection( TypicalLEDStrip );}
        if ( pin == 26 ){FastLED.addLeds<WS2812B, 26, GRB>( color_map_out, led_count ).setCorrection( TypicalLEDStrip );}
        if ( pin == 27 ){FastLED.addLeds<WS2812B, 27, GRB>( color_map_out, led_count ).setCorrection( TypicalLEDStrip );}
        if ( pin == 32 ){FastLED.addLeds<WS2812B, 32, GRB>( color_map_out, led_count ).setCorrection( TypicalLEDStrip );}
        if ( pin == 33 ){FastLED.addLeds<WS2812B, 33, GRB>( color_map_out, led_count ).setCorrection( TypicalLEDStrip );}
    #endif
    
    #ifdef ARDUINO_ARCH_TEENSY_3_X
        if ( pin == 0 ){FastLED.addLeds<WS2812B, 0, GRB>( color_map_out, led_count ).setCorrection( TypicalLEDStrip );}
        if ( pin == 1 ){FastLED.addLeds<WS2812B, 1, GRB>( color_map_out, led_count ).setCorrection( TypicalLEDStrip );}
        if ( pin == 2 ){FastLED.addLeds<WS2812B, 2, GRB>( color_map_out, led_count ).setCorrection( TypicalLEDStrip );}
        if ( pin == 3 ){FastLED.addLeds<WS2812B, 3, GRB>( color_map_out, led_count ).setCorrection( TypicalLEDStrip );}
        if ( pin == 4 ){FastLED.addLeds<WS2812B, 4, GRB>( color_map_out, led_count ).setCorrection( TypicalLEDStrip );}
        if ( pin == 5 ){FastLED.addLeds<WS2812B, 5, GRB>( color_map_out, led_count ).setCorrection( TypicalLEDStrip );}
        if ( pin == 6 ){FastLED.addLeds<WS2812B, 6, GRB>( color_map_out, led_count ).setCorrection( TypicalLEDStrip );}
        if ( pin == 7 ){FastLED.addLeds<WS2812B, 7, GRB>( color_map_out, led_count ).setCorrection( TypicalLEDStrip );}
        if ( pin == 8 ){FastLED.addLeds<WS2812B, 8, GRB>( color_map_out, led_count ).setCorrection( TypicalLEDStrip );}
        if ( pin == 9 ){FastLED.addLeds<WS2812B, 9, GRB>( color_map_out, led_count ).setCorrection( TypicalLEDStrip );}
        if ( pin == 10 ){FastLED.addLeds<WS2812B, 10, GRB>( color_map_out, led_count ).setCorrection( TypicalLEDStrip );}
        if ( pin == 11 ){FastLED.addLeds<WS2812B, 11, GRB>( color_map_out, led_count ).setCorrection( TypicalLEDStrip );}
        if ( pin == 12 ){FastLED.addLeds<WS2812B, 12, GRB>( color_map_out, led_count ).setCorrection( TypicalLEDStrip );}
        if ( pin == 13 ){FastLED.addLeds<WS2812B, 13, GRB>( color_map_out, led_count ).setCorrection( TypicalLEDStrip );}
        if ( pin == 14 ){FastLED.addLeds<WS2812B, 14, GRB>( color_map_out, led_count ).setCorrection( TypicalLEDStrip );}
        if ( pin == 15 ){FastLED.addLeds<WS2812B, 15, GRB>( color_map_out, led_count ).setCorrection( TypicalLEDStrip );}
        if ( pin == 16 ){FastLED.addLeds<WS2812B, 16, GRB>( color_map_out, led_count ).setCorrection( TypicalLEDStrip );}
        if ( pin == 17 ){FastLED.addLeds<WS2812B, 17, GRB>( color_map_out, led_count ).setCorrection( TypicalLEDStrip );}
        if ( pin == 18 ){FastLED.addLeds<WS2812B, 18, GRB>( color_map_out, led_count ).setCorrection( TypicalLEDStrip );}
        if ( pin == 19 ){FastLED.addLeds<WS2812B, 19, GRB>( color_map_out, led_count ).setCorrection( TypicalLEDStrip );}
        if ( pin == 20 ){FastLED.addLeds<WS2812B, 20, GRB>( color_map_out, led_count ).setCorrection( TypicalLEDStrip );}
        if ( pin == 21 ){FastLED.addLeds<WS2812B, 21, GRB>( color_map_out, led_count ).setCorrection( TypicalLEDStrip );}
        if ( pin == 22 ){FastLED.addLeds<WS2812B, 22, GRB>( color_map_out, led_count ).setCorrection( TypicalLEDStrip );}
        if ( pin == 23 ){FastLED.addLeds<WS2812B, 23, GRB>( color_map_out, led_count ).setCorrection( TypicalLEDStrip );}
    #endif
}


void PixieChroma::calc_xy(){	
  // Initialize XY table
    for( uint16_t yi = 0; yi < chars_y; yi++ ){
        for( uint16_t y = 0; y < 11; y++ ){
            for( uint16_t xi = 0; xi < chars_x; xi++ ){
                for( uint16_t x = 0; x < 7; x++ ){
                    int16_t x_pos = ( xi*display_width )+x;
                    int16_t y_pos = ( yi*display_height )+y;

                    int16_t x_pos_mod = x_pos % display_width;
                    int16_t y_pos_mod = y_pos % display_height;

                    uint16_t i_table = ( y_pos * matrix_width ) + x_pos;
                    uint16_t i_template = ( y_pos_mod * display_width ) + x_pos_mod;

					if(xi != 0 && xi != chars_x-1){
						xy_table[i_table] = int8_t( pgm_read_byte( xy_template + i_template ) );
					}
					else{
						xy_table[i_table] = -2;
					}
                }
            }
        }
    }

    //Serial.println( "SOLVING VISIBLE" );

    // Initialize first row of displays
    uint8_t visible_rows = 0;
    for( uint16_t row = 0; row < display_height; row++ ){
        uint16_t index = ( 5*visible_rows );
        bool found_visible = false;
        int16_t last_data = 0;
        for( uint16_t col = 0; col < matrix_width; col++ ){
            uint16_t i = ( row*matrix_width )+col;
            int16_t map_data = xy_table[i];

            if( map_data == -1 ){
                xy_table[i] = index;
                index++;
                found_visible = true;
            }

            else if( map_data == -2 ){
                if( last_data == -1 ){
                    index+=30;
                }
            }

            last_data = map_data;
        }

        if( found_visible ){
            visible_rows++;
        }
    }

    led_count = 35*(chars_x-2); // account for first row

    // Solve additional rows
    if( chars_y > 1 ){
        uint8_t rows_left = chars_y-1;
        uint16_t row_length = ( display_width*display_height )*chars_x;
        for( uint8_t ii = 0; ii < rows_left; ii++ ){
            for( uint16_t r = 0; r < row_length; r++ ){
                uint16_t final_src_index = ( ii*row_length )+r;
                int16_t src_data = xy_table[final_src_index];
                if( src_data >= 0 ){
                    src_data += ( 35*(chars_x-2) );

                    if( src_data > led_count ){
                        led_count = src_data+1;
                    }
                    xy_table[final_src_index+row_length] = src_data;
                }
            }
        }
    }

    uint16_t index = led_count;

    //Serial.println( "SOLVING INVISIBLE" );
    for( uint16_t y = 0; y < matrix_height; y++ ){
        for( uint16_t x = 0; x < matrix_width; x++ ){
            uint16_t i = ( y * matrix_width ) + x;
            uint16_t j = xy_table[i];

            if( xy_table[i] == -2 ){
                xy_table[i] = index;
                index++;
            }
        }
    }
    //Serial.println( "DONE" );
}


void PixieChroma::fetch_shortcode( char* message, uint16_t code_start, uint16_t code_end, bool return_code ){
	if( message[code_start] == '#' ){ // custom data, no lookup needed
		parse_custom_shortcode( message, code_start+1, code_end, return_code );
		return;
	}
	char bitmap_name[32];
	memset(bitmap_name, 0, 32);
	char bitmap_temp[32];
	memset(bitmap_temp, 0, 32);
	uint8_t bitmap_temp_index = 0;

	uint16_t code_length = code_end - code_start;
	for (uint16_t i = 0; i < code_length; i++) {
		bitmap_name[i] = message[code_start + i];
	}

	// Allow for lowercase shortcodes as well
	for (uint16_t i = 0; i < code_length; i++) {
		if( uint8_t(bitmap_name[i]) >= 97 && uint8_t(bitmap_name[i]) <= 122 ){ // if in lowercase a-z range
			bitmap_name[i] -= 32; // shift to uppercase A-Z range
		}
	}

	uint32_t index = 0;
	while (index < sizeof(PIXIE_SHORTCODE_LIBRARY)) {
		if (PIXIE_SHORTCODE_LIBRARY[index] >= 200) {
			uint8_t skips = PIXIE_SHORTCODE_LIBRARY[index]-200;
			index += 1; // Skip the mark byte
			skips -= 1;
			
			char first_name_char = PIXIE_SHORTCODE_LIBRARY[index];
			if(bitmap_name[0] == first_name_char){
				memset(bitmap_temp, 0, 32);
				bitmap_temp_index = 0;
				uint32_t bitmap_data_index = index - 6;

				bool end_found = false;
				while (end_found == false) {
					uint8_t val = PIXIE_SHORTCODE_LIBRARY[index];

					bitmap_temp[bitmap_temp_index] = char(val); // Gather chars, even null terminator
					if (val == 0) { // Found end of name
						end_found = true;
					}

					bitmap_temp_index += 1;
					index += 1;
					skips -= 1;
				}
				if (strcmp(bitmap_temp, bitmap_name) == 0) { // If a string match is found:
				
					if(return_code == false){
						color(print_col, cursor_x/display_width, cursor_y/display_height);

						print( // Print column data
							PIXIE_SHORTCODE_LIBRARY[bitmap_data_index + 0],
							PIXIE_SHORTCODE_LIBRARY[bitmap_data_index + 1],
							PIXIE_SHORTCODE_LIBRARY[bitmap_data_index + 2],
							PIXIE_SHORTCODE_LIBRARY[bitmap_data_index + 3],
							PIXIE_SHORTCODE_LIBRARY[bitmap_data_index + 4]
						);
					}
					else{
						temp_code[0] = PIXIE_SHORTCODE_LIBRARY[bitmap_data_index + 0];
						temp_code[1] = PIXIE_SHORTCODE_LIBRARY[bitmap_data_index + 1];
						temp_code[2] = PIXIE_SHORTCODE_LIBRARY[bitmap_data_index + 2];
						temp_code[3] = PIXIE_SHORTCODE_LIBRARY[bitmap_data_index + 3];
						temp_code[4] = PIXIE_SHORTCODE_LIBRARY[bitmap_data_index + 4];
					}
					
					return;
				}
			}
			else{
				index += skips;
				skips = 0;
			}
		}
		else {
			index += 1;
		}
	}
}


void PixieChroma::parse_custom_shortcode( char* message, uint16_t code_start, uint16_t code_end, bool return_code ){
	uint8_t input[10];
	
	for(uint8_t i = 0; i < (code_end-code_start); i++){
		char chr = message[code_start+i];
		
		if     (chr == '0'){ input[i] = 0;  }
		else if(chr == '1'){ input[i] = 1;  }
		else if(chr == '2'){ input[i] = 2;  }
		else if(chr == '3'){ input[i] = 3;  }
		else if(chr == '4'){ input[i] = 4;  }
		else if(chr == '5'){ input[i] = 5;  }
		else if(chr == '6'){ input[i] = 6;  }
		else if(chr == '7'){ input[i] = 7;  }
		else if(chr == '8'){ input[i] = 8;  }
		else if(chr == '9'){ input[i] = 9;  }
		else if(chr == 'A'){ input[i] = 10; }
		else if(chr == 'B'){ input[i] = 11; }
		else if(chr == 'C'){ input[i] = 12; }
		else if(chr == 'D'){ input[i] = 13; }
		else if(chr == 'E'){ input[i] = 14; }
		else if(chr == 'F'){ input[i] = 15; }
	}
	
	uint8_t column_1 = input[1] + (input[0]<<4);
	uint8_t column_2 = input[3] + (input[2]<<4);
	uint8_t column_3 = input[5] + (input[4]<<4);
	uint8_t column_4 = input[7] + (input[6]<<4);
	uint8_t column_5 = input[9] + (input[8]<<4);
	
	if(return_code == false){
		color(print_col, cursor_x/display_width, cursor_y/display_height);

		print( // Print column data
			column_1,
			column_2,
			column_3,
			column_4,
			column_5
		);
	}
	else{
		temp_code[0] = column_1;
		temp_code[1] = column_2;
		temp_code[2] = column_3;
		temp_code[3] = column_4;
		temp_code[4] = column_5;
	}
}


void PixieChroma::scroll_char(char c, uint8_t row){
	add_char(c, (chars_x * display_width)-6, 2+(row*display_height));
	for (uint8_t i = 0; i < 7; i++) {
		shift_mask_x(-1, row);
		if(scroll_type != INSTANT){
			show();
			delay(scroll_frame_delay_ms);
		}
	}
	show();
	delay(scroll_hold_ms);
}


void PixieChroma::scroll_char(uint8_t* bitmap, uint8_t row){
	add_char(bitmap[0], bitmap[1], bitmap[2], bitmap[3], bitmap[4], (chars_x * display_width)-6, 2+(row*display_height));
	for (uint8_t i = 0; i < 7; i++) {
		shift_mask_x(-1, row);
		if(scroll_type != INSTANT){
			show();
			delay(scroll_frame_delay_ms);
		}
	}
	show();
	delay(scroll_hold_ms);	
}


int16_t PixieChroma::calc_justification( t_justification justification, uint8_t row ){
	if(justification == LEFT){
		return 0;
	}
	
	uint8_t x_disp_start = 0;
	uint8_t x_disp_end = 0;

	uint16_t x_led = 0;
	uint16_t x_pos = 0;

	for(int16_t x = 0; x < matrix_width; x++){
		for(int16_t y = (display_height*row); y < (display_height*(row+1)); y++){
			if(mask[ xy(x,y) ] != 0){
				x = matrix_width;
				y = matrix_height;
				break;
			}
			else{
				x_led += 1;
				if(x_led >= (display_width*display_height)){
					x_led = 0;
					x_pos += 1;
				}
			}
		}
	}
	
	x_disp_start = x_pos;
	x_led = 0;
	x_pos = chars_x;
	
	for(int16_t x = matrix_width-1; x > 0; x--){
		for(int16_t y = (display_height*row); y < (display_height*(row+1)); y++){
			if(mask[ xy(x,y) ] != 0){
				x = 0;
				y = matrix_height;
				break;
			}
			else{
				x_led += 1;
				if(x_led >= (display_width*display_height)){
					x_led = 0;
					x_pos -= 1;
				}
			}
		}
	}
	
	x_disp_end = x_pos;
	
	uint8_t length = x_disp_end - x_disp_start;
	int16_t x_offset_chars;
	
	if(length > (chars_x-2)){
		return 0;
	}
	
	if(justification == CENTER){
		x_offset_chars = floor(((chars_x-2) - length) / 2.0);
		
		if((x_offset_chars*2) + length > (chars_x-2)){
			x_offset_chars -= 1;
		}
	}
	else if(justification == RIGHT){
		x_offset_chars = (chars_x-2)-length;
	}
	
	return x_offset_chars * display_width;
}

// (End of user code)

// ##########################################################################################################
// ##########################################################################################################
// ##########################################################################################################
// ##########################################################################################################
// ##########################################################################################################
// ##########################################################################################################
// ##########################################################################################################
// ##########################################################################################################
// ##########################################################################################################
// ##########################################################################################################
// ##########################################################################################################
// ##########################################################################################################
// ##########################################################################################################
// ##########################################################################################################
// ##########################################################################################################
// ##########################################################################################################
// ##########################################################################################################
// ##########################################################################################################
// ##########################################################################################################
// ##########################################################################################################
// ##########################################################################################################
// ##########################################################################################################
// ##########################################################################################################
// ##########################################################################################################
// ##########################################################################################################
// ##########################################################################################################
// ##########################################################################################################
// ##########################################################################################################
// ##########################################################################################################
// ##########################################################################################################

// ---------------------------------------------------------------------------------------------------------|
// -- DEVELOPER FUNCTIONS ----------------------------------------------------------------------------------|
// ---------------------------------------------------------------------------------------------------------|
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
