connornishijima/Pixie_Chroma/(commit log)

2021-10-22 Fixed underscored file problem
    https://stackoverflow.com/questions/34185609/github-pages-github-io-doxygen-generated-page-not-found-404
    [PixieChroma.h, pixie_chroma.cpp]
2021-10-22 Added landing page
2021-10-22 Create arduino-cli_latest
2021-10-22 [ImgBot] Optimize images
    *Total -- 2,450.00kb -> 1,894.86kb (22.66%)
    /docs/search/mag_sel.svg -- 2.32kb -> 0.72kb (68.88%)
    /extras/img/modules_banner.png -- 59.28kb -> 33.52kb (43.45%)
    /docs/search/close.svg -- 1.25kb -> 0.73kb (42.13%)
    /extras/img/vendor.png -- 16.46kb -> 9.88kb (39.98%)
    /extras/img/dimensions_2.jpg -- 225.67kb -> 137.97kb (38.86%)
    /extras/img/dimensions.jpg -- 370.96kb -> 262.90kb (29.13%)
    /extras/img/schematic.jpg -- 652.13kb -> 474.65kb (27.22%)
    /extras/img/timing.jpg -- 170.56kb -> 128.63kb (24.58%)
    /extras/img/pinout.jpg -- 142.99kb -> 116.51kb (18.52%)
    /extras/img/buffer_mapping.jpg -- 169.83kb -> 139.64kb (17.78%)
    /extras/img/application.jpg -- 88.11kb -> 73.98kb (1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
2021-10-28 Uprooted animation ISR system in favor of show() with animation delta and target frame rate
2021-10-29 Fixed duplicate index issue in multi-row XY map
    [pixie_chroma_internal.cpp, pixie_chroma_internal.h]
2021-10-30 Added OSHW PCB
    [PixieChroma.brd, PixieChroma.sch]
2021-10-30 [ImgBot] Optimize images
    *Total -- 249.07kb -> 116.76kb (53.12%)
    /extras/img/schematic.png -- 229.75kb -> 99.70kb (56.6%)
    /docs/doc.png -- 0.73kb -> 0.72kb (0.94%)
    /docs/doxygen.svg -- 15.02kb -> 14.90kb (0.83%)
    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
2021-10-30 [ImgBot] Optimize images
    *Total -- 3,086.04kb -> 2,450.17kb (20.6%)
    /extras/img/buffer_mapping.jpg -- 139.64kb -> 63.97kb (54.19%)
    /extras/img/3d_view.jpg -- 138.94kb -> 65.27kb (53.02%)
    /extras/img/application.jpg -- 73.98kb -> 36.69kb (50.4%)
    /extras/img/timing.jpg -- 128.63kb -> 68.90kb (46.44%)
    /extras/img/dimensions_2.jpg -- 137.97kb -> 74.65kb (45.89%)
    /extras/img/dimensions.jpg -- 262.90kb -> 149.46kb (43.15%)
    /extras/img/schematic.jpg -- 474.65kb -> 271.98kb (42.7%)
    /extras/img/lixielabs.png -- 8.48kb -> 7.21kb (15.04%)
    /extras/img/vendor.png -- 9.48kb -> 8.46kb (10.75%)
    /extras/img/logo_single_line.png -- 56.26kb -> 54.65kb (2.88%)
    /extras/img/close.png -- 2.10kb -> 2.08kb (1.3%)
    /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
2021-11-03 Fixed tabs to spaces
    [pixie_chroma_internal.cpp]
2021-11-03 Updated LED terminology
2021-11-04 Fixed cursor moving rules
    [pixie_chroma_internal.cpp, pixie_chroma_internal.h]
2021-11-04 Repaired ISR and print() bugs
    [pixie_chroma_internal.cpp, pixie_chroma_internal.h]
2021-11-04 Added non-static Ticker callback fix
    [pixie_chroma_internal.cpp]
2021-11-04 Fixed Ticker extern hack
    [pixie_chroma_internal.cpp, pixie_chroma_internal.h]
2021-11-05 Ported Ticker animation for ESP32
2021-11-08 Fixed examples folder structure
    [Unit_Testing.ino]
2021-11-10 Added Printing_Functions.ino, fixed icon cursor issue
    [04_Printing_Functions.ino, pixie_chroma_internal.cpp]
2021-11-11 Fixed wording in minimal sketches headers
    [01_Standard.ino, 02_Quad_Mode.ino]
2021-11-13 Fixed printing functions example for Shortcodes
    [04_Printing_Functions.ino]
2021-11-13 Fixed Getting_Started example for Shortcodes
    [01_Getting_Started.ino]
2021-11-13 Shortcode speedup with special mark integers in lookup table
    [pixie_chroma_internal.cpp]
2021-11-13 Shortcode library fix for special markers
    [pixie_chroma_internal.cpp, pixie_chroma_internal.h]
2021-11-15 Added power budgeting example
2021-11-15 Added gamma correction example
    [09_Gamma_Correction.ino]
2021-11-16 [ImgBot] Optimize images
    *Total -- 8,593.46kb -> 8,582.43kb (0.13%)
    /extras/OSHW/oshw_facts.svg -- 8.83kb -> 7.54kb (14.55%)
    /extras/img/apple_icon.png -- 35.35kb -> 34.32kb (2.9%)
    /extras/img/hello_world.png -- 4,418.37kb -> 4,414.97kb (0.08%)
    /extras/img/PCB_SINGLE.png -- 4,111.60kb -> 4,108.53kb (0.07%)
    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
2021-12-03 Added Teensy 3.x Support!
2021-12-03 Fixed Teensy pin mappings
    [pixie_chroma_internal.cpp]
2021-12-03 Renamed NUM_LEDS to led_count for consistency
2021-12-03 Added print_color() functionality
2021-12-03 Fixed set_palette behavior with custom print colors
    [pixie_chroma_internal.cpp, pixie_chroma_internal.h]
2021-12-04 Shortcodes now work in lowercase too
    [pixie_chroma_internal.cpp]
2021-12-14 Added Custom Shortcode support!
    [pixie_chroma_internal.cpp, pixie_chroma_internal.h]
2021-12-28 Added EAGLE OSHW library files!
    [PIXIE_CHROMA_EVAL_PCB.brd, PIXIE_CHROMA_EVAL_PCB.sch]
2021-12-28 Updated EAGLE library and eval PCB with better pads
    [PIXIE_CHROMA_EVAL_PCB.brd, PIXIE_CHROMA_EVAL_PCB.sch]
2021-12-28 Labeled schematic with license info
    [PIXIE_CHROMA_EVAL_PCB.sch]
2021-12-28 Added STL Model
    [Pixie_Chroma.stl]
2022-03-28 Added final Shortcodes example code
    [06_Shortcode_Library.ino]
2022-04-07 Clarified supported platforms in compile error message
    [Pixie_Chroma.h]
2022-04-14 Swapped arduino IDE photo
2022-04-14 Added Arduino Library images
2022-04-14 [ImgBot] Optimize images
    *Total -- 19,856.99kb -> 19,161.27kb (3.5%)
    /extras/img/ports_connected.png -- 34.40kb -> 19.74kb (42.62%)
    /extras/img/ports_empty.png -- 32.07kb -> 18.49kb (42.34%)
    /extras/img/arduino_example_location.png -- 106.06kb -> 64.62kb (39.08%)
    /extras/img/arduino_minimal.png -- 85.02kb -> 54.76kb (35.59%)
    /extras/img/arduino_upload.png -- 13.51kb -> 9.76kb (27.8%)
    /extras/img/arduino_library_manager.jpg -- 67.19kb -> 55.75kb (17.03%)
    /extras/img/arduino_board_install.jpg -- 257.82kb -> 215.79kb (16.3%)
    /extras/img/getting_started_code.jpg -- 163.30kb -> 137.03kb (16.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
2022-04-15 Added wiring images
2022-04-15 fixed wiring line
2022-04-15 Reverted delay name change
    [pixie_chroma_internal.cpp, pixie_chroma_internal.h]
2022-04-15 [ImgBot] Optimize images
    *Total -- 2,531.12kb -> 2,285.57kb (9.7%)
    /extras/img/wiring3.jpg -- 430.86kb -> 374.74kb (13.03%)
    /extras/img/wiring4.jpg -- 446.69kb -> 389.05kb (12.9%)
    /extras/img/wiring1.jpg -- 505.54kb -> 462.46kb (8.52%)
    /extras/img/wiring5.jpg -- 481.24kb -> 441.17kb (8.33%)
    /extras/img/wiring2.jpg -- 620.22kb -> 574.24kb (7.41%)
    /extras/img/breadboard.jpg -- 46.58kb -> 43.91kb (5.73%)
2022-04-19 Documentation expansion/terminology corrections for basic functions
    [pixie_chroma_internal.cpp]
2022-04-19 Added Shortcodes to Getting Started guide
    [pixie_chroma_internal.cpp]
2022-04-19 Fixed color animation function naming
    [03_Set_Palette.ino, 07_Animation.ino, 09_Gamma_Correction.ino, 10_Update_Modes.ino, Unit_Testing.ino, pixie_chroma_internal.h]
2022-04-21 Added "view directly" button to docs site for ease of printing
2022-04-23 Added "about" landing page
2022-04-24 [ImgBot] Optimize images
    *Total -- 5,084.40kb -> 4,737.22kb (6.83%)
    /extras/img/rm5.jpg -- 287.36kb -> 240.83kb (16.19%)
    /extras/img/rm4.jpg -- 265.08kb -> 226.88kb (14.41%)
    /extras/img/wiring3.jpg -- 193.85kb -> 174.88kb (9.78%)
    /extras/img/wiring4.jpg -- 200.70kb -> 181.78kb (9.43%)
    /extras/img/schematic.png -- 1,437.01kb -> 1,323.08kb (7.93%)
    /extras/img/wiring1.jpg -- 250.07kb -> 232.91kb (6.86%)
    /extras/img/wiring5.jpg -- 232.28kb -> 218.06kb (6.12%)
    /extras/img/instructions_model.png -- 718.47kb -> 675.67kb (5.96%)
    /extras/img/wiring2.jpg -- 255.04kb -> 240.19kb (5.82%)
    /extras/im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
2022-04-27 Open char_buf length issue
    [pixie_chroma_internal.cpp]
