connornishijima/Pixie_Chroma/(notices)

Notices in the files:
parts and their libraries:
PixieChroma: (c) 2021 - CERN-OHL-W-2.0 LICENSE
